MH-Bio/vaccine_dispenser/Final report/IMG_4544.JPG

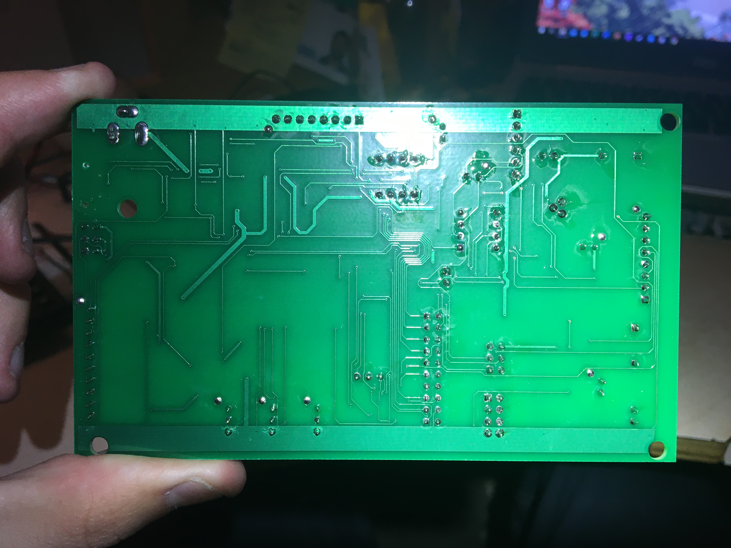
Final report/IMG_4544.JPG
