MH-Bio/vaccine_dispenser/Final report/Motor Driver.jpg

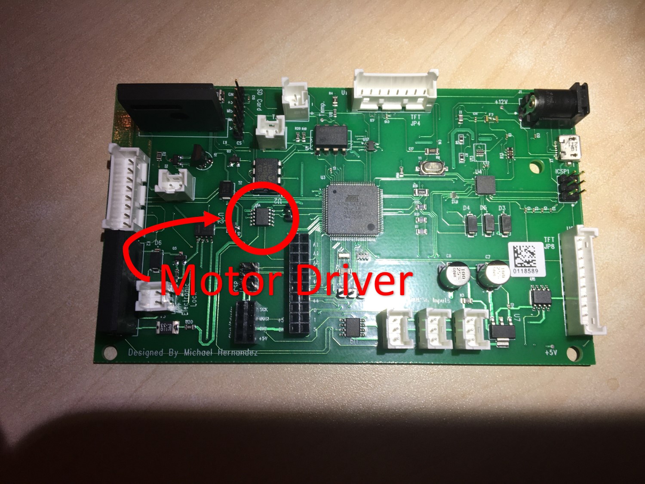
Final report/Motor Driver.jpg
