MH-Bio/vaccine_dispenser/Adarfuit Keypad Pinout.xlsx

 |  |  | NC | Row 4 | Row 3 | Row 2 | Row 1 | Column 3 | Column 2 | Column 1
# | 0 | * | 8 | 7 | 6 | 5 | 4 | 3 | 2 | 1
9 | 8 | 7 |  |  |  | 6 |  | 6
6 | 5 | 4 |  |  |  |  | 3 | 3
3 | 2 | 1 |  | # |  |  |  | #
 |  |  |  |  | 9 |  |  | 9
 |  |  |  |  |  |  | 1 |  |  | 1
 |  |  |  |  |  | 4 |  |  |  | 4
 |  |  |  |  | 7 |  |  |  |  | 7
 |  |  |  | * |  |  |  |  |  | *
 |  |  |  | 0 |  |  |  |  | 0
 |  |  |  |  | 8 |  |  |  | 8
 |  |  |  |  |  | 5 |  |  | 5
 |  |  |  |  |  |  | 2 |  | 2
