MH-Bio/vaccine_dispenser/Datasheets/lm317-linear-power-supply-regulator-15v3v45v5v6v9v_15a-1.jpg

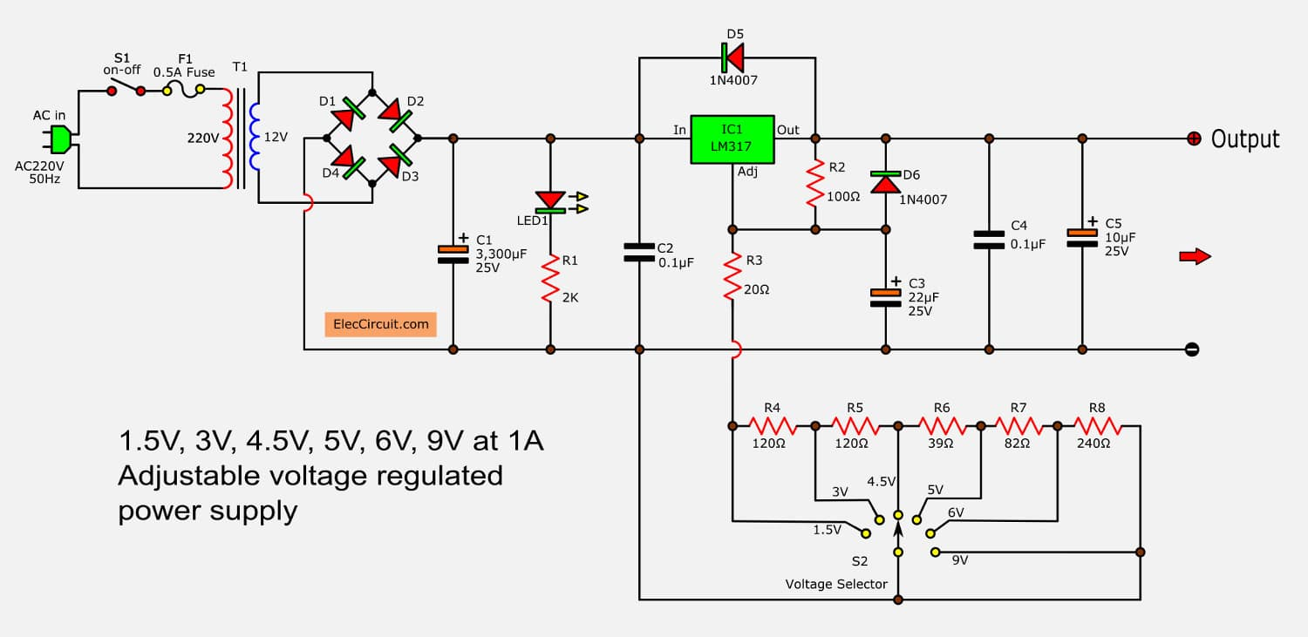
Datasheets/lm317-linear-power-supply-regulator-15v3v45v5v6v9v_15a-1.jpg
