MH-Bio/vaccine_dispenser/Datasheets/lock schematic.png

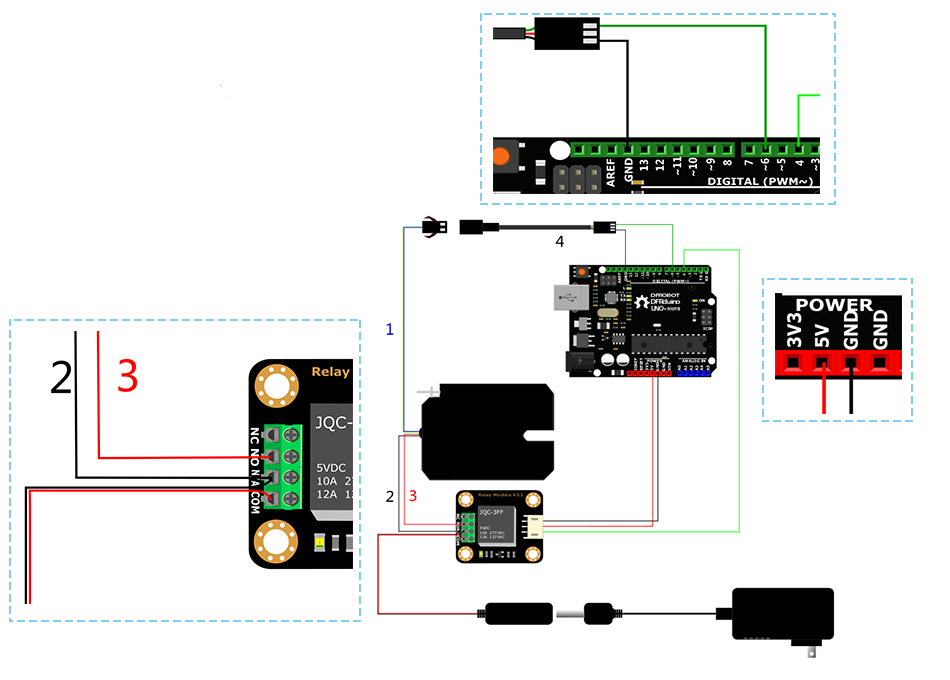
Datasheets/lock schematic.png
