MH-Bio/vaccine_dispenser/Final report/IMG_4545.JPG

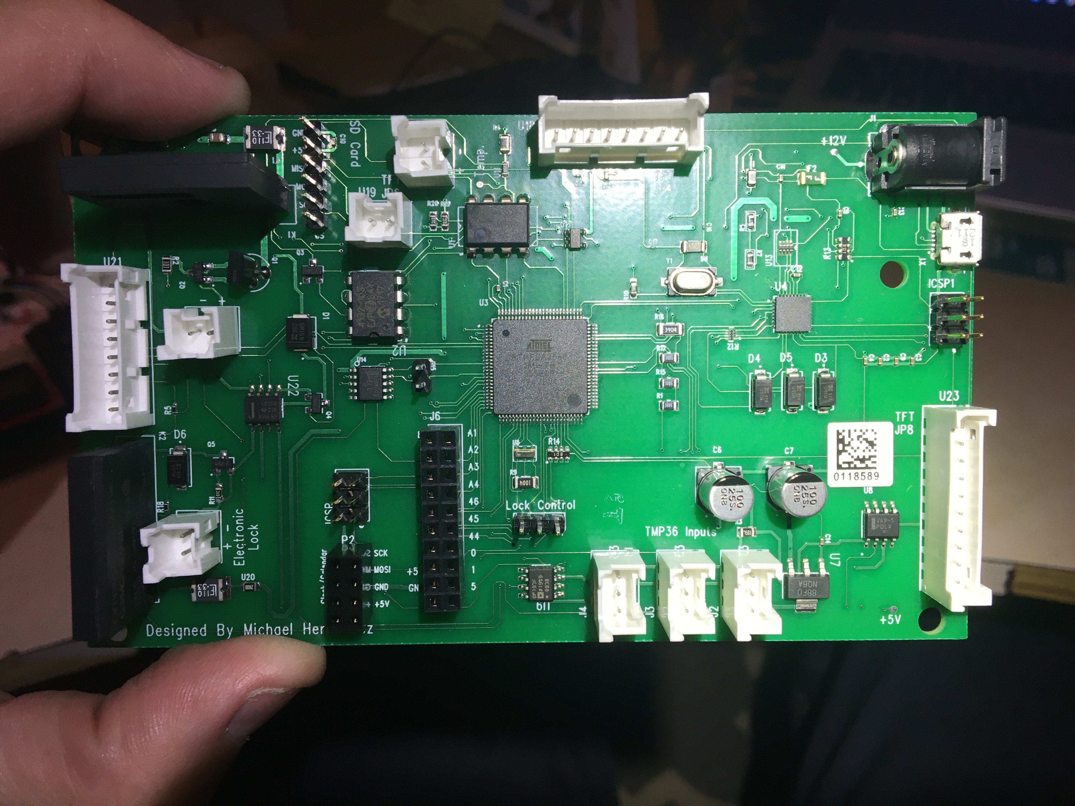
Final report/IMG_4545.JPG
