MH-Bio/vaccine_dispenser/Final report/Paper Images/charge controller prototype.JPG

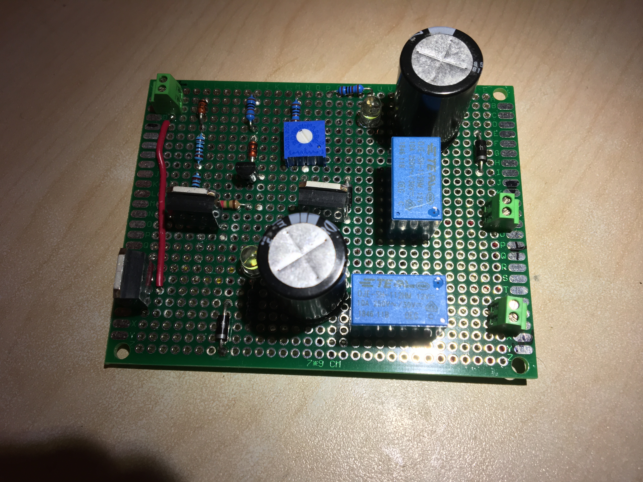
Final report/Paper Images/charge controller prototype.JPG
