MH-Bio/vaccine_dispenser/Final report/Paper Images/Cross Section 2.jpg

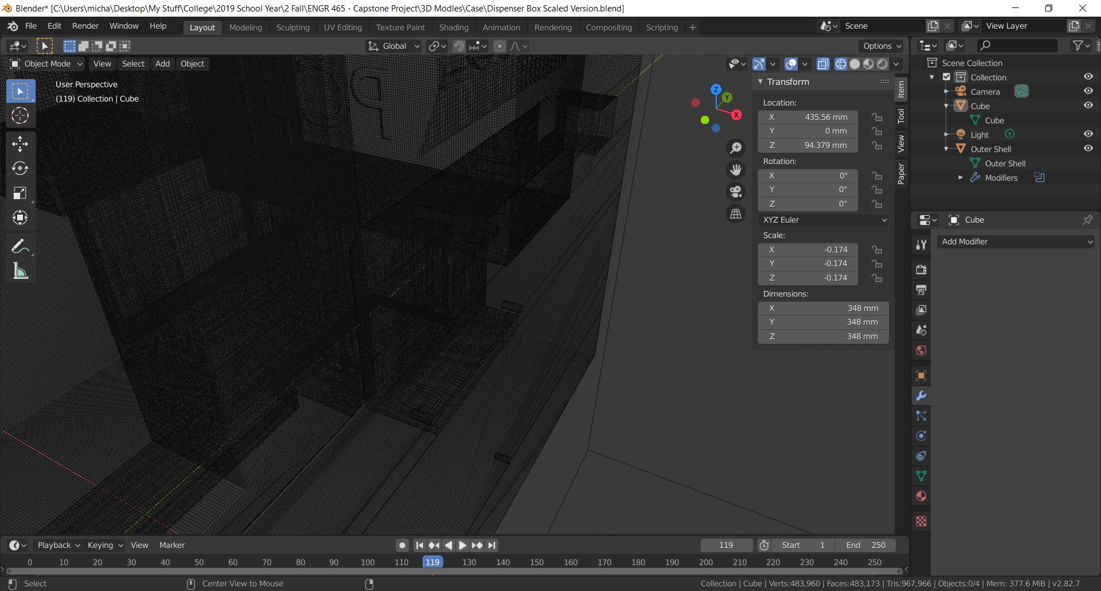
Final report/Paper Images/Cross Section 2.jpg
