MH-Bio/vaccine_dispenser/Final report/Paper Images/Cross Section 3.jpg

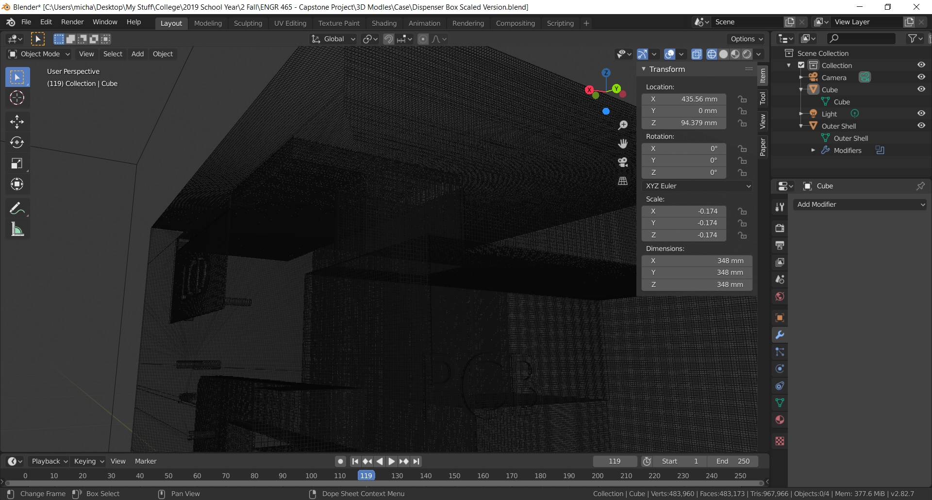
Final report/Paper Images/Cross Section 3.jpg
