MH-Bio/vaccine_dispenser/Final report/Paper Images/Cross Section 4.jpg

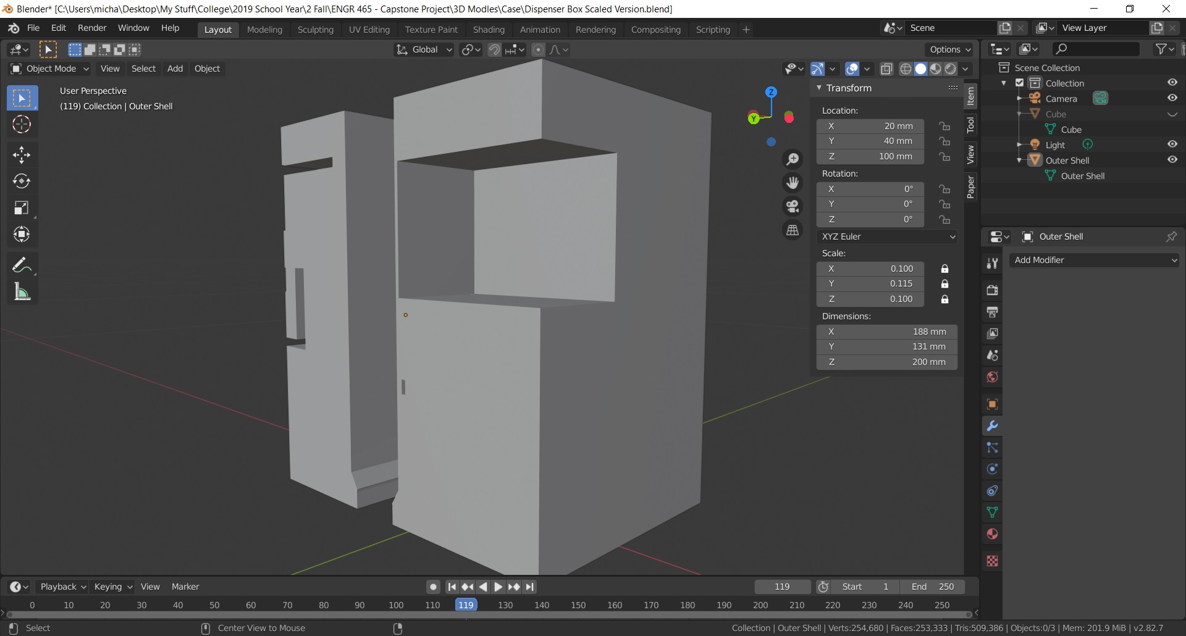
Final report/Paper Images/Cross Section 4.jpg
