MH-Bio/vaccine_dispenser/Final report/Paper Images/Cross Section 5.jpg

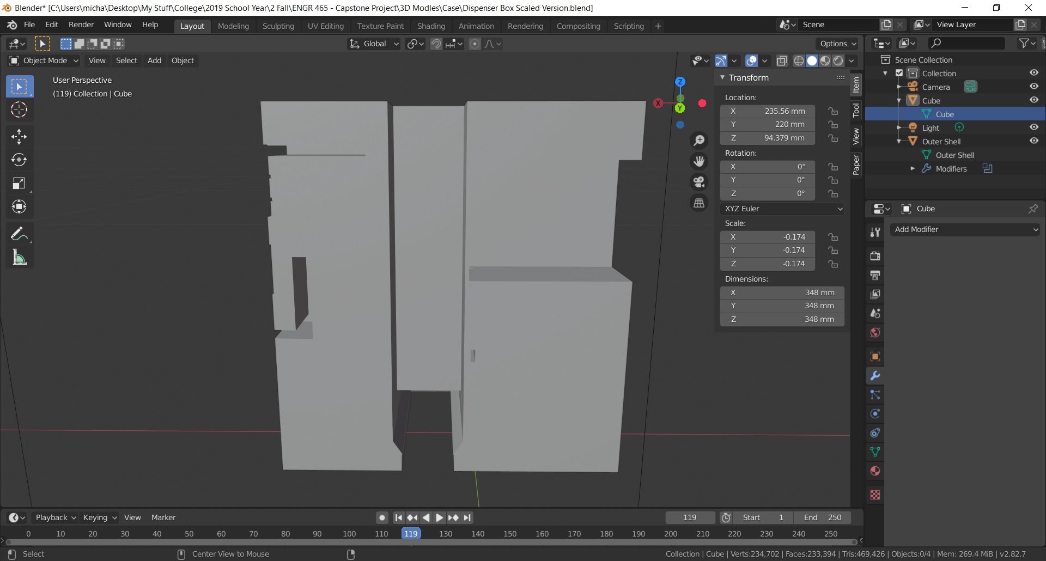
Final report/Paper Images/Cross Section 5.jpg
