MH-Bio/vaccine_dispenser/Final report/Paper Images/PCB Bottom Layer.JPG

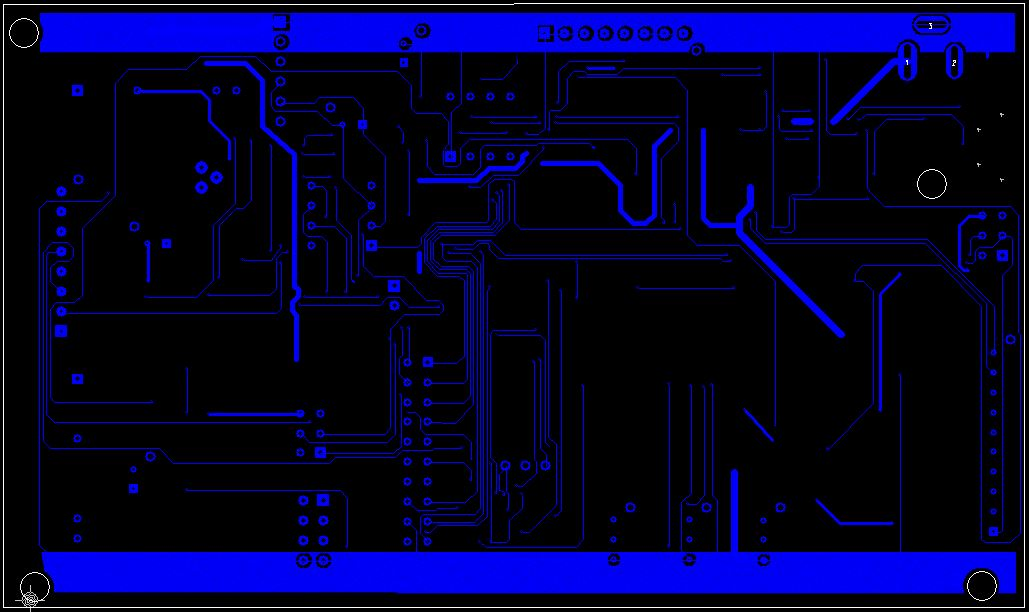
Final report/Paper Images/PCB Bottom Layer.JPG
