MH-Bio/vaccine_dispenser/Final report/Paper Images/PCB Top Layer.JPG

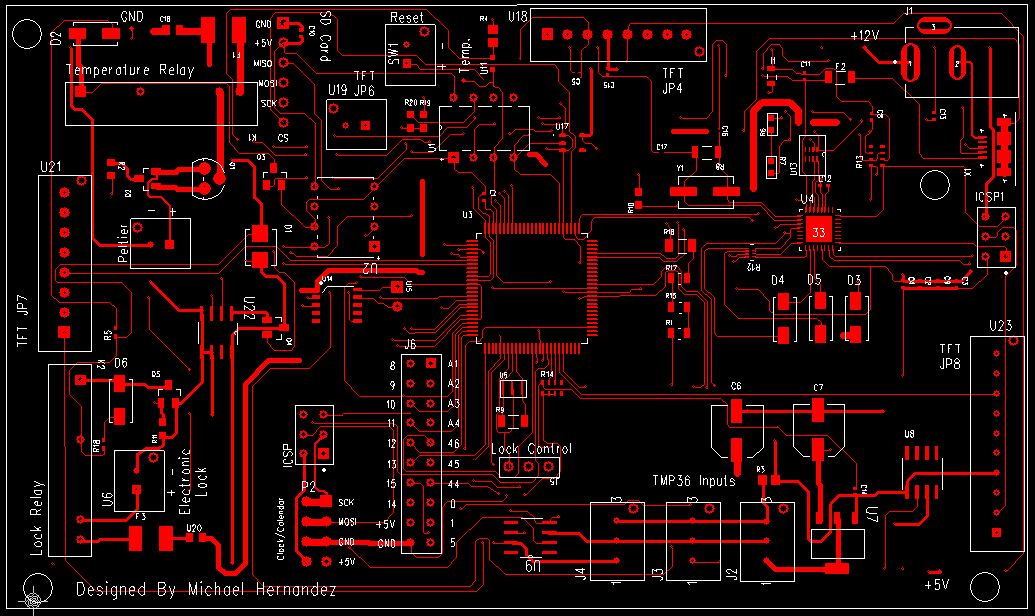
Final report/Paper Images/PCB Top Layer.JPG
