MH-Bio/vaccine_dispenser/Final report/Paper Images/Pseudocode Flowchart.jpg

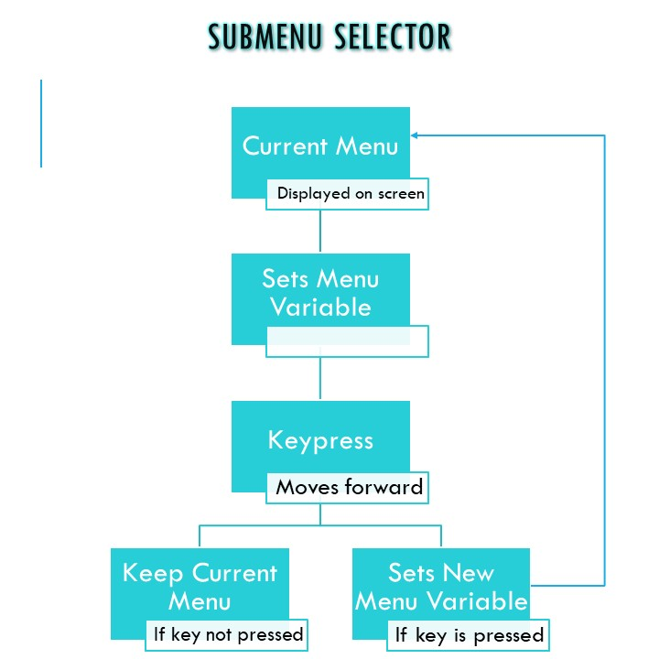
Final report/Paper Images/Pseudocode Flowchart.jpg
