MH-Bio/vaccine_dispenser/Final report/Paper Images/Reccomended TMP36 Circuit.JPG

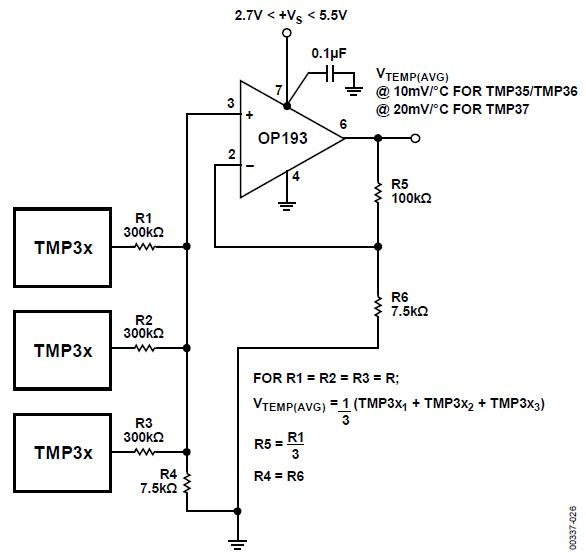
Final report/Paper Images/Reccomended TMP36 Circuit.JPG
