MH-Bio/vaccine_dispenser/Final report/Paper Images/reset button back.jpg

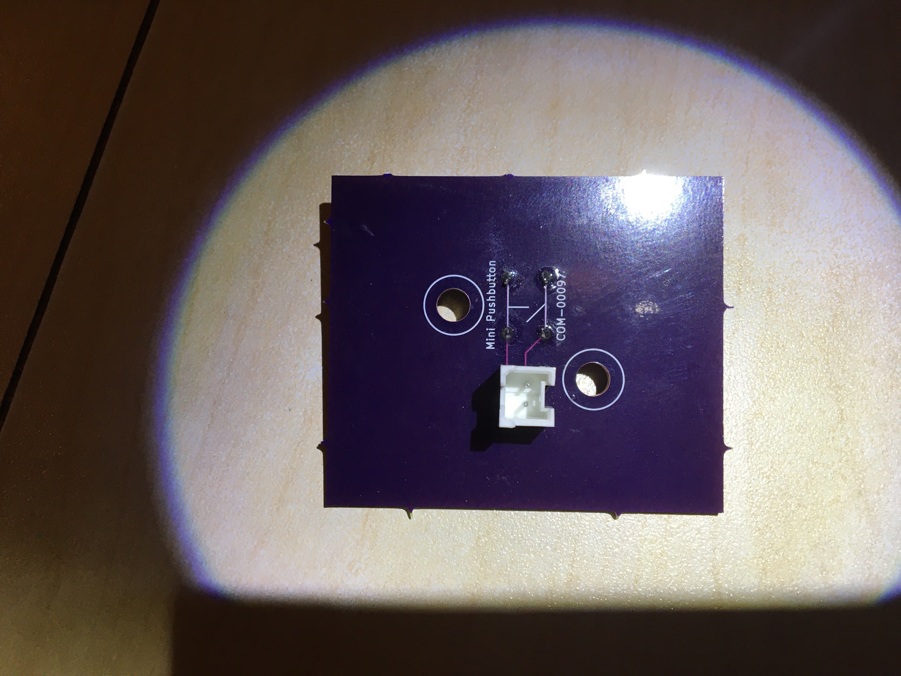
Final report/Paper Images/reset button back.jpg
