MH-Bio/vaccine_dispenser/Final report/Paper Images/reset button front.jpg

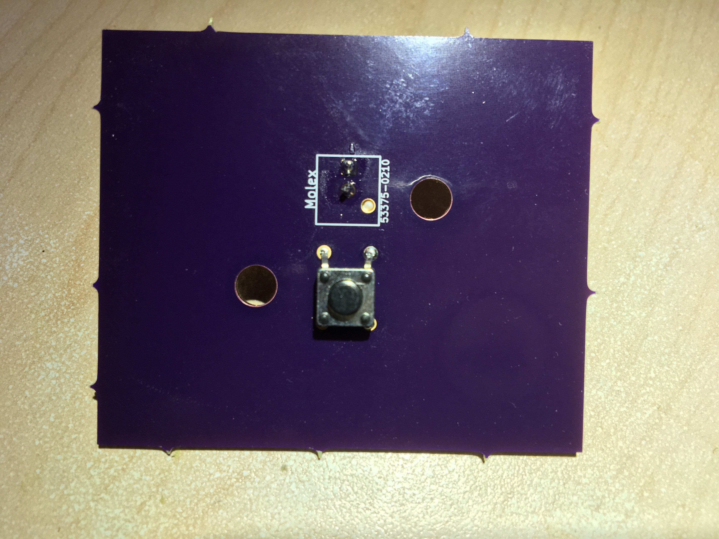
Final report/Paper Images/reset button front.jpg
