MH-Bio/vaccine_dispenser/Final report/Paper Images/TMP36 PCB.jpg

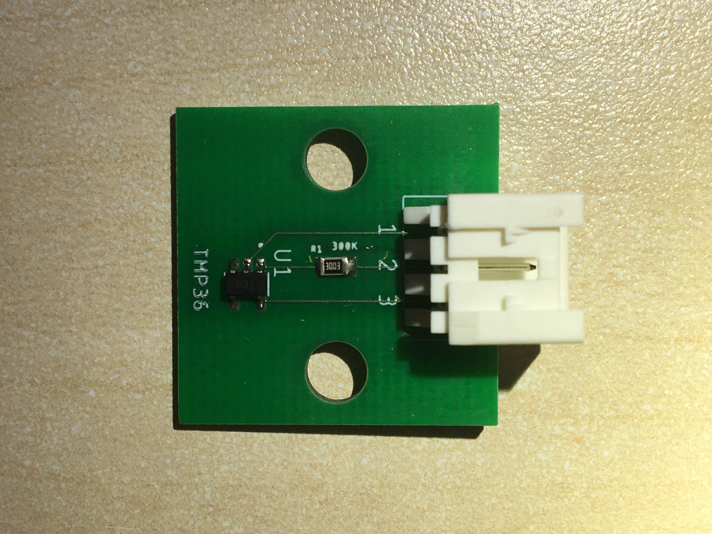
Final report/Paper Images/TMP36 PCB.jpg
