MH-Bio/vaccine_dispenser/Final report/Poster Images/cooling.jpg

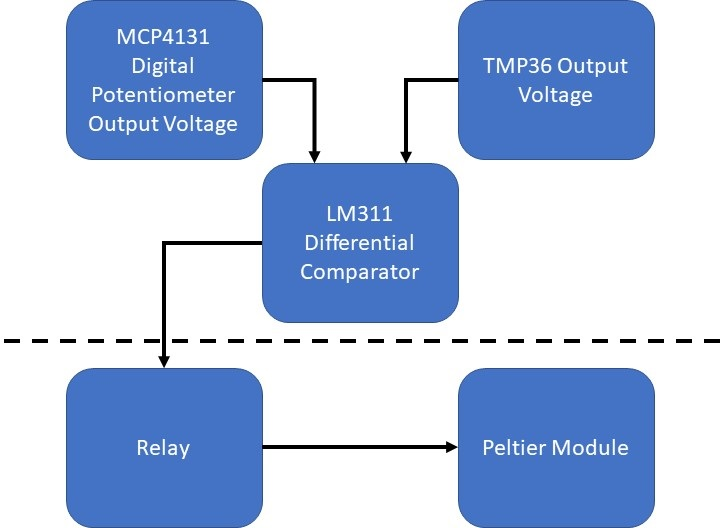
Final report/Poster Images/cooling.jpg
