MH-Bio/vaccine_dispenser/Final report/Poster Images/IMG_4513.JPG

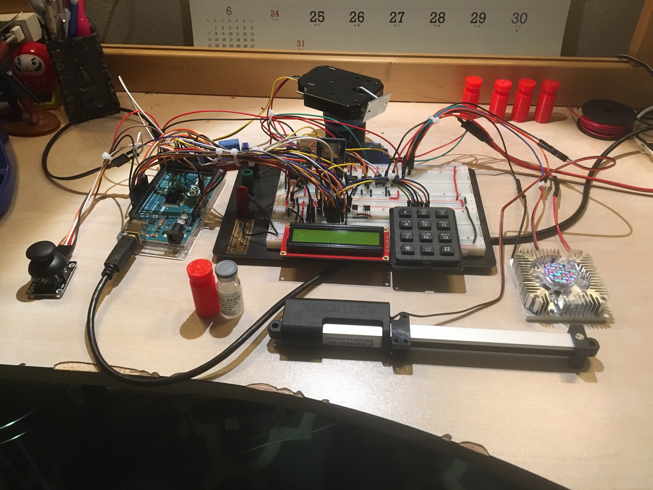
Final report/Poster Images/IMG_4513.JPG
