MH-Bio/vaccine_dispenser/Final report/Poster Images/IMG_4514.JPG

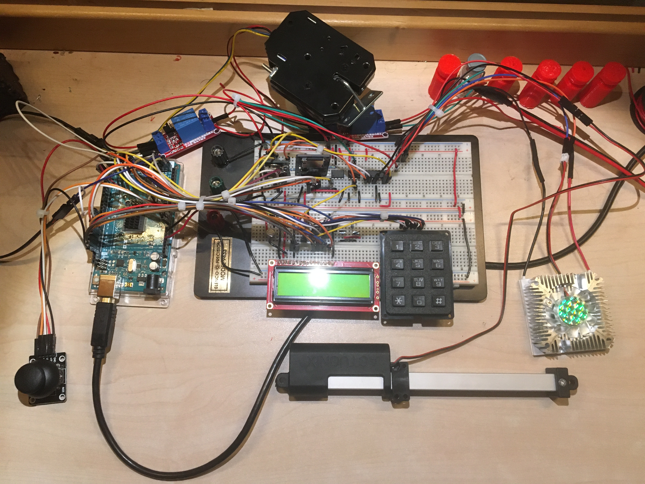
Final report/Poster Images/IMG_4514.JPG
