MH-Bio/vaccine_dispenser/Final report/Poster Images/PCB.jpg

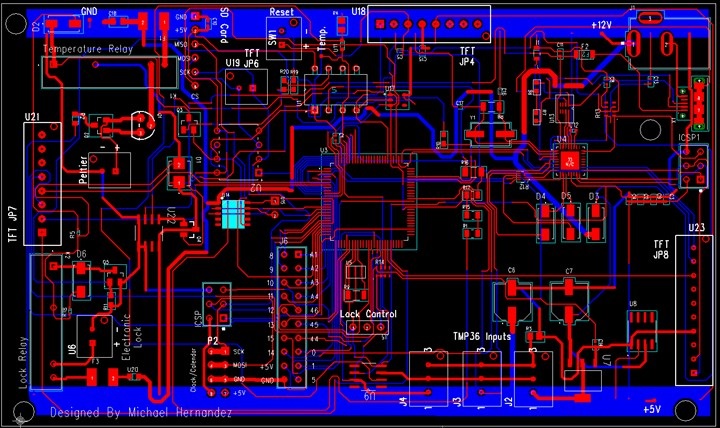
Final report/Poster Images/PCB.jpg
