MH-Bio/vaccine_dispenser/Final report/Poster Images/Report Figures.jpg

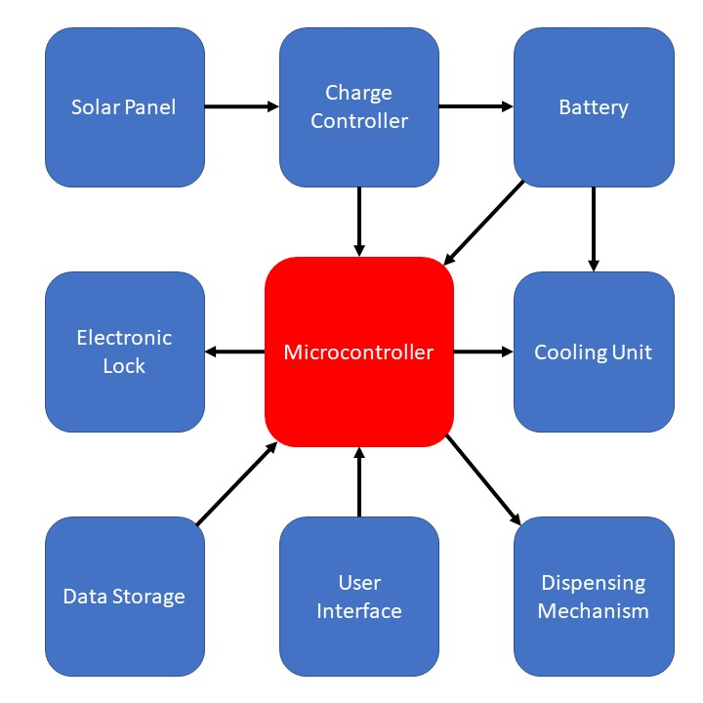
Final report/Poster Images/Report Figures.jpg
