MH-Bio/vaccine_dispenser/Final report/Poster Images/Track Acuator.png

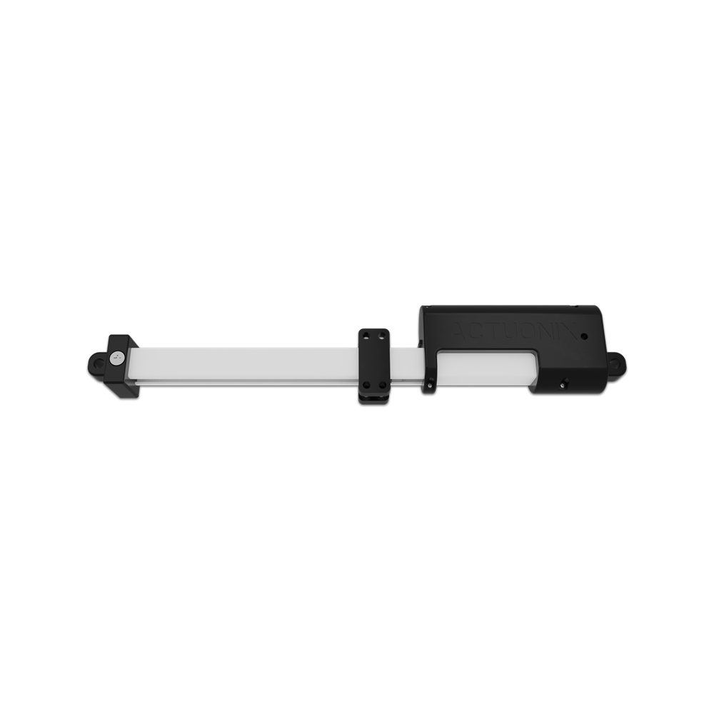
Final report/Poster Images/Track Acuator.png
