MH-Bio/vaccine_dispenser/Final report/Sizing.jpg

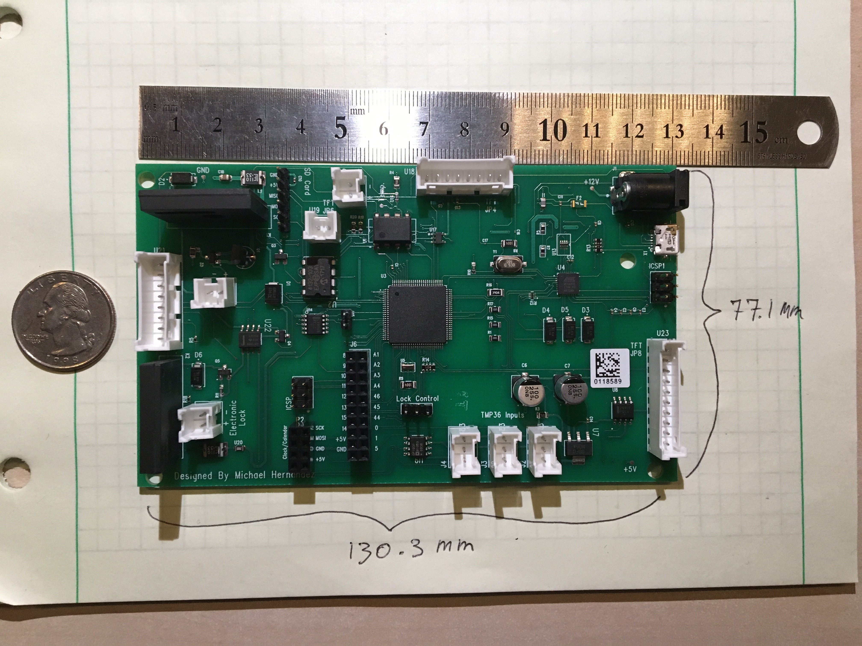
Final report/Sizing.jpg
