MH-Bio/vaccine_dispenser/Schematics/LED_sub_module.png

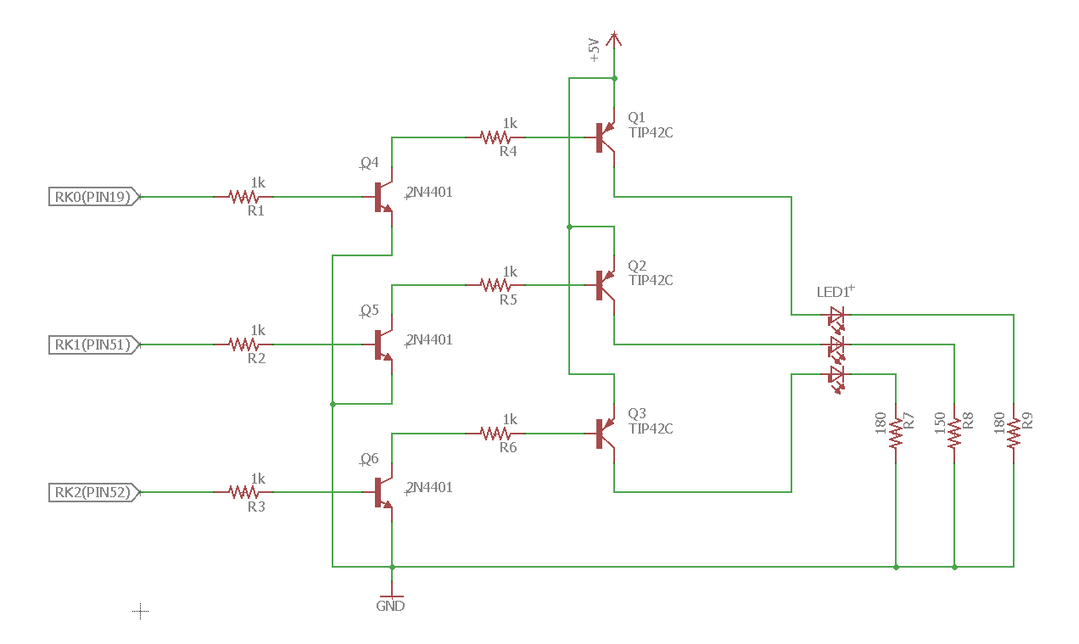
Schematics/LED_sub_module.png
