MH-Bio/vaccine_dispenser/Schematics/Solar Charge Controller/FEUT6J9ITV5755X.LARGE.jpg

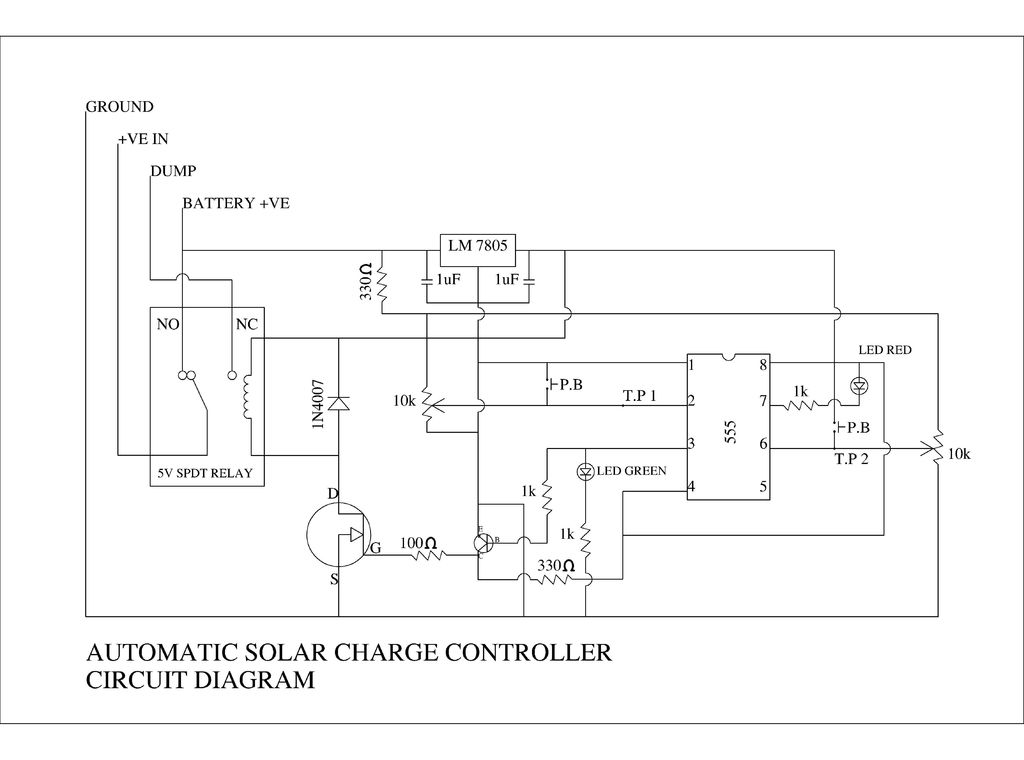
Schematics/Solar Charge Controller/FEUT6J9ITV5755X.LARGE.jpg
