MH-Bio/vaccine_dispenser/Bill of Materials.xlsx

Bill of material
Part | Manufacturer | Quantity | Price | Total | Notes
T16-S | Actuonix | 1 | $80.00 | $80.00 | Track Acuator
1216 | Energizer | 1 | $3.44 | $3.44 | Watch battery for clock
8541607316 | caryshop | 1 | $9.00 | $9.00 | Heatsink / Fan
12 V 20 A Charge Controller | GHB | 1 | $34.99 | $34.99 | Charge Controller
1824 Keypad | Adafruit | 1 | $10.34 | $10.34 | Adafruit Keypad
18965 Relay | SainSmart | 1 | $15.99 | $15.99 | Solid State Relay
8 GB microSDHC | Kingston | 1 | $3.99 | $3.99 | SD Card
AM-L02P25-1 | ECO-WORTHY | 1 | $38.78 | $38.78 | Solar Pannel
CP4055485 | CUI Devices | 1 | $71.61 | $71.61 | Peltier Module
CT6EP103 | Nidec Copal Electronics | 1 | $0.78 | $0.78 | 10K Analog Potentiometer
EXP1270 | ExpertPower | 1 | $18.99 | $18.99 | Battery
FIT0620 | DFRobot | 1 | $7.98 | $7.98 | Electronic Lock
GDM1602K | XIAMEN OCULAR | 1 | $16.95 | $16.95 | LCD Screen
LM311 | Texas Instruments | 1 | $0.50 | $0.50 | Differential Comparator
MCP41X1 | Microchip | 1 | $1.50 | $1.50 | Digital Potentiometer
MEGA 2560 | Arduino | 1 | $38.50 | $38.50 | Arduino
Micro SD Card Module | diymore | 1 | $1.70 | $1.70 | SD Card Mount
Pmod RTCC | Digilent | 1 | $8.99 | $8.99 | Real-time Clock / Calendar
TMP36 | Analog Devices | 1 | $1.50 | $1.50 | Temperature Sensor
WMYCONGCONG-13 | WMYCONGCONG | 1 | $1.30 | $1.30 | Joystick
 |  |  | Total | $366.83
