MH-Bio/vaccine_dispenser/Final report/PCB Bill of Materials.xlsx

Sheet: PCB BOM
Row Number | Part Number | Description | Manufacturer | Package | Reference | Price | Quantity | Total | Digikey Part Number
1 | 475890001 | Conn Micro USB Type AB RCP 5 POS 0.65mm Solder RA SMD 5 Terminal 1 Port T/R | MOLEX | MOLEX_0475890001 | X1 | $0.78 | 1 | $0.78 | WM17143CT-ND
2 | 61300311121 | Connector Header Through Hole 3 position 0.100" (2.54mm) | Würth Elektronik | 61300311121 | J5 | $0.13 | 1 | $0.13 | 732-5316-ND
3 | 61300611121 | Connector Header Through Hole 6 position 0.100" (2.54mm) | Würth Elektronik | 1X6 PIN CONNECTOR | P1 | $0.33 | 1 | $0.33 | 732-5319-ND
4 | 1812L110/33MR | Polymeric PTC Resettable Fuse 33V 1.1A Ih Surface Mount 1812 (4532 Metric), Concave | Littelfuse Inc. | 1812 | F3, F1 | $0.59 | 2 | $1.18 | F3486DKR-ND
5 | 3413.0113.22 | FUSE 500MA 63VDC FAST 1206 SMD | Schurter | FUS1206_24N_SCH | F2 | $0.60 | 1 | $0.60 | 3413.0113.22-ND
6 | 53375-0210 | Molex 2 pin vertical connector which will be used for peltier module | Molex | PELTIER_MODULE | PEL1, SW1 | $0.34 | 2 | $0.68 | WM3421-ND
7 | 53375-0210 | Connector Header Through Hole 2 position 0.098" (2.50mm) | Molex | 2 PIN VERTICAL MOLEX | U6, U19 | $0.34 | 2 | $0.68 | WM3421-ND
8 | 53375-0310 | Connector Header Through Hole 3 position 0.098" (2.50mm) | Molex | 53375-0310 | J2, J3, J4 | $0.43 | 3 | $1.29 | WM9816-ND
9 | 53375-0810 | Connector Header Through Hole 8 position 0.098" (2.50mm) | Molex | 8 PIN MOLEX | U21, U18 | $0.67 | 2 | $1.34 | WM13263-ND
10 | 53375-1010 | Connector Header Through Hole 10 position 0.098" (2.50mm) | Molex | MOLEX 10 PIN | U23 | $0.75 | 1 | $0.75 | WM12778-ND
11 | 6-534206-0 | 20 Position Receptacle Connector Through Hole | TE Connectivity AMP Connectors | TE_6-534206-0 | J6 | $4.68 | 1 | $4.68 | 6-534206-0
12 | 67997-206HLF | Conn; Rect; UnshroudedHdr; 6Cnts; ThruHole; BergStik; 2.54mmPin-Spng; Vert; DblRow | Raltron Electronics | FRAMATOME_67997-206HLF | ICSP1, ICSP | $0.66 | 2 | $1.32 | 2151-AS-16.000-18-ND
13 | ATMEGA2560 | Semiconductors and Actives, ic, Microprocessors, mcu, Microcontrollers | Microchip Technology | QFP50P1600X1600X120-100N | U3 | $11.85 | 1 | $11.85 | ATMEGA2560-16AU-ND
14 | ATMEGA8U2-MU | AVR AVR® ATmega Microcontroller IC 8-Bit 16MHz 8KB (4K x 16) FLASH 32-VQFN (5x5) | Microchip | QFN50P500X500X100-33N | U4 | $2.44 | 1 | $2.44 | ATMEGA8U2-MU-ND
15 | BLM21PG221SN1D | FERRITE CHIP 220 OHM 2000MA 0805 | Murata Electronics North America | IND0805N | I1 | $0.10 | 1 | $0.10 | 490-1054-2-ND
16 | C0402C105K9PACTU | CAP CERM 1UF 6.3V X5R 0402 | Kemet | CC0402N | C12 | $0.10 | 1 | $0.10 | 399-4873-2-ND
17 | CAY16-103J4LF | 10k Ohm }5% 62.5mW Power Per Element Isolated Resistor Network/Array }200ppm/ ‹C 1206 (3216 Metric), Convex, Long Side Terminals | Bourns Inc. | CAY16-J4 | R13, R14 | $0.10 | 2 | $0.20 | CAY16-103J4LFCT-ND
18 | CC0201JRNPO9BN220 | 22pF ±5% 50V Ceramic Capacitor C0G, NP0 0201 (0603 Metric) | Yageo | CAPC0201X13N | C5, C16, C17 | $0.10 | 3 | $0.30 | 311-1383-1-ND
19 | CL21A106KOQNNNG | 10µF ±10% 16V Ceramic Capacitor X5R 0805 (2012 Metric) | Samsung Electro-Mechanics | CAPC2012X140N | C18 |  | 1 |  | 1276-6455-2-ND
20 | CRCW080510M0DHEAP | 10 MOhms ±0.5% 0.125W, 1/8W Chip Resistor 0805 (2012 Metric) Automotive AEC-Q200 Thick Film | Vishay Dale | RESC2012X50N | R1, R15, R17 | $0.29 | 3 | $0.87 | 541-10MAZCT-ND
21 | CSTNE16M0V530000R0 | 16MHz Ceramic Resonator Built in Capacitor 15pF ±0.3% 40 Ohms -40°C ~ 85°C Surface Mount | Murata Electronics | CSTCE16M0V53-R0 | U5 | $0.29 | 1 | $0.29 | 490-17948-1-ND
22 | ECS-160-20-3X-TR | SMD QUARTZ CRYSTAL | Raltron Electronics | XTAL_ECS-160-20-3X-TR | Y1 | $0.66 | 1 | $0.66 | 2151-AS-16.000-18-ND
23 | EEE-1EA101XP | 100µF 25V Aluminum Electrolytic Capacitors Radial, Can - SMD 2000 Hrs @ 85°C | Panasonic Electronic Components | CAPAE660X800N | C6, C7 | $0.47 | 2 | $0.94 | PCE3898CT-ND
24 | ERA-3AEB104V | RES 100K OHM 1/10W .1% 0603 SMD | Panasonic - ECG | RC0603N | U11 | $0.34 | 1 | $0.34 | P100KDBTR-ND
25 | EXB-18V102JX | 1k Ohm }5% 31mW Power Per Element Isolated Resistor Network/Array }200ppm/ ‹C 0502 (1406 Metric), Long Side Terminals | Panasonic Electronic Components | RESCAXE40P140X60X45-8N | R12 | $0.10 | 1 | $0.10 | Y6102CT-ND
26 | EXB-28V220JX | RES ARRAY 22 OHM 5% 4 RES SMD | Panasonic - ECG | RN-EXB-28V | U13 | $0.10 | 1 | $0.10 | Y7220TR-ND
27 | FDN340P | P-Channel MOSFET Logic Level, PowerTrench MOSFET | Raltron Electronics | SSOT-3 | Q4 | $0.66 | 1 | $0.66 | 2151-AS-16.000-18-ND
28 | G3MC-202P DC5 | SSR RELAY SPST-NO 2A 75-264V | Omron Automation and Safety | RELAY_G3MB202PDC12 | K1, K2 | $6.96 | 2 | $13.92 | Z2985-ND
29 | GRM155R62A104KE14D | CAP CER 0.1UF 100V X5R 0402 | Murata Electronics | CAPC1005X55N | C1, C2, C3, C4, C8, C9, C10, C11, C13, C14, C15 | $0.66 | 11 | $7.26 | 2151-AS-16.000-18-ND
30 | LM1117MPX-5.0NOPB | IC REG LDO 800MA 3.3V | Raltron Electronics | SOT230P696X180-4N | U7 | $0.66 | 1 | $0.66 | 2151-AS-16.000-18-ND
31 | LM311P | IC DIFF COMP W/STROBE 8DIP | Texas Instruments | DIP8_300 | U1 | $0.51 | 1 | $0.51 | 296-1389-5-ND
32 | LM358DR | General Purpose Amplifier 2 Circuit 8-SOIC | Texas Instruments | SOIC127P600X175-8N(1) | U22 | $0.36 | 1 | $0.36 | 296-1014-6-ND
33 | LP2985-33DBVR | LP2985 150-mA Low-noise Low-dropout Regulator With Shutdown | Raltron Electronics | SOT95P280X145-5N | U17 | $0.66 | 1 | $0.66 | 2151-AS-16.000-18-ND
34 | LV8548MC-AH | 310030259 |  | SOIC10-1.0-5X4MM | U14 | $1.29 | 1 | $1.29
35 | MC33269D-5.0G | Linear Voltage Regulator IC 1 Output 800mA 8-SOIC | ON Semiconductor | SOIC127P600X265-8N | U8 | $0.81 | 1 | $0.81 | MC33269D-5.0GOS-ND
36 | MCP4132-103E/P | Single/Dual SPI Digital POT | Microchip Technology | DIP254P762X533-8 | U2 | $0.67 | 1 | $0.67
37 | MMBT3904 | MMBT3904 Series 40 V CE Breakdown 0.2 A NPN General Purpose Amplifier - SOT-23 | Diodes Incorporated | SOT95P240X120-3N | Q2, Q3, Q5 | $0.12 | 3 | $0.36 | MMBT3904-FDITR-ND
38 | OP193FSZ | Precision Operational Amplifiers | Raltron Electronics | SOIC127P600X175-8N | U9 | $0.66 | 1 | $0.66 | 2151-AS-16.000-18-ND
39 | PJ-202A | 2.0 mm Center Pin, 2.5 A, Right Angle, Through Hole, Kinked Pins, Dc Power Jack Connector | Raltron Electronics | CUI_PJ-202A | J1 | $0.66 | 1 | $0.66 | 2151-AS-16.000-18-ND
40 | PPPC042LFBN-RC | 8 Position Header Connector Through Hole | Sullins Connector Solutions | PPPC042LFBN-RC | P2 | $7.81 | 1 | $7.81 | S7107-ND
41 | PREC002SAAN-RC | Connector Header Through Hole 2 position 0.100" (2.54mm) | Sullins Connector Solutions | PREC002SAAN-RC | U15 | $0.06 | 1 | $0.06 | S1012EC-02-ND
42 | RC0603FR-0710KL | 10 kOhms ±1% 0.1W, 1/10W Chip Resistor 0603 (1608 Metric) Moisture Resistant Thick Film | Yageo | RESC1608X55 | R10, R11, R19, R20 | $0.66 | 4 | $2.64 | 2151-AS-16.000-18-ND
43 | RC0805FR-072RL | RES 2.00 OHM 1/8W 1% 0805 SMD | Yageo | RC0805N | U20 |  | 1 |  | 311-2.00CRTR-ND
44 | RG1005P-1.0K-B-T5 | Resistor Shape | Susumu | RC0402N | R5, R18 | $0.40 | 2 | $0.80 | RG10P1.0KBCT-ND
45 | RG3216P-3904-B-T1 | 3.9 MOhms ±0.1% 0.25W, 1/4W Chip Resistor 1206 (3216 Metric) Anti-Sulfur, Automotive AEC-Q200 Thin Film | Susumu | RESC3216X50N | R16 | $0.76 | 1 | $0.76 | 408-2036-1-ND
46 | RNCP0805FTD7K50 | 7.5 kOhms ±1% 0.25W, 1/4W Chip Resistor 0805 (2012 Metric) Anti-Sulfur, Moisture Resistant Thin Film | Stackpole Electronics Inc | RESC2012X60N | R3, R4 | $0.10 | 2 | $0.20 | RNCP0805FTD7K50DKR-ND
47 | RP73D2B1M0BTDF | Res Thin Film 1206 1M Ohm 0.1% 0.25W(1/4W) ±15ppm/C Epoxy SMD T/R | Raltron Electronics | RESC3015X65N | R8, R9 | $0.66 | 2 | $1.32 | 2151-AS-16.000-18-ND
48 | RR1220P-100-D | Resistor Shape | Susumu | RC0805N | R2 | $0.11 | 1 | $0.11 | RR12P100DCT-ND
49 | RS1MB-13-F | Diode Standard 1000V 1A Surface Mount SMB | Diodes Incorporated | DIONM4336X250N | D1 | $0.41 | 1 | $0.41 | RS1MB-FDICT-ND
50 | SMD-RES-VARISTOR-5V-28V(0603) | 314130003 | Bourns Inc. | R0603 | R6, R7 | $0.51 | 2 | $1.02 | CG0603MLC-05ECT-ND
51 | US1M-13-F | Diode, Fast Recovery, 1a, 1kv, Do-214ac-2, Full Reel | Diodes Incorporated | DIOM5226X240N | D2, D3, D5, D4, D6 | $0.41 | 5 | $2.05 | S1M-FDICT-ND
52 | ZTX689B | Bipolar (BJT) Transistor NPN 20V 3A 150MHz 1W Through Hole E-Line (TO-92 compatible) | Diodes Incorporated | TO-92 | Q1 | $1.02 | 1 | $1.02 | ZTX689B-ND
 |  |  |  |  |  |  | Total | $78.73

Sheet: Various BOM
Part | Manufacturer | Description | Cost
PCB Components | Various | See Figure 23 | $78.73
CP4055485 | CUI Devices | Peltier Module | $71.62
T16-S | Actuonix | Track Actuator | $80.00
1824 | Adafruit | 3x4 Matrix Keypad | $7.50
Solar Panel | ECO-WORTHY | Solar Panel | $37.93
Charge Controller | GHB | Charge Controller | $29.69
Joystick | WMYCONGCONG | Joystick | $1.30
GDM1602K | GDM1602K | LCD Screen | $16.95
Micro SD Card Module | Wishiot | SD Card PCB | $1.70
1738-FIT0620-ND | DFRobot | Electronic Lock | $7.98
1216 | Energizer | Coin Cell Battery | $2.35
COM-00097 | Sparkfun | Pushbutton Switch | $0.35
53375-0210 | Molex | Board to wire conn. | $0.34
Reset Button PCB | Osh Park | Reset Button PCB | $6.08
TMP36 PCB | SashaPCB* | TMP36 PCB | $13.02
Main PCB | Sunstone Circuits | PCB | $106.34
Case |  |  | $420.00
 |  |  | $881.88
