MH-Bio/vaccine_dispenser/Schematics/TMP36 BOM.xlsx

Row | Component | PCB Board | Total Order | Notes | Digi-Key
Row | Part | Description | Manufacturer | Package | Ref Des | Price | Quantity | Cost | Quantity | Cost | Notes | Part Number | Customer Reference
1 | 053426-0310 | Connector Header Through Hole, Right Angle 3 position 0.098" (2.50mm) | MOLEX | 053426-0310 | J1 | $0.43 | 1 | $0.43 | 4 | $1.72 |  | WM7586-ND | https://www.digikey.com/products/en?keywords=534260310
2 | TMP36GRTZ-REEL7 | Temp Sensor Analog(Voltage) Serial (2-Wire) 5-Pin Sot-23 T/R | Analog Devices Inc. | SOT95P280X145-5N | U1 | $1.75 | 1 | $1.75 | 4 | $7.00 |  | TMP36GTRZ-REEL7CT-ND | https://www.digikey.com/product-detail/en/analog-devices-inc/TMP36GRTZ-REEL7/TMP36GRTZ-REEL7CT-ND/1140633
3 | ERA-6AEB304V | RES 300K OHM 1/8W .1% 0805 SMD | Panasonic - ECG | RC0805N | U2 | $0.36 | 1 | $0.36 | 4 | $1.44 |  | P300KDATR-ND | https://www.digikey.com/product-detail/en/panasonic-electronic-components/ERA-6AEB304V/P300KDACT-ND/1466006
Total |  |  |  |  |  |  | 4 | $2.54 | 16 | $10.16
