MH-Bio/vaccine_dispenser/Schematics/Solar Charge Controller/BOM_solar charge controller.xlsx

ID | Name | Designator | Footprint | Quantity | Mounted
1 | IRFZ44N | Q1,Q2,Q3 | TO-220AB | 3 | Yes
2 | 2N3904 | Q4 | TO-92A | 1 | Yes
3 | 1N4740A | 10V | DO-41 | 1 | Yes
4 | 2k | R1 | AXIAL-0.3 | 1 | Yes
5 | 1N4744A | 15V | DO-41 | 1 | Yes
6 | 1k | R2,R4,R5,R8 | AXIAL-0.3 | 4 | Yes
7 | 1.5k | R3 | AXIAL-0.3 | 1 | Yes
8 | Relay_SPDT | U1,U2 | RELAY-SRD-12VDC | 2 | Yes
9 | 2200u | C1,C2 | CAP-D3.0XF1.5 | 2 | Yes
10 | -LED | U3,U4 | LED5 | 2 | Yes
11 | -DIODE | U5,U6,U7 | DIODE | 3 | Yes
12 | 10k | R6 | RES-ADJ_3386P | 1 | Yes
13 | 10k | R7 | AXIAL-0.3 | 1 | Yes
14 | SLI24MDC | U8 | NONE | 1 | Yes | SLI24MDC
