MH-Bio/vaccine_dispenser/Schematics/TMP36.xls

Row | Component | PCB Board | Total Order | Notes | Digi-Key
Row | Part | Description | Manufacturer | Package | Ref Des | Price | Quantity | Cost | Quantity | Cost | Notes | Part Number | Customer Reference
1 | 053426-0310 | Connector Header Through Hole, Right Angle 3 position 0.098" (2.50mm) | MOLEX | 053426-0310 | J1 |  | 1 |  | 4 |  |  | WM7586-ND
2 | TMP36GRTZ-REEL7 | Temp Sensor Analog(Voltage) Serial (2-Wire) 5-Pin Sot-23 T/R | Analog Devices Inc. | SOT95P280X145-5N | U1 |  | 1 |  | 4 |  |  | TMP36GTRZ-REEL7CT-ND
3 | ERA-6AEB304V | RES 300K OHM 1/8W .1% 0805 SMD | Panasonic - ECG | RC0805N | U2 |  | 1 |  | 4 |  |  | P300KDATR-ND
4 | PCB | Printed Circuit Board | Sunstone Circuits | - | - | $21.075 | 1 | $21.07 | 4 | $84.30 |  | - | -
Total |  |  |  |  |  |  | 4 | $21.07 | 16 | $84.30
