MH-Bio/vaccine_dispenser/3D Modles/Body1.stl

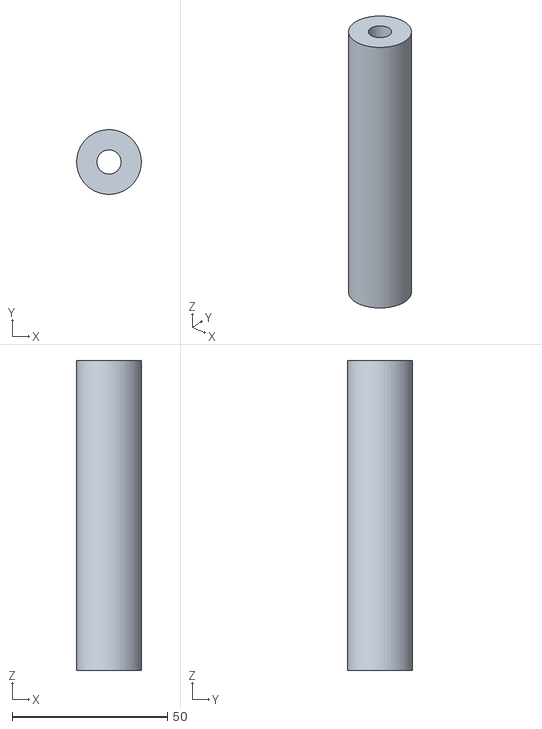
[picture p83: CAD file, 2023-05-29]
3D Modles/Body1.stl
20.9 x 20.9 x 100.0
