MH-Bio/vaccine_dispenser/3D Modles/Vial/Vial.stl

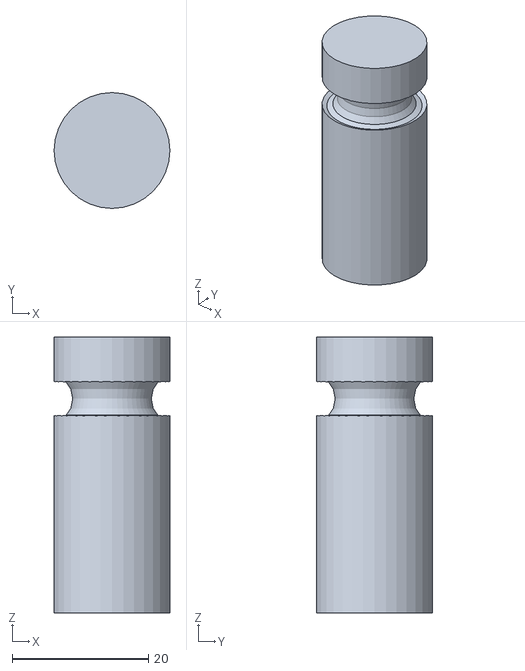
[picture p85: CAD file, 2023-05-29]
3D Modles/Vial/Vial.stl
17.0 x 17.0 x 40.5
