MH-Bio/vaccine_dispenser/3D Modles/T16_STP/t16_100mm.stp

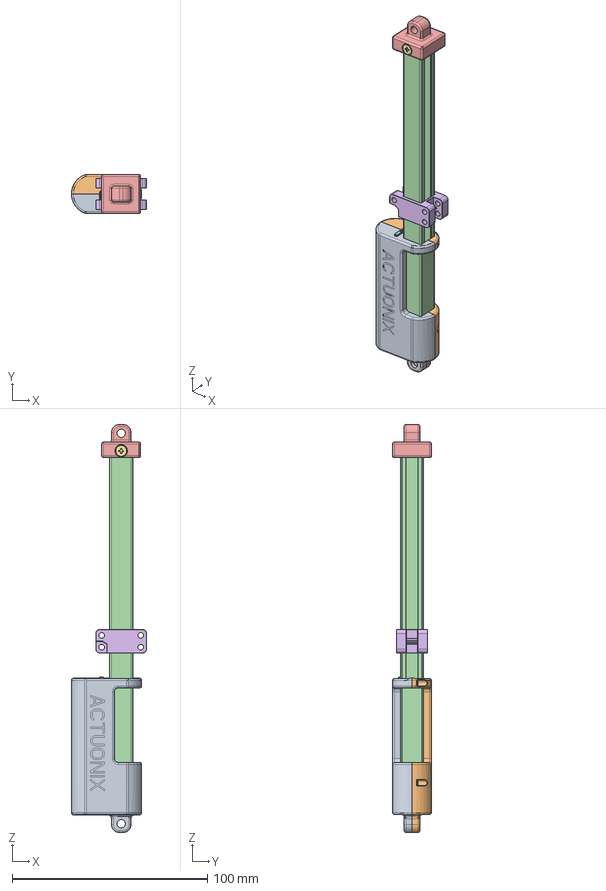
[picture p87: CAD file, 2023-05-29]
3D Modles/T16_STP/t16_100mm.stp
38.5 x 20.0 x 208.9 mm
CLAM_P16_BOT_10541
CLAM_P16_TOP_10542
FASTENER_10427 x 5
EXTENSION_10590_100MM
PLUG_10579
CARRIAGE_10589
FASTENER_10XXX x 2
GROMMET_3_HOLE
