MH-Bio/vaccine_dispenser/(list of files, cad)

Other CAD files:
3D Modles/Case/Dispenser Box Ver 3 - Copy - Copy.blend
3D Modles/Case/Dispenser Box Ver 3 - Copy.blend
3D Modles/Case/Dispenser Box Ver 3 - pre cuts.blend
3D Modles/Case/Dispenser Box Ver 3 Colorized.blend
3D Modles/Case/Dispenser Box Ver 3 Remesh.blend
3D Modles/Case/Dispenser Box Ver 3.blend
3D Modles/Case/Track Acuator Box.blend
3D Modles/Vial/Vial.blend
