MH-Bio/vaccine_dispenser/TFT Stuff/SC3A (3.5 in screen)/3.5inch_Arduino_ILI9486_V1.0/Arduino Demo_UNO&Mega2560/Install libraries/TouchScreen/README.txt

This is the 4-wire resistive touch screen firmware for Arduino. Works with all Arduinos and the Mega

To install, click DOWNLOAD SOURCE in the top right corner, and rename the uncompressed folder "TouchScreen". See our tutorial at http://www.ladyada.net/library/arduino/libraries.html on Arduino Library installation
