MH-Bio/vaccine_dispenser/Arduino Sketches/password test 2 backup 8.txt

// Vaccine dispenser
// Designer: Michael Hernandez
// https://michael-hernandez.info/

//********************************** Libraries that are to be used **********************************
#include <EventBuffer.h>
#include <Keypad.h>
#include <LiquidCrystal.h>
#include <SD.h>
#include <SPI.h>
//***************************************************************************************************

//***************************************** Global Variables ****************************************
char key0;
char key1;
char key2;
char key3;
char keypadCharacterpadInput = 0;
char menuChoice;
int currentMenu = 0;
int iDEntry = 0;
int keypadCharacterpadSelection = 0;
int menuCount = 0; // used to select which screen you are working in
//***************************************************************************************************

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

//************************************** keypadCharacterpad Stuff ***********************************
const byte ROWS = 4; // rows
const byte COLS = 3; // columns

char keys[ROWS][COLS] = {
  {'1', '2', '3'},
  {'4', '5', '6'},
  {'7', '8', '9'},
  {'*', '0', '#'}
};

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

Keypad keypad = Keypad( makeKeymap(keys), rowPins, colPins, ROWS, COLS );
//***************************************************************************************************

//**************************************** Language Variables ***************************************
bool englishFlag = true;
bool japaneseFlag = false; //日の丸です！
bool spanishFlag = false;
//***************************************************************************************************

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

//***************************************** Password Arrays *****************************************
boolean iDFlag [4] = {false, false, false, false}; // Used to check which place we are in the loop
char passwordInput [4] = {95, 95, 95, 95}; // stores the password values
char passwordMask [4] = {'_', '_', '_', '_'}; // what will be displayed for password values
char userID [4] = {'_', '_', '_', '_'}; // A blank array that will have four slots for a user input
char userIDCheck [4] = {'1', '2', '3', '4'}; // This is the "Correct" user ID that will be compared to the input
//***************************************************************************************************

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

  pinMode(SW_pin, INPUT);
  digitalWrite(SW_pin, HIGH);
  Serial.begin(9600);

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

//***************************************************************************************************
//***************************************************************************************************
//*********************************************** Loop **********************************************
//***************************************************************************************************
//***************************************************************************************************
void loop() {

  delay(200);  // delays the loop so that the LCD screen can actually be read

  joystickX = analogRead(X_pin);  // Allows the joystick to work in the X direction

  if (currentMenu < 10) {

    int mainMenu = menuSelect(joystickX, 2); // the number of menus is menu + 1, so 2 creates 3 menus

    switch (mainMenu) {

      //~~~~~~~~~~~~~~~~~~~~~~~~~~~~~~~~~~~~~~~~~~~ "to dispense" ~~~~~~~~~~~~~~~~~~~~~~~~~~~~~~~~~~~~~~~~~
      case 0:
        char keyInput;
        menuChoice = keypad.getKey();
        lcd.setCursor(0, 0);
        lcd.clear();
        lcd.print("To dispense");
        lcd.setCursor(1, 1);
        lcd.print("press #");
        currentMenu = 1;
        if (menuChoice == '#') { // if the entered character is #
          currentMenu = 10;  // Change the variable 'currentMenu', in order to select a dispense menu (between 10 & 20)
          key0 = 95; // resets keypadCharacterpad character.
        }
        else {
          currentMenu = currentMenu; // if # isn't entered, do nothing.
        }
        break; // break for case zero, ends 'to dispense' menu

      //~~~~~~~~~~~~~~~~~~~~~~~~~~~~~~~~~~~~~~~~~~~ "settings" ~~~~~~~~~~~~~~~~~~~~~~~~~~~~~~~~~~~~~~~~~
      case 1:
        lcd.clear();
        lcd.setCursor(0, 0);
        lcd.print("Settings");
        lcd.setCursor(1, 1);
        lcd.print("press #");
        if (menuChoice == '#') { // if the entered character is #
          currentMenu = 10;  // Change the variable 'currentMenu', in order to select a new menu
          key0 = 95; // resets keypadCharacterpad character.
        }
        else {
          currentMenu = currentMenu; // if # isn't entered, do nothing.
        }
        currentMenu = 2;
        break;

      //~~~~~~~~~~~~~~~~~~~~~~~~~~~~~~~~~~~~~~~~~~~~ "unlock" ~~~~~~~~~~~~~~~~~~~~~~~~~~~~~~~~~~~~~~~~~~
      case 2:
        lcd.clear();
        lcd.setCursor(0, 0);
        lcd.print("Unlock refill compartment"); // 25 characters
        for (int positionCounter = 0; positionCounter < 50; positionCounter++) {
          // scroll one position left:
          lcd.scrollDisplayLeft();
          // wait a bit:
          delay(350);
        }
        lcd.setCursor(1, 1);
        lcd.print("press #");
        currentMenu = 3;

    } // closing brace for mainMenu
  } // closing brace for if (currentMenu < 10)

  else if (currentMenu >= 10 && currentMenu < 20) { // Dispense submenu

    int dispenseMenu = menuSelect(joystickX, 1);

    switch (dispenseMenu) { // this block starts the dispense submenu

      //~~~~~~~~~~~~~~~~~~~~~~~~~~~~~~~~~~~~~~~~~~~ username input ~~~~~~~~~~~~~~~~~~~~~~~~~~~~~~~~~~~~~~~~~
      case 0:
        lcd.setCursor(0, 0);
        lcd.clear();
        lcd.print("Enter user ID:");

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

        break;  // this is the break for case 0, ends 'username input' menu

      //~~~~~~~~~~~~~~~~~~~~~~~~~~~~~~~~~~~~~~~~~~~ go back ~~~~~~~~~~~~~~~~~~~~~~~~~~~~~~~~~~~~~~~~~
      case 1:

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

        int previousSelect = keypadCharacterpadDecoder(menuChoice);

        if (previousSelect == 42) {
          currentMenu = 1;
          Serial.print("previousSelect: ");
          Serial.println(previousSelect);
          Serial.print("currentMenu: ");
          Serial.println(currentMenu);
          Serial.println(" ");
        }

        else {
          currentMenu = currentMenu;
        }

        break; // break for case 1, ends 'go back' menu

    } // switch(dispenseMenu) closing curly brace

  } // closing curly brace for (currentMenu >= 10 && currentMenu < 20) (username input)

  else if (currentMenu >= 20 && currentMenu < 30) {

    int passwordMenu = menuSelect(joystickX, 1);

    switch (passwordMenu) { // this block starts the password submenu

      //~~~~~~~~~~~~~~~~~~~~~~~~~~~~~~~~~~~~~~~~~~~ password input ~~~~~~~~~~~~~~~~~~~~~~~~~~~~~~~~~~~~~~~~~
      case 0:
        lcd.setCursor(0, 0);
        lcd.clear();
        lcd.print("Enter password: ");

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

        break;  // this is the break for case 0, ends 'password input' menu

      //~~~~~~~~~~~~~~~~~~~~~~~~~~~~~~~~~~~~~~~~~~~ go back ~~~~~~~~~~~~~~~~~~~~~~~~~~~~~~~~~~~~~~~~~
      case 1:

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

        int previousSelect = keypadCharacterpadDecoder(menuChoice);

        if (previousSelect == 42) {
          currentMenu = 1;
        }

        else {
          currentMenu = currentMenu;
        }

        break; // break for case 1, ends 'go back' menu

    } // closing brace for the switch statement

  } // closing curly brace for (currentMenu >= 20 && currentMenu < 30) (password input)

} // main loop closing curly brace

//***************************************************************************************************
//***************************************************************************************************
//********************************************* Functions *******************************************
//***************************************************************************************************
//***************************************************************************************************

//~~~~~~~~~~~~~~~~~~~~~~~~~~~~~~~~~~~~~~~~~~~~~~ arrayCheck ~~~~~~~~~~~~~~~~~~~~~~~~~~~~~~~~~~~~~~~~~
// Compares two arrays against each other, used for user ID and password input

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

  for (int i = 0; i < 4; i++) {

    if (array1[i] == array2[i]) {
      checkArrays[i] = true;
    }

    else {
      checkArrays[i] = false;
    }

  }

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

  if (counter == 4) {
    finalCheck = true;
  }

  else {
    finalCheck = false;
  }

  return finalCheck; // returns the final check variable as either true or false

}
//~~~~~~~~~~~~~~~~~~~~~~~~~~~~~~~~~~~~~~~~~~~~~~~~~~~~~~~~~~~~~~~~~~~~~~~~~~~~~~~~~~~~~~~~~~~~~~~~~~~

//~~~~~~~~~~~~~~~~~~~~~~~~~~~~~~~~~~~~~~~~~~~~~~ arrayInput ~~~~~~~~~~~~~~~~~~~~~~~~~~~~~~~~~~~~~~~~~
// Inputs values into the arary, can be recycled for both username and password.  This function takes
// an array to be modified as an input value, and does not return a value.

void arrayInput(char inputArray[], bool password) {

  // This block of code deals with the FIRST value of the array of interest
  if (key0 != NO_KEY && iDFlag[0] == false) { // conditions for entering the FIRST value in the array
    inputArray[0] = key0; // enter the value stored in the key0 variable to the first value of the input array
    passwordMask[0] = 42;
    lcd.setCursor(0, 1); // sets cursor at column 0, row 0

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

    iDFlag[0] = true; // set the first value of iDFlag to be true
  }

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

    iDFlag[1] = true; // set the second value of the iDFlag array equal to true
  }

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

  // This block deals with the THIRD value of the array of interest
  if (key2 != NO_KEY && iDFlag[2] == false) { // conditions for entering the THIRD value in the array
    inputArray[2] = key2; // input the value stored in the variable key2 into the third value in the input array
    passwordMask[2] = 42;
    lcd.setCursor(0, 1); // sets cursor at column 1, row 2

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

    iDFlag[2] = true; // set the third value of the iDFlag array equal to true
  }

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

    else {
      lcdDisplay(passwordMask, 3); // display three digits of the passwordMask array
    }
  }

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

    else {
      lcdDisplay(passwordMask, 4); // display four values on the passwordMask arrray
    }

    iDFlag[3] = true; // set the final value of the iDFlag array to be true
  }

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

    else { // if the input variable "password" is set to 1
      lcdDisplay(passwordMask, 4);  // dispaly four variables of the array passwordMask (display four *'s)
    }
  }

} // closing curly brace for the function
//~~~~~~~~~~~~~~~~~~~~~~~~~~~~~~~~~~~~~~~~~~~~~~~~~~~~~~~~~~~~~~~~~~~~~~~~~~~~~~~~~~~~~~~~~~~~~~~~~~~

//~~~~~~~~~~~~~~~~~~~~~~~~~~~~~~~~~~~~~~~~~~~~~ arrayReset ~~~~~~~~~~~~~~~~~~~~~~~~~~~~~~~~~~~~~~~~~~
// resets all values in a username or password array back to _
void arrayReset(char inputArray[]) {
  for (int i = 0; i < 4; i++) {
    inputArray[i] = '_';
  }
}

//~~~~~~~~~~~~~~~~~~~~~~~~~~~~~~~~~~~~~~~~~~~~~~~~~~~~~~~~~~~~~~~~~~~~~~~~~~~~~~~~~~~~~~~~~~~~~~~~~~~

//~~~~~~~~~~~~~~~~~~~~~~~~~~~~~~~~~~~~~~~~~~~~~~ flagReset ~~~~~~~~~~~~~~~~~~~~~~~~~~~~~~~~~~~~~~~~~~
// This function does not return any value.
// This function resets the ID flags used to determine which place in an array you are to enter a
// value
void flagReset() {

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

}
//~~~~~~~~~~~~~~~~~~~~~~~~~~~~~~~~~~~~~~~~~~~~~~~~~~~~~~~~~~~~~~~~~~~~~~~~~~~~~~~~~~~~~~~~~~~~~~~~~~~

//~~~~~~~~~~~~~~~~~~~~~~~~~~~~~~~~~~~~~~~~~~~~~ idFlagCount ~~~~~~~~~~~~~~~~~~~~~~~~~~~~~~~~~~~~~~~~~
// Counts the number of true variables in the iDFlag array.  For every true, we add a 1, for every
// false, we add a 0.  We then reutrn the total value of the count.
int idFlagCount() {

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

  return counter; // returns the value of the local variable

}
//~~~~~~~~~~~~~~~~~~~~~~~~~~~~~~~~~~~~~~~~~~~~~~~~~~~~~~~~~~~~~~~~~~~~~~~~~~~~~~~~~~~~~~~~~~~~~~~~~~~

//~~~~~~~~~~~~~~~~~~~~~~~~~~~~~~~~~~~~~~~~~~~~~~~ keyInput ~~~~~~~~~~~~~~~~~~~~~~~~~~~~~~~~~~~~~~~~~~
// This function allows the program to accept an input from the keypad for all four entries
void keyInput(bool isPassword) { // enter a 0 for not a password, and 1 for password.

  bool successCheck; // local variable used to move on to next menu if necessary

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

  else if (isPassword == true) { // if we are working with the password array
    successCheck = arrayCheck(passwordInput, userIDCheck); // compares userID against the predefined "password"
    if (successCheck == true) {
      lcd.clear();
      lcd.setCursor(0, 0); // sets cursor at column 0, row 0
      lcd.print("Success!");
    }
  }

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

}

//~~~~~~~~~~~~~~~~~~~~~~~~~~~~~~~~~~~~~~~~~~~~~~~~~~~~~~~~~~~~~~~~~~~~~~~~~~~~~~~~~~~~~~~~~~~~~~~~~~~

//~~~~~~~~~~~~~~~~~~~~~~~~~~~~~~~~~~~~~~ keypadCharacterpadDecoder ~~~~~~~~~~~~~~~~~~~~~~~~~~~~~~~~~~
// The keypadCharacterpadDecoder function takes an input from the keypadCharacter variable.
// It converts an ASCII input variable to a 0-9 integer.  # and * characters return their ASCII values.

int keypadCharacterpadDecoder(int keypadCharacter) {

  switch (keypadCharacter) {

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

    case 42: // 42 is the ASCII character for *
      keypadCharacterpadSelection = 42;
      break;

    case 48: // 48 is the ASCII character for 0
      keypadCharacterpadSelection = 48;
      break;

    case 49: // 49 is the ASCII character for 1
      keypadCharacterpadSelection = 49;
      break;

    case 50: // 50 is the ASCII character for 2
      keypadCharacterpadSelection = 50;
      break;

    case 51: // 51 is the ASCII character for 3
      keypadCharacterpadSelection = 51;
      break;

    case 52: // 52 is the ASCII character for 4
      keypadCharacterpadSelection = 52;
      break;

    case 53: // 53 is the ASCII character for 5
      keypadCharacterpadSelection = 53;
      break;

    case 54: // 54 is the ASCII character for 6
      keypadCharacterpadSelection = 54;
      break;

    case 55: // 55 is the ASCII character for 7
      keypadCharacterpadSelection = 55;
      break;

    case 56: // 56 is the ASCII character for 8
      keypadCharacterpadSelection = 56;
      break;

    case 57: // 57 is the ASCII character for 9
      keypadCharacterpadSelection = 57;
      break;

    default:
      keypadCharacterpadSelection = keypadCharacterpadSelection;
      break;
  }
  return keypadCharacterpadSelection; // returns the keypadCharacterpad number
}
//~~~~~~~~~~~~~~~~~~~~~~~~~~~~~~~~~~~~~~~~~~~~~~~~~~~~~~~~~~~~~~~~~~~~~~~~~~~~~~~~~~~~~~~~~~~~~~~~~~~

//~~~~~~~~~~~~~~~~~~~~~~~~~~~~~~~~~~~~~~~~~~~~~~~ keyReset ~~~~~~~~~~~~~~~~~~~~~~~~~~~~~~~~~~~~~~~~~~
// This void type function will reset the keypad inputs, key0-4 back to NO_KEY
void keyReset() {
  key0 = NO_KEY;
  key1 = NO_KEY;
  key2 = NO_KEY;
  key3 = NO_KEY;
}
//~~~~~~~~~~~~~~~~~~~~~~~~~~~~~~~~~~~~~~~~~~~~~~~~~~~~~~~~~~~~~~~~~~~~~~~~~~~~~~~~~~~~~~~~~~~~~~~~~~~

//~~~~~~~~~~~~~~~~~~~~~~~~~~~~~~~~~~~~~~~~~~~~~ lcdDisplay ~~~~~~~~~~~~~~~~~~~~~~~~~~~~~~~~~~~~~~~~~~
// This function, when called will display any number of digits on the LCD display
void lcdDisplay(char Array[], int digits) {
  switch (digits) {
    case 1:
      lcd.print(Array[0]);
      break;

    case 2:
      lcd.print(Array[0]);
      lcd.print(Array[1]);
      break;

    case 3:
      lcd.print(Array[0]);
      lcd.print(Array[1]);
      lcd.print(Array[2]);
      break;

    case 4:
      lcd.print(Array[0]);
      lcd.print(Array[1]);
      lcd.print(Array[2]);
      lcd.print(Array[3]);
      break;
  }
}
//~~~~~~~~~~~~~~~~~~~~~~~~~~~~~~~~~~~~~~~~~~~~~~~~~~~~~~~~~~~~~~~~~~~~~~~~~~~~~~~~~~~~~~~~~~~~~~~~~~~

//~~~~~~~~~~~~~~~~~~~~~~~~~~~~~~~~~~~~~~~~~~~~~ menuSelect ~~~~~~~~~~~~~~~~~~~~~~~~~~~~~~~~~~~~~~~~~~
// This function will allow the user to select a menu based on the joystick position, and return a
// variable which will be used to display the correct menu.  The returned variable is called
// menuCount.  This function allows you to control the total number of menus.

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

  else {
    menuCount = menuCount;  // if the joystick didn't move then keep the menu the same
  }

  return menuCount;  // return which menu you are working in.
}
//~~~~~~~~~~~~~~~~~~~~~~~~~~~~~~~~~~~~~~~~~~~~~~~~~~~~~~~~~~~~~~~~~~~~~~~~~~~~~~~~~~~~~~~~~~~~~~~~~~~

//~~~~~~~~~~~~~~~~~~~~~~~~~~~~~~~~~~~~~~~~~~ pound2Underscore ~~~~~~~~~~~~~~~~~~~~~~~~~~~~~~~~~~~~~~~
// This function will convert the ASCII input # to _
void pound2Underscore(char keypadArray[], int x) {
  if (keypadArray[x] == 35) { // if the entered value is #
    keypadArray[x] = 95; // change the entered value to _
  }
  else {
    keypadArray[x] = keypadArray[x]; // otherwise keep whatever the original value was
  }
}
//~~~~~~~~~~~~~~~~~~~~~~~~~~~~~~~~~~~~~~~~~~~~~~~~~~~~~~~~~~~~~~~~~~~~~~~~~~~~~~~~~~~~~~~~~~~~~~~~~~~

//***************************************************************************************************
//*********************************************** Notes *********************************************
//***************************************************************************************************

//~~~~~~~~~~~~~~~~~~~~~~~~~~~~~~~~~~~~~~~~~ ASCII Cheat Sheet ~~~~~~~~~~~~~~~~~~~~~~~~~~~~~~~~~~~~~~~
// # => 35
// * => 42
// 0 => 48
// 1 => 49
// 2 => 50
// 3 => 51
// 4 => 52
// 5 => 53
// 6 => 54
// 7 => 55
// 8 => 56
// 9 => 57
// _ => 95

//~~~~~~~~~~~~~~~~~~~~~~~~~~~~~~~~~~~~~~~~~~~~~~~~~ Links ~~~~~~~~~~~~~~~~~~~~~~~~~~~~~~~~~~~~~~~~~~~
// Micro SD Card Tutorial: https://www.instructables.com/id/Micro-SD-Card-Tutorial/
// Writing functions: https://www.arduino.cc/en/Reference/FunctionDeclaration
// ASCII chart: https://theasciicode.com.ar/ascii-control-characters/null-character-ascii-code-0.html
// Adafruit keypadCharacterpad Demo: https://www.adafruit.com/product/3845
