MH-Bio/vaccine_dispenser/Arduino Sketches/password test 3 backup 5.txt

// In this version I successfully implimented the lock after password entry
// Vaccine dispenser
// Designer: Michael Hernandez
// https://michael-hernandez.info/

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

//***************************************** Global Variables ****************************************
bool menuChangeFlag = false; // used for the unlock refill compartment submenu
bool lockActivated = false; // used in the unlock function to check if the lock has been unlocked
bool unlockFlag = false;
char key0;
char key1;
char key2;
char key3;
char keypadCharacterpadInput = 0;
char menuChoice;
int currentMenu = 0;
int dispenseMenu = 0;
int iDEntry = 0;
int keypadCharacterpadSelection = 0;
int mainMenu = 0;
int menuCount = 0; // used to select which screen you are working in
int settingsMenu = 0;
int passwordMenu = 0;
int lockPullupResistorPin = 6; // This sets the pin that will be used as the lock's pullup resistor
int lockRelayPin = 4; // Sets the pin that will be used to communicate with the lock
//***************************************************************************************************

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

//************************************** keypadCharacterpad Stuff ***********************************
const byte ROWS = 4; // rows
const byte COLS = 3; // columns

char keys[ROWS][COLS] = {
  {'1', '2', '3'},
  {'4', '5', '6'},
  {'7', '8', '9'},
  {'*', '0', '#'}
};

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

Keypad keypad = Keypad( makeKeymap(keys), rowPins, colPins, ROWS, COLS );
//***************************************************************************************************

//**************************************** Language Variables ***************************************
bool englishFlag = true;
bool japaneseFlag = false; //日の丸です！
bool spanishFlag = false;
//***************************************************************************************************

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

//**************************************** Temperature Stuff ****************************************
int currentTemperature = 0;
int temperaturePin = 2; // analog pin A2
//***************************************************************************************************

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

  pinMode(SW_pin, INPUT); // Joystick pin
  digitalWrite(SW_pin, HIGH); // joystick pin

  pinMode(lockPullupResistorPin, INPUT_PULLUP);  // sets up the pullup resistor
  pinMode(lockRelayPin, OUTPUT); // sets the pin connected to the lock relay as an output

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

//***************************************************************************************************
//***************************************************************************************************
//*********************************************** Loop **********************************************
//***************************************************************************************************
//***************************************************************************************************
void loop() {

  delay(200);  // delays the loop so that the LCD screen can actually be read

  joystickX = analogRead(X_pin);  // Allows the joystick to work in the X direction

  if (currentMenu < 10) {

    mainMenu = menuSelect(joystickX, 2); // the number of menus is menu + 1, so 2 creates 3 menus

    //~~~~~~~~~~~~~~~~~~~~~~~~~~~~~~~~~~~~~~~~~~~~~~~~~~~~~~~~~~~~~~~~~~~~~~~~~~~~~~~~~~~~~~~~~~~~~~~~~~~
    //~~~~~~~~~~~~~~~~~~~~~~~~~~~~~~~~~~~~~~~~~~~~~ Main Menu ~~~~~~~~~~~~~~~~~~~~~~~~~~~~~~~~~~~~~~~~~~~
    //~~~~~~~~~~~~~~~~~~~~~~~~~~~~~~~~~~~~~~~~~~~~~~~~~~~~~~~~~~~~~~~~~~~~~~~~~~~~~~~~~~~~~~~~~~~~~~~~~~~

    switch (mainMenu) {

      //~~~~~~~~~~~~~~~~~~~~~~~~~~~~~~~~~~~~~~~~~~~ "to dispense" ~~~~~~~~~~~~~~~~~~~~~~~~~~~~~~~~~~~~~~~~~
      case 0:
        menuChoice = keypad.getKey();
        lcd.setCursor(0, 0);
        lcd.clear();
        lcd.print("To dispense");
        lcd.setCursor(1, 1);
        lcd.print("press #");
        currentMenu = 1;
        if (menuChoice == '#') { // if the entered character is #
          currentMenu = 10;  // Change the variable 'currentMenu', in order to select a dispense menu (between 10 & 20)
          key0 = 95; // resets keypadCharacterpad character.
        }
        else {
          currentMenu = currentMenu; // if # isn't entered, do nothing.
        }
        break; // break for case zero, ends 'to dispense' menu

      //~~~~~~~~~~~~~~~~~~~~~~~~~~~~~~~~~~~~~~~~~~~ "settings" ~~~~~~~~~~~~~~~~~~~~~~~~~~~~~~~~~~~~~~~~~
      case 1:
        menuChangeFlag = false;
        menuChoice = keypad.getKey();
        lcd.clear();
        lcd.setCursor(0, 0);
        lcd.print("Settings");
        lcd.setCursor(1, 1);
        lcd.print("press #");
        if (menuChoice == '#') { // if the entered character is #
          currentMenu = 30;  // Change the variable 'currentMenu', in order to select a new menu
        }
        else {
          currentMenu = currentMenu; // if # isn't entered, do nothing.
        }
        break;

      //~~~~~~~~~~~~~~~~~~~~~~~~~~~~~~~~~~~~~~~~~~~~ "unlock" ~~~~~~~~~~~~~~~~~~~~~~~~~~~~~~~~~~~~~~~~~~
      case 2:

        char keyInput; // creates a local variable to read the keypad

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

        else if (menuChangeFlag == true && currentMenu >= 10) {
          dispenseMenu = 0;
          joystickX = 0.0;
          break;
        }

        else {
          for (int i = 0; i < 25; i++) {

            joystickX = analogRead(X_pin);  // Allows the joystick to work in the X direction

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

            keyInput = keypad.getKey();

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

            else {
              currentMenu = currentMenu; // if # isn't entered, do nothing.
            }

          }
        }
    } // closing brace for mainMenu
  } // closing brace for if (currentMenu < 10)

  //~~~~~~~~~~~~~~~~~~~~~~~~~~~~~~~~~~~~~~~~~~~~~~~~~~~~~~~~~~~~~~~~~~~~~~~~~~~~~~~~~~~~~~~~~~~~~~~~~~~
  //~~~~~~~~~~~~~~~~~~~~~~~~~~~~~~~~~~~~~~~~~~ Dispense Menu ~~~~~~~~~~~~~~~~~~~~~~~~~~~~~~~~~~~~~~~~~~
  //~~~~~~~~~~~~~~~~~~~~~~~~~~~~~~~~~~~~~~~~~~~~~~~~~~~~~~~~~~~~~~~~~~~~~~~~~~~~~~~~~~~~~~~~~~~~~~~~~~~

  else if (currentMenu >= 10 && currentMenu < 20) { // Dispense submenu

    dispenseMenu = menuSelect(joystickX, 1);

    switch (dispenseMenu) { // this block starts the dispense submenu

      //~~~~~~~~~~~~~~~~~~~~~~~~~~~~~~~~~~~~~~~~~~~ username input ~~~~~~~~~~~~~~~~~~~~~~~~~~~~~~~~~~~~~~~~~
      case 0:
        lcd.setCursor(0, 0);
        lcd.clear();
        lcd.print("Enter user ID:");

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

        break;  // this is the break for case 0, ends 'username input' menu

      //~~~~~~~~~~~~~~~~~~~~~~~~~~~~~~~~~~~~~~~~~~~ go back ~~~~~~~~~~~~~~~~~~~~~~~~~~~~~~~~~~~~~~~~~
      case 1:

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

        int previousSelect = keypad.getKey();

        if (previousSelect == 42) {
          currentMenu = 1;
        }

        else {
          currentMenu = currentMenu;
        }

        break; // break for case 1, ends 'go back' menu

    } // switch(dispenseMenu) closing curly brace

  } // closing curly brace for (currentMenu >= 10 && currentMenu < 20) (username input)

  //~~~~~~~~~~~~~~~~~~~~~~~~~~~~~~~~~~~~~~~~~~~~~~~~~~~~~~~~~~~~~~~~~~~~~~~~~~~~~~~~~~~~~~~~~~~~~~~~~~~
  //~~~~~~~~~~~~~~~~~~~~~~~~~~~~~~~~~~~~~~~~~~~ Password Menu ~~~~~~~~~~~~~~~~~~~~~~~~~~~~~~~~~~~~~~~~~
  //~~~~~~~~~~~~~~~~~~~~~~~~~~~~~~~~~~~~~~~~~~~~~~~~~~~~~~~~~~~~~~~~~~~~~~~~~~~~~~~~~~~~~~~~~~~~~~~~~~~

  else if (currentMenu >= 20 && currentMenu < 30) { // this is for the password input

    passwordMenu = menuSelect(joystickX, 1);

    switch (passwordMenu) { // this block starts the password submenu

      //~~~~~~~~~~~~~~~~~~~~~~~~~~~~~~~~~~~~~~~~~~~ password input ~~~~~~~~~~~~~~~~~~~~~~~~~~~~~~~~~~~~~~~~~
      case 0:
        lcd.setCursor(0, 0);
        lcd.clear();
        lcd.print("Enter password: ");

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

        break;  // this is the break for case 0, ends 'password input' menu

      //~~~~~~~~~~~~~~~~~~~~~~~~~~~~~~~~~~~~~~~~~~~ go back ~~~~~~~~~~~~~~~~~~~~~~~~~~~~~~~~~~~~~~~~~
      case 1:

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

        int previousSelect = keypad.getKey();

        if (previousSelect == 42) {
          currentMenu = 1;
        }

        else {
          currentMenu = currentMenu;
        }

        break; // break for case 1, ends 'go back' menu

    } // closing brace for the switch statement

  } // closing curly brace for (currentMenu >= 20 && currentMenu < 30) (password input)

  //~~~~~~~~~~~~~~~~~~~~~~~~~~~~~~~~~~~~~~~~~~~~~~~~~~~~~~~~~~~~~~~~~~~~~~~~~~~~~~~~~~~~~~~~~~~~~~~~~~~
  //~~~~~~~~~~~~~~~~~~~~~~~~~~~~~~~~~~~~~~~~~~~ Settings Menu ~~~~~~~~~~~~~~~~~~~~~~~~~~~~~~~~~~~~~~~~~
  //~~~~~~~~~~~~~~~~~~~~~~~~~~~~~~~~~~~~~~~~~~~~~~~~~~~~~~~~~~~~~~~~~~~~~~~~~~~~~~~~~~~~~~~~~~~~~~~~~~~
  else if (currentMenu >= 30 && currentMenu < 40) { // this is the settings menu

    settingsMenu = menuSelect(joystickX, 1);

    switch (settingsMenu) {

      //~~~~~~~~~~~~~~~~~~~~~~~~~~~~~~~~~~~~~~~~~~~ current Temp ~~~~~~~~~~~~~~~~~~~~~~~~~~~~~~~~~~~~~~~~~
      case 0:
        currentTemperature = ((analogRead(temperaturePin)) - 2.5); // the -3.5 C is a correction (test showed 75 F, room temp is 71)
        lcd.clear();
        lcd.setCursor(0, 0);
        lcd.print("Current Temp.");
        lcd.setCursor(0, 1);
        lcd.print(currentTemperature);
        lcd.print(" C");
        delay(150);
        break;

      //~~~~~~~~~~~~~~~~~~~~~~~~~~~~~~~~~~~~~~~~~~~ go back ~~~~~~~~~~~~~~~~~~~~~~~~~~~~~~~~~~~~~~~~~
      case 1: // go back

        keyReset(); // This function resets the keys to be NO_KEY

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

        int previousSelect = keypad.getKey();

        if (previousSelect == 42) {
          currentMenu = 1;
        }

        else {
          currentMenu = currentMenu;
        }

        break; // break for case 1, ends 'go back' menu

    }

  } // closing curly brace for (currentMenu >= 30 && currentMenu < 40) (settings)

} // main loop closing curly brace

//***************************************************************************************************
//***************************************************************************************************
//********************************************* Functions *******************************************
//***************************************************************************************************
//***************************************************************************************************

//~~~~~~~~~~~~~~~~~~~~~~~~~~~~~~~~~~~~~~~~~~~~~~ arrayCheck ~~~~~~~~~~~~~~~~~~~~~~~~~~~~~~~~~~~~~~~~~
// Compares two arrays against each other, used for user ID and password input

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

  for (int i = 0; i < 4; i++) {

    if (array1[i] == array2[i]) {
      checkArrays[i] = true;
    }

    else {
      checkArrays[i] = false;
    }

  }

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

  if (counter == 4) {
    finalCheck = true;
  }

  else {
    finalCheck = false;
  }

  return finalCheck; // returns the final check variable as either true or false

}
//~~~~~~~~~~~~~~~~~~~~~~~~~~~~~~~~~~~~~~~~~~~~~~~~~~~~~~~~~~~~~~~~~~~~~~~~~~~~~~~~~~~~~~~~~~~~~~~~~~~

//~~~~~~~~~~~~~~~~~~~~~~~~~~~~~~~~~~~~~~~~~~~~~~ arrayInput ~~~~~~~~~~~~~~~~~~~~~~~~~~~~~~~~~~~~~~~~~
// Inputs values into the arary, can be recycled for both username and password.  This function takes
// an array to be modified as an input value, and does not return a value.

void arrayInput(char inputArray[], bool password) {

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

    iDFlag[0] = true; // set the first value of iDFlag to be true
  }

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

    iDFlag[1] = true; // set the second value of the iDFlag array equal to true
  }

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

    iDFlag[2] = true; // set the third value of the iDFlag array equal to true
  }

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

    else {
      lcdDisplay(passwordMask, 3); // display three digits of the passwordMask array
    }
  }

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

    else {
      lcdDisplay(passwordMask, 4); // display four values on the passwordMask arrray
    }

    iDFlag[3] = true; // set the final value of the iDFlag array to be true
  }

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

} // closing curly brace for the function
//~~~~~~~~~~~~~~~~~~~~~~~~~~~~~~~~~~~~~~~~~~~~~~~~~~~~~~~~~~~~~~~~~~~~~~~~~~~~~~~~~~~~~~~~~~~~~~~~~~~

//~~~~~~~~~~~~~~~~~~~~~~~~~~~~~~~~~~~~~~~~~~~~~ arrayReset ~~~~~~~~~~~~~~~~~~~~~~~~~~~~~~~~~~~~~~~~~~
// resets all values in a username or password array back to _
void arrayReset(char inputArray[]) {
  for (int i = 0; i < 4; i++) {
    inputArray[i] = '_';
  }
}

//~~~~~~~~~~~~~~~~~~~~~~~~~~~~~~~~~~~~~~~~~~~~~~~~~~~~~~~~~~~~~~~~~~~~~~~~~~~~~~~~~~~~~~~~~~~~~~~~~~~

//~~~~~~~~~~~~~~~~~~~~~~~~~~~~~~~~~~~~~~~~~~~~~~ flagReset ~~~~~~~~~~~~~~~~~~~~~~~~~~~~~~~~~~~~~~~~~~
// This function does not return any value.
// This function resets the ID flags used to determine which place in an array you are to enter a
// value
void flagReset() {

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

}
//~~~~~~~~~~~~~~~~~~~~~~~~~~~~~~~~~~~~~~~~~~~~~~~~~~~~~~~~~~~~~~~~~~~~~~~~~~~~~~~~~~~~~~~~~~~~~~~~~~~

//~~~~~~~~~~~~~~~~~~~~~~~~~~~~~~~~~~~~~~~~~~~~~ idFlagCount ~~~~~~~~~~~~~~~~~~~~~~~~~~~~~~~~~~~~~~~~~
// Counts the number of true variables in the iDFlag array.  For every true, we add a 1, for every
// false, we add a 0.  We then reutrn the total value of the count.
int idFlagCount() {

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

  return counter; // returns the value of the local variable

}
//~~~~~~~~~~~~~~~~~~~~~~~~~~~~~~~~~~~~~~~~~~~~~~~~~~~~~~~~~~~~~~~~~~~~~~~~~~~~~~~~~~~~~~~~~~~~~~~~~~~

//~~~~~~~~~~~~~~~~~~~~~~~~~~~~~~~~~~~~~~~~~~~~~~~ keyInput ~~~~~~~~~~~~~~~~~~~~~~~~~~~~~~~~~~~~~~~~~~
// This function allows the program to accept an input from the keypad for all four entries
void keyInput(bool isPassword) { // enter a 0 for not a password, and 1 for password.

  bool successCheck; // local variable used to move on to next menu if necessary

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

  else if (isPassword == true && unlockFlag == true) { // if we are working with the password array & unlock
    successCheck = arrayCheck(passwordInput, userIDCheck); // compares userID against the predefined "password"
    if (successCheck == true) {
      lcd.clear();
      lcd.setCursor(0, 0); // sets cursor at column 0, row 0
      lcd.print("Success!");
      unlock();
      unlockFlag = false;
    }
    else {
      arrayReset(passwordInput);
    }
  }

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

}

//~~~~~~~~~~~~~~~~~~~~~~~~~~~~~~~~~~~~~~~~~~~~~~~~~~~~~~~~~~~~~~~~~~~~~~~~~~~~~~~~~~~~~~~~~~~~~~~~~~~

//~~~~~~~~~~~~~~~~~~~~~~~~~~~~~~~~~~~~~~~~~~~~~~~ keyReset ~~~~~~~~~~~~~~~~~~~~~~~~~~~~~~~~~~~~~~~~~~
// This void type function will reset the keypad inputs, key0-4 back to NO_KEY
void keyReset() {
  key0 = NO_KEY;
  key1 = NO_KEY;
  key2 = NO_KEY;
  key3 = NO_KEY;
}
//~~~~~~~~~~~~~~~~~~~~~~~~~~~~~~~~~~~~~~~~~~~~~~~~~~~~~~~~~~~~~~~~~~~~~~~~~~~~~~~~~~~~~~~~~~~~~~~~~~~

//~~~~~~~~~~~~~~~~~~~~~~~~~~~~~~~~~~~~~~~~~~~~~ lcdDisplay ~~~~~~~~~~~~~~~~~~~~~~~~~~~~~~~~~~~~~~~~~~
// This function, when called will display any number of digits on the LCD display
void lcdDisplay(char Array[], int digits) {
  switch (digits) {
    case 1:
      lcd.print(Array[0]);
      break;

    case 2:
      lcd.print(Array[0]);
      lcd.print(Array[1]);
      break;

    case 3:
      lcd.print(Array[0]);
      lcd.print(Array[1]);
      lcd.print(Array[2]);
      break;

    case 4:
      lcd.print(Array[0]);
      lcd.print(Array[1]);
      lcd.print(Array[2]);
      lcd.print(Array[3]);
      break;
  }
}
//~~~~~~~~~~~~~~~~~~~~~~~~~~~~~~~~~~~~~~~~~~~~~~~~~~~~~~~~~~~~~~~~~~~~~~~~~~~~~~~~~~~~~~~~~~~~~~~~~~~

//~~~~~~~~~~~~~~~~~~~~~~~~~~~~~~~~~~~~~~~~~~~~~ menuSelect ~~~~~~~~~~~~~~~~~~~~~~~~~~~~~~~~~~~~~~~~~~
// This function will allow the user to select a menu based on the joystick position, and return a
// variable which will be used to display the correct menu.  The returned variable is called
// menuCount.  This function allows you to control the total number of menus.

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

  else {
    menuCount = menuCount;  // if the joystick didn't move then keep the menu the same
  }

  return menuCount;  // return which menu you are working in.
}
//~~~~~~~~~~~~~~~~~~~~~~~~~~~~~~~~~~~~~~~~~~~~~~~~~~~~~~~~~~~~~~~~~~~~~~~~~~~~~~~~~~~~~~~~~~~~~~~~~~~

//~~~~~~~~~~~~~~~~~~~~~~~~~~~~~~~~~~~~~~~~~~ pound2Underscore ~~~~~~~~~~~~~~~~~~~~~~~~~~~~~~~~~~~~~~~
// This function will convert the ASCII input # to _
void pound2Underscore(char keypadArray[], int x) {
  if (keypadArray[x] == 35) { // if the entered value is #
    keypadArray[x] = 95; // change the entered value to _
  }
  else {
    keypadArray[x] = keypadArray[x]; // otherwise keep whatever the original value was
  }
}
//~~~~~~~~~~~~~~~~~~~~~~~~~~~~~~~~~~~~~~~~~~~~~~~~~~~~~~~~~~~~~~~~~~~~~~~~~~~~~~~~~~~~~~~~~~~~~~~~~~~

//~~~~~~~~~~~~~~~~~~~~~~~~~~~~~~~~~~~~~~~~~~~~~~~ unlock ~~~~~~~~~~~~~~~~~~~~~~~~~~~~~~~~~~~~~~~~~~~~
// This function will unlock the lock one time and will not work again until the unlock variable is
// reset
void unlock() {

  if (lockActivated == false) {
    digitalWrite(lockRelayPin, HIGH);
    delay(1000);
    digitalWrite(lockRelayPin, LOW);
  }

  else {
    digitalWrite(lockRelayPin, LOW);
  }

}

//~~~~~~~~~~~~~~~~~~~~~~~~~~~~~~~~~~~~~~~~~~~~~~~~~~~~~~~~~~~~~~~~~~~~~~~~~~~~~~~~~~~~~~~~~~~~~~~~~~~

//***************************************************************************************************
//*********************************************** Notes *********************************************
//***************************************************************************************************

//~~~~~~~~~~~~~~~~~~~~~~~~~~~~~~~~~~~~~~~~~ ASCII Cheat Sheet ~~~~~~~~~~~~~~~~~~~~~~~~~~~~~~~~~~~~~~~
// # => 35
// * => 42
// 0 => 48
// 1 => 49
// 2 => 50
// 3 => 51
// 4 => 52
// 5 => 53
// 6 => 54
// 7 => 55
// 8 => 56
// 9 => 57
// _ => 95

//~~~~~~~~~~~~~~~~~~~~~~~~~~~~~~~~~~~~~~~~~~~~~~~~~ Links ~~~~~~~~~~~~~~~~~~~~~~~~~~~~~~~~~~~~~~~~~~~
// Micro SD Card Tutorial: https://www.instructables.com/id/Micro-SD-Card-Tutorial/
// Writing functions: https://www.arduino.cc/en/Reference/FunctionDeclaration
// ASCII chart: https://theasciicode.com.ar/ascii-control-characters/null-character-ascii-code-0.html
// Adafruit keypadCharacterpad Demo: https://www.adafruit.com/product/3845
