MH-Bio/vaccine_dispenser/TFT Stuff/SC3A (3.5 in screen)/3.5inch_Arduino_ILI9486_V1.0/STM32 Demo_STM32F103RCT6/STM32 integrated test program ILI9481_IO simulation/OBJ/TOUCH.htm

# Static Call Graph for image ..\OBJ\TOUCH.axf

#<CALLGRAPH># ARM Linker, 5040049: Last Updated: Fri Dec 11 10:54:31 2015

### Maximum Stack Usage = 288 bytes + Unknown(Functions without stacksize, Cycles, Untraceable Function Pointers)

### Call chain for Maximum Stack Depth:

TP_Init ⇒ TP_Adjust ⇒ TP_Adj_Info_Show ⇒ LCD_ShowNum ⇒ LCD_ShowChar ⇒ LCD_DrawPoint ⇒ LCD_SetCursor ⇒ LCD_WriteRAM_Prepare

### Functions with no stack information

- __user_initial_stackheap

### Mutually Recursive functions

- NMI_Handler ⇒ NMI_Handler
- HardFault_Handler ⇒ HardFault_Handler
- MemManage_Handler ⇒ MemManage_Handler
- BusFault_Handler ⇒ BusFault_Handler
- UsageFault_Handler ⇒ UsageFault_Handler
- SVC_Handler ⇒ SVC_Handler
- DebugMon_Handler ⇒ DebugMon_Handler
- PendSV_Handler ⇒ PendSV_Handler
- SysTick_Handler ⇒ SysTick_Handler
- ADC1_2_IRQHandler ⇒ ADC1_2_IRQHandler

### Function Pointers

- ADC1_2_IRQHandler from startup_stm32f10x_md.o(.text) referenced from startup_stm32f10x_md.o(RESET)
- BusFault_Handler from startup_stm32f10x_md.o(.text) referenced from startup_stm32f10x_md.o(RESET)
- CAN1_RX1_IRQHandler from startup_stm32f10x_md.o(.text) referenced from startup_stm32f10x_md.o(RESET)
- CAN1_SCE_IRQHandler from startup_stm32f10x_md.o(.text) referenced from startup_stm32f10x_md.o(RESET)
- DMA1_Channel1_IRQHandler from startup_stm32f10x_md.o(.text) referenced from startup_stm32f10x_md.o(RESET)
- DMA1_Channel2_IRQHandler from startup_stm32f10x_md.o(.text) referenced from startup_stm32f10x_md.o(RESET)
- DMA1_Channel3_IRQHandler from startup_stm32f10x_md.o(.text) referenced from startup_stm32f10x_md.o(RESET)
- DMA1_Channel4_IRQHandler from startup_stm32f10x_md.o(.text) referenced from startup_stm32f10x_md.o(RESET)
- DMA1_Channel5_IRQHandler from startup_stm32f10x_md.o(.text) referenced from startup_stm32f10x_md.o(RESET)
- DMA1_Channel6_IRQHandler from startup_stm32f10x_md.o(.text) referenced from startup_stm32f10x_md.o(RESET)
- DMA1_Channel7_IRQHandler from startup_stm32f10x_md.o(.text) referenced from startup_stm32f10x_md.o(RESET)
- DebugMon_Handler from startup_stm32f10x_md.o(.text) referenced from startup_stm32f10x_md.o(RESET)
- EXTI0_IRQHandler from startup_stm32f10x_md.o(.text) referenced from startup_stm32f10x_md.o(RESET)
- EXTI15_10_IRQHandler from startup_stm32f10x_md.o(.text) referenced from startup_stm32f10x_md.o(RESET)
- EXTI1_IRQHandler from startup_stm32f10x_md.o(.text) referenced from startup_stm32f10x_md.o(RESET)
- EXTI2_IRQHandler from startup_stm32f10x_md.o(.text) referenced from startup_stm32f10x_md.o(RESET)
- EXTI3_IRQHandler from startup_stm32f10x_md.o(.text) referenced from startup_stm32f10x_md.o(RESET)
- EXTI4_IRQHandler from startup_stm32f10x_md.o(.text) referenced from startup_stm32f10x_md.o(RESET)
- EXTI9_5_IRQHandler from startup_stm32f10x_md.o(.text) referenced from startup_stm32f10x_md.o(RESET)
- FLASH_IRQHandler from startup_stm32f10x_md.o(.text) referenced from startup_stm32f10x_md.o(RESET)
- HardFault_Handler from startup_stm32f10x_md.o(.text) referenced from startup_stm32f10x_md.o(RESET)
- I2C1_ER_IRQHandler from startup_stm32f10x_md.o(.text) referenced from startup_stm32f10x_md.o(RESET)
- I2C1_EV_IRQHandler from startup_stm32f10x_md.o(.text) referenced from startup_stm32f10x_md.o(RESET)
- I2C2_ER_IRQHandler from startup_stm32f10x_md.o(.text) referenced from startup_stm32f10x_md.o(RESET)
- I2C2_EV_IRQHandler from startup_stm32f10x_md.o(.text) referenced from startup_stm32f10x_md.o(RESET)
- MemManage_Handler from startup_stm32f10x_md.o(.text) referenced from startup_stm32f10x_md.o(RESET)
- NMI_Handler from startup_stm32f10x_md.o(.text) referenced from startup_stm32f10x_md.o(RESET)
- PVD_IRQHandler from startup_stm32f10x_md.o(.text) referenced from startup_stm32f10x_md.o(RESET)
- PendSV_Handler from startup_stm32f10x_md.o(.text) referenced from startup_stm32f10x_md.o(RESET)
- RCC_IRQHandler from startup_stm32f10x_md.o(.text) referenced from startup_stm32f10x_md.o(RESET)
- RTCAlarm_IRQHandler from startup_stm32f10x_md.o(.text) referenced from startup_stm32f10x_md.o(RESET)
- RTC_IRQHandler from startup_stm32f10x_md.o(.text) referenced from startup_stm32f10x_md.o(RESET)
- Reset_Handler from startup_stm32f10x_md.o(.text) referenced from startup_stm32f10x_md.o(RESET)
- SPI1_IRQHandler from startup_stm32f10x_md.o(.text) referenced from startup_stm32f10x_md.o(RESET)
- SPI2_IRQHandler from startup_stm32f10x_md.o(.text) referenced from startup_stm32f10x_md.o(RESET)
- SVC_Handler from startup_stm32f10x_md.o(.text) referenced from startup_stm32f10x_md.o(RESET)
- SysTick_Handler from startup_stm32f10x_md.o(.text) referenced from startup_stm32f10x_md.o(RESET)
- SystemInit from system_stm32f10x.o(.text) referenced from startup_stm32f10x_md.o(.text)
- TAMPER_IRQHandler from startup_stm32f10x_md.o(.text) referenced from startup_stm32f10x_md.o(RESET)
- TIM1_BRK_IRQHandler from startup_stm32f10x_md.o(.text) referenced from startup_stm32f10x_md.o(RESET)
- TIM1_CC_IRQHandler from startup_stm32f10x_md.o(.text) referenced from startup_stm32f10x_md.o(RESET)
- TIM1_TRG_COM_IRQHandler from startup_stm32f10x_md.o(.text) referenced from startup_stm32f10x_md.o(RESET)
- TIM1_UP_IRQHandler from startup_stm32f10x_md.o(.text) referenced from startup_stm32f10x_md.o(RESET)
- TIM2_IRQHandler from startup_stm32f10x_md.o(.text) referenced from startup_stm32f10x_md.o(RESET)
- TIM3_IRQHandler from startup_stm32f10x_md.o(.text) referenced from startup_stm32f10x_md.o(RESET)
- TIM4_IRQHandler from startup_stm32f10x_md.o(.text) referenced from startup_stm32f10x_md.o(RESET)
- TP_Adjust from touch.o(.text) referenced from touch.o(.data)
- TP_Init from touch.o(.text) referenced from touch.o(.data)
- TP_Scan from touch.o(.text) referenced from touch.o(.data)
- USART1_IRQHandler from startup_stm32f10x_md.o(.text) referenced from startup_stm32f10x_md.o(RESET)
- USART2_IRQHandler from startup_stm32f10x_md.o(.text) referenced from startup_stm32f10x_md.o(RESET)
- USART3_IRQHandler from startup_stm32f10x_md.o(.text) referenced from startup_stm32f10x_md.o(RESET)
- USBWakeUp_IRQHandler from startup_stm32f10x_md.o(.text) referenced from startup_stm32f10x_md.o(RESET)
- USB_HP_CAN1_TX_IRQHandler from startup_stm32f10x_md.o(.text) referenced from startup_stm32f10x_md.o(RESET)
- USB_LP_CAN1_RX0_IRQHandler from startup_stm32f10x_md.o(.text) referenced from startup_stm32f10x_md.o(RESET)
- UsageFault_Handler from startup_stm32f10x_md.o(.text) referenced from startup_stm32f10x_md.o(RESET)
- WWDG_IRQHandler from startup_stm32f10x_md.o(.text) referenced from startup_stm32f10x_md.o(RESET)
- __main from __main.o(!!!main) referenced from startup_stm32f10x_md.o(.text)

### Global Symbols

__main (Thumb, 8 bytes, Stack size 0 bytes, __main.o(!!!main))

[Calls]

- >> __scatterload
- >> __rt_entry

__scatterload (Thumb, 0 bytes, Stack size unknown bytes, __scatter.o(!!!scatter))

[Called By]

- >> __main

__scatterload_rt2 (Thumb, 44 bytes, Stack size unknown bytes, __scatter.o(!!!scatter), UNUSED)

[Calls]

- >> __rt_entry

__scatterload_rt2_thumb_only (Thumb, 0 bytes, Stack size unknown bytes, __scatter.o(!!!scatter), UNUSED)

__scatterload_null (Thumb, 0 bytes, Stack size unknown bytes, __scatter.o(!!!scatter), UNUSED)

__scatterload_copy (Thumb, 26 bytes, Stack size unknown bytes, __scatter_copy.o(!!handler_copy), UNUSED)

[Calls]

- >> __scatterload_copy

[Called By]

- >> __scatterload_copy

__scatterload_zeroinit (Thumb, 28 bytes, Stack size unknown bytes, __scatter_zi.o(!!handler_zi), UNUSED)

__rt_lib_init (Thumb, 0 bytes, Stack size unknown bytes, libinit.o(.ARM.Collect$$libinit$$00000000))

[Called By]

- >> __rt_entry_li

__rt_lib_init_alloca_1 (Thumb, 0 bytes, Stack size unknown bytes, libinit2.o(.ARM.Collect$$libinit$$0000002C))

__rt_lib_init_argv_1 (Thumb, 0 bytes, Stack size unknown bytes, libinit2.o(.ARM.Collect$$libinit$$0000002A))

__rt_lib_init_atexit_1 (Thumb, 0 bytes, Stack size unknown bytes, libinit2.o(.ARM.Collect$$libinit$$00000019))

__rt_lib_init_clock_1 (Thumb, 0 bytes, Stack size unknown bytes, libinit2.o(.ARM.Collect$$libinit$$0000001F))

__rt_lib_init_cpp_1 (Thumb, 0 bytes, Stack size unknown bytes, libinit2.o(.ARM.Collect$$libinit$$00000030))

__rt_lib_init_exceptions_1 (Thumb, 0 bytes, Stack size unknown bytes, libinit2.o(.ARM.Collect$$libinit$$0000002E))

__rt_lib_init_fp_1 (Thumb, 0 bytes, Stack size unknown bytes, libinit2.o(.ARM.Collect$$libinit$$00000002))

__rt_lib_init_fp_trap_1 (Thumb, 0 bytes, Stack size unknown bytes, libinit2.o(.ARM.Collect$$libinit$$0000001D))

__rt_lib_init_getenv_1 (Thumb, 0 bytes, Stack size unknown bytes, libinit2.o(.ARM.Collect$$libinit$$00000021))

__rt_lib_init_heap_1 (Thumb, 0 bytes, Stack size unknown bytes, libinit2.o(.ARM.Collect$$libinit$$00000008))

__rt_lib_init_lc_collate_1 (Thumb, 0 bytes, Stack size unknown bytes, libinit2.o(.ARM.Collect$$libinit$$0000000F))

__rt_lib_init_lc_ctype_1 (Thumb, 0 bytes, Stack size unknown bytes, libinit2.o(.ARM.Collect$$libinit$$00000011))

__rt_lib_init_lc_monetary_1 (Thumb, 0 bytes, Stack size unknown bytes, libinit2.o(.ARM.Collect$$libinit$$00000013))

__rt_lib_init_lc_numeric_1 (Thumb, 0 bytes, Stack size unknown bytes, libinit2.o(.ARM.Collect$$libinit$$00000015))

__rt_lib_init_lc_time_1 (Thumb, 0 bytes, Stack size unknown bytes, libinit2.o(.ARM.Collect$$libinit$$00000017))

__rt_lib_init_rand_1 (Thumb, 0 bytes, Stack size unknown bytes, libinit2.o(.ARM.Collect$$libinit$$0000000C))

__rt_lib_init_return (Thumb, 0 bytes, Stack size unknown bytes, libinit2.o(.ARM.Collect$$libinit$$00000031))

__rt_lib_init_signal_1 (Thumb, 0 bytes, Stack size unknown bytes, libinit2.o(.ARM.Collect$$libinit$$0000001B))

__rt_lib_init_stdio_1 (Thumb, 0 bytes, Stack size unknown bytes, libinit2.o(.ARM.Collect$$libinit$$00000023))

__rt_lib_init_user_alloc_1 (Thumb, 0 bytes, Stack size unknown bytes, libinit2.o(.ARM.Collect$$libinit$$0000000A))

__rt_lib_shutdown (Thumb, 0 bytes, Stack size unknown bytes, libshutdown.o(.ARM.Collect$$libshutdown$$00000000))

[Called By]

- >> __rt_exit_ls

__rt_lib_shutdown_fp_trap_1 (Thumb, 0 bytes, Stack size unknown bytes, libshutdown2.o(.ARM.Collect$$libshutdown$$00000006))

__rt_lib_shutdown_heap_1 (Thumb, 0 bytes, Stack size unknown bytes, libshutdown2.o(.ARM.Collect$$libshutdown$$0000000E))

__rt_lib_shutdown_return (Thumb, 0 bytes, Stack size unknown bytes, libshutdown2.o(.ARM.Collect$$libshutdown$$0000000F))

__rt_lib_shutdown_signal_1 (Thumb, 0 bytes, Stack size unknown bytes, libshutdown2.o(.ARM.Collect$$libshutdown$$00000009))

__rt_lib_shutdown_stdio_1 (Thumb, 0 bytes, Stack size unknown bytes, libshutdown2.o(.ARM.Collect$$libshutdown$$00000003))

__rt_lib_shutdown_user_alloc_1 (Thumb, 0 bytes, Stack size unknown bytes, libshutdown2.o(.ARM.Collect$$libshutdown$$0000000B))

__rt_entry (Thumb, 0 bytes, Stack size unknown bytes, rtentry.o(.ARM.Collect$$rtentry$$00000000))

[Called By]

- >> __main
- >> __scatterload_rt2

__rt_entry_presh_1 (Thumb, 0 bytes, Stack size unknown bytes, rtentry2.o(.ARM.Collect$$rtentry$$00000002))

__rt_entry_sh (Thumb, 0 bytes, Stack size unknown bytes, rtentry4.o(.ARM.Collect$$rtentry$$00000004))

[Stack]

- Max Depth = 8 + Unknown Stack Size
- Call Chain = __rt_entry_sh ⇒ __user_setup_stackheap

[Calls]

- >> __user_setup_stackheap

__rt_entry_li (Thumb, 0 bytes, Stack size unknown bytes, rtentry2.o(.ARM.Collect$$rtentry$$0000000A))

[Calls]

- >> __rt_lib_init

__rt_entry_postsh_1 (Thumb, 0 bytes, Stack size unknown bytes, rtentry2.o(.ARM.Collect$$rtentry$$00000009))

__rt_entry_main (Thumb, 0 bytes, Stack size unknown bytes, rtentry2.o(.ARM.Collect$$rtentry$$0000000D))

[Stack]

- Max Depth = 272 + Unknown Stack Size
- Call Chain = __rt_entry_main ⇒ main ⇒ Test_FillRec ⇒ DrawTestPage ⇒ Gui_StrCenter ⇒ Show_Str ⇒ LCD_ShowChar ⇒ LCD_DrawPoint ⇒ LCD_SetCursor ⇒ LCD_WriteRAM_Prepare

[Calls]

- >> main
- >> exit

__rt_entry_postli_1 (Thumb, 0 bytes, Stack size unknown bytes, rtentry2.o(.ARM.Collect$$rtentry$$0000000C))

__rt_exit (Thumb, 0 bytes, Stack size unknown bytes, rtexit.o(.ARM.Collect$$rtexit$$00000000))

[Called By]

- >> exit

__rt_exit_ls (Thumb, 0 bytes, Stack size unknown bytes, rtexit2.o(.ARM.Collect$$rtexit$$00000003))

[Calls]

- >> __rt_lib_shutdown

__rt_exit_prels_1 (Thumb, 0 bytes, Stack size unknown bytes, rtexit2.o(.ARM.Collect$$rtexit$$00000002))

__rt_exit_exit (Thumb, 0 bytes, Stack size unknown bytes, rtexit2.o(.ARM.Collect$$rtexit$$00000004))

[Calls]

- >> _sys_exit

main (Thumb, 50 bytes, Stack size 0 bytes, main.o(.text))

[Stack]

- Max Depth = 272
- Call Chain = main ⇒ Test_FillRec ⇒ DrawTestPage ⇒ Gui_StrCenter ⇒ Show_Str ⇒ LCD_ShowChar ⇒ LCD_DrawPoint ⇒ LCD_SetCursor ⇒ LCD_WriteRAM_Prepare

[Calls]

- >> main_test
- >> delay_init
- >> Test_FillRec
- >> Test_Color
- >> Test_Circle
- >> SystemInit
- >> Pic_test
- >> LCD_Init
- >> English_Font_test
- >> Chinese_Font_test

[Called By]

- >> __rt_entry_main

DrawTestPage (Thumb, 134 bytes, Stack size 24 bytes, test.o(.text))

[Stack]

- Max Depth = 240
- Call Chain = DrawTestPage ⇒ Gui_StrCenter ⇒ Show_Str ⇒ LCD_ShowChar ⇒ LCD_DrawPoint ⇒ LCD_SetCursor ⇒ LCD_WriteRAM_Prepare

[Calls]

- >> LCD_Fill
- >> Gui_StrCenter

[Called By]

- >> Touch_Test
- >> main_test
- >> Test_FillRec
- >> Test_Color
- >> Test_Circle
- >> Pic_test
- >> English_Font_test
- >> Chinese_Font_test

main_test (Thumb, 124 bytes, Stack size 16 bytes, test.o(.text))

[Stack]

- Max Depth = 256
- Call Chain = main_test ⇒ DrawTestPage ⇒ Gui_StrCenter ⇒ Show_Str ⇒ LCD_ShowChar ⇒ LCD_DrawPoint ⇒ LCD_SetCursor ⇒ LCD_WriteRAM_Prepare

[Calls]

- >> delay_ms
- >> Gui_StrCenter
- >> DrawTestPage

[Called By]

- >> main

Test_Color (Thumb, 338 bytes, Stack size 16 bytes, test.o(.text))

[Stack]

- Max Depth = 256
- Call Chain = Test_Color ⇒ DrawTestPage ⇒ Gui_StrCenter ⇒ Show_Str ⇒ LCD_ShowChar ⇒ LCD_DrawPoint ⇒ LCD_SetCursor ⇒ LCD_WriteRAM_Prepare

[Calls]

- >> delay_ms
- >> Show_Str
- >> LCD_Fill
- >> DrawTestPage

[Called By]

- >> main

Test_FillRec (Thumb, 392 bytes, Stack size 32 bytes, test.o(.text))

[Stack]

- Max Depth = 272
- Call Chain = Test_FillRec ⇒ DrawTestPage ⇒ Gui_StrCenter ⇒ Show_Str ⇒ LCD_ShowChar ⇒ LCD_DrawPoint ⇒ LCD_SetCursor ⇒ LCD_WriteRAM_Prepare

[Calls]

- >> delay_ms
- >> LCD_Fill
- >> LCD_DrawRectangle
- >> LCD_DrawFillRectangle
- >> DrawTestPage

[Called By]

- >> main

Test_Circle (Thumb, 444 bytes, Stack size 24 bytes, test.o(.text))

[Stack]

- Max Depth = 264
- Call Chain = Test_Circle ⇒ DrawTestPage ⇒ Gui_StrCenter ⇒ Show_Str ⇒ LCD_ShowChar ⇒ LCD_DrawPoint ⇒ LCD_SetCursor ⇒ LCD_WriteRAM_Prepare

[Calls]

- >> gui_circle
- >> delay_ms
- >> LCD_Fill
- >> DrawTestPage

[Called By]

- >> main

English_Font_test (Thumb, 128 bytes, Stack size 8 bytes, test.o(.text))

[Stack]

- Max Depth = 248
- Call Chain = English_Font_test ⇒ DrawTestPage ⇒ Gui_StrCenter ⇒ Show_Str ⇒ LCD_ShowChar ⇒ LCD_DrawPoint ⇒ LCD_SetCursor ⇒ LCD_WriteRAM_Prepare

[Calls]

- >> delay_ms
- >> LCD_ShowString
- >> DrawTestPage

[Called By]

- >> main

Chinese_Font_test (Thumb, 122 bytes, Stack size 16 bytes, test.o(.text))

[Stack]

- Max Depth = 256
- Call Chain = Chinese_Font_test ⇒ DrawTestPage ⇒ Gui_StrCenter ⇒ Show_Str ⇒ LCD_ShowChar ⇒ LCD_DrawPoint ⇒ LCD_SetCursor ⇒ LCD_WriteRAM_Prepare

[Calls]

- >> delay_ms
- >> Show_Str
- >> DrawTestPage

[Called By]

- >> main

Pic_test (Thumb, 152 bytes, Stack size 16 bytes, test.o(.text))

[Stack]

- Max Depth = 256
- Call Chain = Pic_test ⇒ DrawTestPage ⇒ Gui_StrCenter ⇒ Show_Str ⇒ LCD_ShowChar ⇒ LCD_DrawPoint ⇒ LCD_SetCursor ⇒ LCD_WriteRAM_Prepare

[Calls]

- >> delay_ms
- >> Show_Str
- >> LCD_Fill
- >> Gui_Drawbmp16
- >> DrawTestPage

[Called By]

- >> main

Touch_Test (Thumb, 892 bytes, Stack size 32 bytes, test.o(.text), UNUSED)

[Calls]

- >> delay_ms
- >> TP_Save_Adjdata
- >> TP_Init
- >> TP_Draw_Big_Point
- >> TP_Adjust
- >> LCD_ShowString
- >> LCD_Fill
- >> LCD_Clear
- >> KEY_Scan
- >> KEY_Init
- >> DrawTestPage

GUI_DrawPoint (Thumb, 24 bytes, Stack size 16 bytes, gui.o(.text))

[Stack]

- Max Depth = 28
- Call Chain = GUI_DrawPoint ⇒ LCD_SetCursor ⇒ LCD_WriteRAM_Prepare

[Calls]

- >> LCD_SetCursor
- >> LCD_DrawPoint_16Bit

[Called By]

- >> _draw_circle_8

LCD_Fill (Thumb, 164 bytes, Stack size 40 bytes, gui.o(.text))

[Stack]

- Max Depth = 60
- Call Chain = LCD_Fill ⇒ LCD_SetWindows ⇒ LCD_WriteRAM_Prepare

[Calls]

- >> LCD_SetWindows

[Called By]

- >> LCD_DrawFillRectangle
- >> Touch_Test
- >> DrawTestPage
- >> Test_FillRec
- >> Test_Color
- >> Test_Circle
- >> Pic_test

LCD_DrawLine (Thumb, 176 bytes, Stack size 72 bytes, gui.o(.text))

[Stack]

- Max Depth = 96
- Call Chain = LCD_DrawLine ⇒ LCD_DrawPoint ⇒ LCD_SetCursor ⇒ LCD_WriteRAM_Prepare

[Calls]

- >> LCD_DrawPoint

[Called By]

- >> TP_Drow_Touch_Point
- >> LCD_DrawRectangle

LCD_DrawRectangle (Thumb, 64 bytes, Stack size 24 bytes, gui.o(.text))

[Stack]

- Max Depth = 120
- Call Chain = LCD_DrawRectangle ⇒ LCD_DrawLine ⇒ LCD_DrawPoint ⇒ LCD_SetCursor ⇒ LCD_WriteRAM_Prepare

[Calls]

- >> LCD_DrawLine

[Called By]

- >> Test_FillRec

LCD_DrawFillRectangle (Thumb, 30 bytes, Stack size 24 bytes, gui.o(.text))

[Stack]

- Max Depth = 84
- Call Chain = LCD_DrawFillRectangle ⇒ LCD_Fill ⇒ LCD_SetWindows ⇒ LCD_WriteRAM_Prepare

[Calls]

- >> LCD_Fill

[Called By]

- >> Test_FillRec

_draw_circle_8 (Thumb, 132 bytes, Stack size 24 bytes, gui.o(.text))

[Stack]

- Max Depth = 52
- Call Chain = _draw_circle_8 ⇒ GUI_DrawPoint ⇒ LCD_SetCursor ⇒ LCD_WriteRAM_Prepare

[Calls]

- >> GUI_DrawPoint

[Called By]

- >> gui_circle

gui_circle (Thumb, 154 bytes, Stack size 56 bytes, gui.o(.text))

[Stack]

- Max Depth = 108
- Call Chain = gui_circle ⇒ _draw_circle_8 ⇒ GUI_DrawPoint ⇒ LCD_SetCursor ⇒ LCD_WriteRAM_Prepare

[Calls]

- >> _draw_circle_8

[Called By]

- >> TP_Drow_Touch_Point
- >> Test_Circle

LCD_ShowChar (Thumb, 276 bytes, Stack size 64 bytes, gui.o(.text))

[Stack]

- Max Depth = 88
- Call Chain = LCD_ShowChar ⇒ LCD_DrawPoint ⇒ LCD_SetCursor ⇒ LCD_WriteRAM_Prepare

[Calls]

- >> LCD_SetWindows
- >> LCD_DrawPoint_16Bit
- >> LCD_DrawPoint

[Called By]

- >> LCD_ShowNum
- >> Show_Str
- >> LCD_ShowString

LCD_ShowString (Thumb, 124 bytes, Stack size 40 bytes, gui.o(.text))

[Stack]

- Max Depth = 128
- Call Chain = LCD_ShowString ⇒ LCD_ShowChar ⇒ LCD_DrawPoint ⇒ LCD_SetCursor ⇒ LCD_WriteRAM_Prepare

[Calls]

- >> LCD_ShowChar

[Called By]

- >> TP_Adj_Info_Show
- >> TP_Adjust
- >> Touch_Test
- >> English_Font_test

mypow (Thumb, 22 bytes, Stack size 8 bytes, gui.o(.text))

[Stack]

- Max Depth = 8
- Call Chain = mypow

[Called By]

- >> LCD_ShowNum

LCD_ShowNum (Thumb, 168 bytes, Stack size 64 bytes, gui.o(.text))

[Stack]

- Max Depth = 152
- Call Chain = LCD_ShowNum ⇒ LCD_ShowChar ⇒ LCD_DrawPoint ⇒ LCD_SetCursor ⇒ LCD_WriteRAM_Prepare

[Calls]

- >> mypow
- >> LCD_ShowChar

[Called By]

- >> TP_Adj_Info_Show

GUI_DrawFont16 (Thumb, 252 bytes, Stack size 48 bytes, gui.o(.text))

[Stack]

- Max Depth = 72
- Call Chain = GUI_DrawFont16 ⇒ LCD_DrawPoint ⇒ LCD_SetCursor ⇒ LCD_WriteRAM_Prepare

[Calls]

- >> LCD_SetWindows
- >> LCD_DrawPoint_16Bit
- >> LCD_DrawPoint

[Called By]

- >> Show_Str

GUI_DrawFont24 (Thumb, 268 bytes, Stack size 48 bytes, gui.o(.text))

[Stack]

- Max Depth = 72
- Call Chain = GUI_DrawFont24 ⇒ LCD_DrawPoint ⇒ LCD_SetCursor ⇒ LCD_WriteRAM_Prepare

[Calls]

- >> LCD_SetWindows
- >> LCD_DrawPoint_16Bit
- >> LCD_DrawPoint

[Called By]

- >> Show_Str

GUI_DrawFont32 (Thumb, 252 bytes, Stack size 48 bytes, gui.o(.text))

[Stack]

- Max Depth = 72
- Call Chain = GUI_DrawFont32 ⇒ LCD_DrawPoint ⇒ LCD_SetCursor ⇒ LCD_WriteRAM_Prepare

[Calls]

- >> LCD_SetWindows
- >> LCD_DrawPoint_16Bit
- >> LCD_DrawPoint

[Called By]

- >> Show_Str

Show_Str (Thumb, 290 bytes, Stack size 64 bytes, gui.o(.text))

[Stack]

- Max Depth = 152
- Call Chain = Show_Str ⇒ LCD_ShowChar ⇒ LCD_DrawPoint ⇒ LCD_SetCursor ⇒ LCD_WriteRAM_Prepare

[Calls]

- >> GUI_DrawFont32
- >> GUI_DrawFont24
- >> GUI_DrawFont16
- >> LCD_ShowChar

[Called By]

- >> Gui_StrCenter
- >> Test_Color
- >> Pic_test
- >> Chinese_Font_test

Gui_StrCenter (Thumb, 68 bytes, Stack size 64 bytes, gui.o(.text))

[Stack]

- Max Depth = 216
- Call Chain = Gui_StrCenter ⇒ Show_Str ⇒ LCD_ShowChar ⇒ LCD_DrawPoint ⇒ LCD_SetCursor ⇒ LCD_WriteRAM_Prepare

[Calls]

- >> strlen
- >> Show_Str

[Called By]

- >> DrawTestPage
- >> main_test

Gui_Drawbmp16 (Thumb, 90 bytes, Stack size 32 bytes, gui.o(.text))

[Stack]

- Max Depth = 52
- Call Chain = Gui_Drawbmp16 ⇒ LCD_SetWindows ⇒ LCD_WriteRAM_Prepare

[Calls]

- >> LCD_SetWindows
- >> LCD_DrawPoint_16Bit

[Called By]

- >> Pic_test

delay_init (Thumb, 52 bytes, Stack size 8 bytes, delay.o(.text))

[Stack]

- Max Depth = 8
- Call Chain = delay_init

[Calls]

- >> SysTick_CLKSourceConfig

[Called By]

- >> main

delay_ms (Thumb, 56 bytes, Stack size 0 bytes, delay.o(.text))

[Called By]

- >> AT24CXX_WriteOneByte
- >> LCD_RESET
- >> TP_Adjust
- >> KEY_Scan
- >> Touch_Test
- >> main_test
- >> Test_FillRec
- >> Test_Color
- >> Test_Circle
- >> Pic_test
- >> LCD_Init
- >> English_Font_test
- >> Chinese_Font_test

delay_us (Thumb, 56 bytes, Stack size 0 bytes, delay.o(.text))

[Called By]

- >> TP_Read_AD
- >> IIC_Read_Byte
- >> IIC_Send_Byte
- >> IIC_NAck
- >> IIC_Ack
- >> IIC_Wait_Ack
- >> IIC_Stop
- >> IIC_Start

SystemInit (Thumb, 78 bytes, Stack size 8 bytes, system_stm32f10x.o(.text))

[Stack]

- Max Depth = 28
- Call Chain = SystemInit ⇒ SetSysClock ⇒ SetSysClockTo72

[Calls]

- >> SetSysClock

[Called By]

- >> main

[Address Reference Count : 1]

- startup_stm32f10x_md.o(.text)

SystemCoreClockUpdate (Thumb, 142 bytes, Stack size 8 bytes, system_stm32f10x.o(.text), UNUSED)

KEY_Init (Thumb, 82 bytes, Stack size 8 bytes, key.o(.text), UNUSED)

[Calls]

- >> RCC_APB2PeriphClockCmd
- >> GPIO_PinRemapConfig
- >> GPIO_Init

[Called By]

- >> Touch_Test

KEY_Scan (Thumb, 92 bytes, Stack size 8 bytes, key.o(.text), UNUSED)

[Calls]

- >> GPIO_ReadInputDataBit
- >> delay_ms

[Called By]

- >> Touch_Test

LCD_WR_REG (Thumb, 28 bytes, Stack size 0 bytes, lcd.o(.text))

[Called By]

- >> LCD_WriteRAM_Prepare
- >> LCD_WriteReg
- >> LCD_SetWindows
- >> LCD_SetCursor
- >> LCD_Init

LCD_WR_DATA (Thumb, 28 bytes, Stack size 0 bytes, lcd.o(.text))

[Called By]

- >> LCD_WriteReg
- >> LCD_SetWindows
- >> LCD_SetCursor
- >> LCD_Init

LCD_DrawPoint_16Bit (Thumb, 46 bytes, Stack size 0 bytes, lcd.o(.text))

[Called By]

- >> GUI_DrawFont32
- >> GUI_DrawFont24
- >> GUI_DrawFont16
- >> LCD_ShowChar
- >> GUI_DrawPoint
- >> Gui_Drawbmp16

LCD_WriteReg (Thumb, 20 bytes, Stack size 8 bytes, lcd.o(.text))

[Stack]

- Max Depth = 8
- Call Chain = LCD_WriteReg

[Calls]

- >> LCD_WR_DATA
- >> LCD_WR_REG

[Called By]

- >> LCD_SetParam

LCD_WriteRAM_Prepare (Thumb, 12 bytes, Stack size 4 bytes, lcd.o(.text))

[Stack]

- Max Depth = 4
- Call Chain = LCD_WriteRAM_Prepare

[Calls]

- >> LCD_WR_REG

[Called By]

- >> LCD_SetWindows
- >> LCD_SetCursor

LCD_SetCursor (Thumb, 52 bytes, Stack size 8 bytes, lcd.o(.text))

[Stack]

- Max Depth = 12
- Call Chain = LCD_SetCursor ⇒ LCD_WriteRAM_Prepare

[Calls]

- >> LCD_WriteRAM_Prepare
- >> LCD_WR_DATA
- >> LCD_WR_REG

[Called By]

- >> LCD_DrawPoint
- >> GUI_DrawPoint

LCD_DrawPoint (Thumb, 70 bytes, Stack size 12 bytes, lcd.o(.text))

[Stack]

- Max Depth = 24
- Call Chain = LCD_DrawPoint ⇒ LCD_SetCursor ⇒ LCD_WriteRAM_Prepare

[Calls]

- >> LCD_SetCursor

[Called By]

- >> TP_Drow_Touch_Point
- >> GUI_DrawFont32
- >> GUI_DrawFont24
- >> GUI_DrawFont16
- >> LCD_ShowChar
- >> LCD_DrawLine
- >> TP_Draw_Big_Point

LCD_SetWindows (Thumb, 78 bytes, Stack size 16 bytes, lcd.o(.text))

[Stack]

- Max Depth = 20
- Call Chain = LCD_SetWindows ⇒ LCD_WriteRAM_Prepare

[Calls]

- >> LCD_WriteRAM_Prepare
- >> LCD_WR_DATA
- >> LCD_WR_REG

[Called By]

- >> GUI_DrawFont32
- >> GUI_DrawFont24
- >> GUI_DrawFont16
- >> LCD_ShowChar
- >> LCD_Fill
- >> LCD_Clear
- >> Gui_Drawbmp16

LCD_Clear (Thumb, 96 bytes, Stack size 12 bytes, lcd.o(.text))

[Stack]

- Max Depth = 32
- Call Chain = LCD_Clear ⇒ LCD_SetWindows ⇒ LCD_WriteRAM_Prepare

[Calls]

- >> LCD_SetWindows

[Called By]

- >> TP_Init
- >> TP_Adjust
- >> Touch_Test
- >> LCD_Init

LCD_GPIOInit (Thumb, 88 bytes, Stack size 8 bytes, lcd.o(.text))

[Stack]

- Max Depth = 32
- Call Chain = LCD_GPIOInit ⇒ GPIO_Init

[Calls]

- >> GPIO_SetBits
- >> RCC_APB2PeriphClockCmd
- >> GPIO_PinRemapConfig
- >> GPIO_Init

[Called By]

- >> LCD_Init

LCD_RESET (Thumb, 28 bytes, Stack size 8 bytes, lcd.o(.text))

[Stack]

- Max Depth = 8
- Call Chain = LCD_RESET

[Calls]

- >> delay_ms

[Called By]

- >> LCD_Init

LCD_SetParam (Thumb, 42 bytes, Stack size 4 bytes, lcd.o(.text))

[Stack]

- Max Depth = 12
- Call Chain = LCD_SetParam ⇒ LCD_WriteReg

[Calls]

- >> LCD_WriteReg

[Called By]

- >> LCD_Init

LCD_Init (Thumb, 336 bytes, Stack size 8 bytes, lcd.o(.text))

[Stack]

- Max Depth = 40
- Call Chain = LCD_Init ⇒ LCD_GPIOInit ⇒ GPIO_Init

[Calls]

- >> LCD_SetParam
- >> LCD_RESET
- >> LCD_GPIOInit
- >> LCD_WR_DATA
- >> LCD_WR_REG
- >> delay_ms
- >> LCD_Clear

[Called By]

- >> main

IIC_Init (Thumb, 52 bytes, Stack size 8 bytes, myiic.o(.text))

[Stack]

- Max Depth = 32
- Call Chain = IIC_Init ⇒ GPIO_Init

[Calls]

- >> RCC_APB2PeriphClockCmd
- >> GPIO_Init

[Called By]

- >> AT24CXX_Init

IIC_Start (Thumb, 68 bytes, Stack size 8 bytes, myiic.o(.text))

[Stack]

- Max Depth = 8
- Call Chain = IIC_Start

[Calls]

- >> delay_us

[Called By]

- >> AT24CXX_WriteOneByte
- >> AT24CXX_ReadOneByte

IIC_Stop (Thumb, 62 bytes, Stack size 8 bytes, myiic.o(.text))

[Stack]

- Max Depth = 8
- Call Chain = IIC_Stop

[Calls]

- >> delay_us

[Called By]

- >> AT24CXX_WriteOneByte
- >> AT24CXX_ReadOneByte
- >> IIC_Wait_Ack

IIC_Wait_Ack (Thumb, 86 bytes, Stack size 8 bytes, myiic.o(.text))

[Stack]

- Max Depth = 16
- Call Chain = IIC_Wait_Ack ⇒ IIC_Stop

[Calls]

- >> IIC_Stop
- >> delay_us

[Called By]

- >> AT24CXX_WriteOneByte
- >> AT24CXX_ReadOneByte

IIC_Ack (Thumb, 66 bytes, Stack size 8 bytes, myiic.o(.text))

[Stack]

- Max Depth = 8
- Call Chain = IIC_Ack

[Calls]

- >> delay_us

[Called By]

- >> IIC_Read_Byte

IIC_NAck (Thumb, 66 bytes, Stack size 8 bytes, myiic.o(.text))

[Stack]

- Max Depth = 8
- Call Chain = IIC_NAck

[Calls]

- >> delay_us

[Called By]

- >> IIC_Read_Byte

IIC_Send_Byte (Thumb, 90 bytes, Stack size 16 bytes, myiic.o(.text))

[Stack]

- Max Depth = 16
- Call Chain = IIC_Send_Byte

[Calls]

- >> delay_us

[Called By]

- >> AT24CXX_WriteOneByte
- >> AT24CXX_ReadOneByte

IIC_Read_Byte (Thumb, 98 bytes, Stack size 16 bytes, myiic.o(.text))

[Stack]

- Max Depth = 24
- Call Chain = IIC_Read_Byte ⇒ IIC_NAck

[Calls]

- >> IIC_NAck
- >> IIC_Ack
- >> delay_us

[Called By]

- >> AT24CXX_ReadOneByte

AT24CXX_Init (Thumb, 8 bytes, Stack size 8 bytes, 24cxx.o(.text))

[Stack]

- Max Depth = 40
- Call Chain = AT24CXX_Init ⇒ IIC_Init ⇒ GPIO_Init

[Calls]

- >> IIC_Init

[Called By]

- >> TP_Init

AT24CXX_ReadOneByte (Thumb, 88 bytes, Stack size 16 bytes, 24cxx.o(.text))

[Stack]

- Max Depth = 40
- Call Chain = AT24CXX_ReadOneByte ⇒ IIC_Read_Byte ⇒ IIC_NAck

[Calls]

- >> IIC_Read_Byte
- >> IIC_Send_Byte
- >> IIC_Wait_Ack
- >> IIC_Stop
- >> IIC_Start

[Called By]

- >> TP_Get_Adjdata
- >> AT24CXX_Read
- >> AT24CXX_Check
- >> AT24CXX_ReadLenByte

AT24CXX_WriteOneByte (Thumb, 80 bytes, Stack size 16 bytes, 24cxx.o(.text))

[Stack]

- Max Depth = 32
- Call Chain = AT24CXX_WriteOneByte ⇒ IIC_Send_Byte

[Calls]

- >> IIC_Send_Byte
- >> IIC_Wait_Ack
- >> IIC_Stop
- >> IIC_Start
- >> delay_ms

[Called By]

- >> AT24CXX_Write
- >> AT24CXX_Check
- >> AT24CXX_WriteLenByte
- >> TP_Save_Adjdata

AT24CXX_WriteLenByte (Thumb, 42 bytes, Stack size 24 bytes, 24cxx.o(.text))

[Stack]

- Max Depth = 56
- Call Chain = AT24CXX_WriteLenByte ⇒ AT24CXX_WriteOneByte ⇒ IIC_Send_Byte

[Calls]

- >> AT24CXX_WriteOneByte

[Called By]

- >> TP_Save_Adjdata

AT24CXX_ReadLenByte (Thumb, 44 bytes, Stack size 24 bytes, 24cxx.o(.text))

[Stack]

- Max Depth = 64
- Call Chain = AT24CXX_ReadLenByte ⇒ AT24CXX_ReadOneByte ⇒ IIC_Read_Byte ⇒ IIC_NAck

[Calls]

- >> AT24CXX_ReadOneByte

[Called By]

- >> TP_Get_Adjdata

AT24CXX_Check (Thumb, 46 bytes, Stack size 8 bytes, 24cxx.o(.text), UNUSED)

[Calls]

- >> AT24CXX_WriteOneByte
- >> AT24CXX_ReadOneByte

AT24CXX_Read (Thumb, 34 bytes, Stack size 16 bytes, 24cxx.o(.text), UNUSED)

[Calls]

- >> AT24CXX_ReadOneByte

AT24CXX_Write (Thumb, 36 bytes, Stack size 16 bytes, 24cxx.o(.text), UNUSED)

[Calls]

- >> AT24CXX_WriteOneByte

TP_Write_Byte (Thumb, 56 bytes, Stack size 0 bytes, touch.o(.text))

[Called By]

- >> TP_Read_AD

TP_Read_AD (Thumb, 132 bytes, Stack size 16 bytes, touch.o(.text))

[Stack]

- Max Depth = 16
- Call Chain = TP_Read_AD

[Calls]

- >> TP_Write_Byte
- >> delay_us

[Called By]

- >> TP_Read_XOY

TP_Read_XOY (Thumb, 120 bytes, Stack size 40 bytes, touch.o(.text))

[Stack]

- Max Depth = 56
- Call Chain = TP_Read_XOY ⇒ TP_Read_AD

[Calls]

- >> TP_Read_AD

[Called By]

- >> TP_Read_XY

TP_Read_XY (Thumb, 38 bytes, Stack size 24 bytes, touch.o(.text))

[Stack]

- Max Depth = 80
- Call Chain = TP_Read_XY ⇒ TP_Read_XOY ⇒ TP_Read_AD

[Calls]

- >> TP_Read_XOY

[Called By]

- >> TP_Read_XY2
- >> TP_Init

TP_Read_XY2 (Thumb, 192 bytes, Stack size 32 bytes, touch.o(.text))

[Stack]

- Max Depth = 112
- Call Chain = TP_Read_XY2 ⇒ TP_Read_XY ⇒ TP_Read_XOY ⇒ TP_Read_AD

[Calls]

- >> TP_Read_XY

[Called By]

- >> TP_Scan

TP_Drow_Touch_Point (Thumb, 116 bytes, Stack size 24 bytes, touch.o(.text))

[Stack]

- Max Depth = 132
- Call Chain = TP_Drow_Touch_Point ⇒ gui_circle ⇒ _draw_circle_8 ⇒ GUI_DrawPoint ⇒ LCD_SetCursor ⇒ LCD_WriteRAM_Prepare

[Calls]

- >> LCD_DrawPoint
- >> LCD_DrawLine
- >> gui_circle

[Called By]

- >> TP_Adjust

TP_Draw_Big_Point (Thumb, 54 bytes, Stack size 16 bytes, touch.o(.text), UNUSED)

[Calls]

- >> LCD_DrawPoint

[Called By]

- >> Touch_Test

TP_Scan (Thumb, 246 bytes, Stack size 24 bytes, touch.o(.text))

[Stack]

- Max Depth = 136
- Call Chain = TP_Scan ⇒ TP_Read_XY2 ⇒ TP_Read_XY ⇒ TP_Read_XOY ⇒ TP_Read_AD

[Calls]

- >> __aeabi_fadd
- >> TP_Read_XY2
- >> __aeabi_fmul
- >> __aeabi_ui2f
- >> __aeabi_i2f
- >> __aeabi_f2uiz

[Address Reference Count : 1]

- touch.o(.data)

TP_Save_Adjdata (Thumb, 148 bytes, Stack size 16 bytes, touch.o(.text))

[Stack]

- Max Depth = 72
- Call Chain = TP_Save_Adjdata ⇒ AT24CXX_WriteLenByte ⇒ AT24CXX_WriteOneByte ⇒ IIC_Send_Byte

[Calls]

- >> AT24CXX_WriteLenByte
- >> AT24CXX_WriteOneByte
- >> __aeabi_fmul
- >> __aeabi_f2iz

[Called By]

- >> TP_Init
- >> TP_Adjust
- >> Touch_Test

TP_Get_Adjdata (Thumb, 152 bytes, Stack size 16 bytes, touch.o(.text))

[Stack]

- Max Depth = 80
- Call Chain = TP_Get_Adjdata ⇒ AT24CXX_ReadLenByte ⇒ AT24CXX_ReadOneByte ⇒ IIC_Read_Byte ⇒ IIC_NAck

[Calls]

- >> AT24CXX_ReadLenByte
- >> AT24CXX_ReadOneByte
- >> __aeabi_i2f
- >> __aeabi_fdiv

[Called By]

- >> TP_Init
- >> TP_Adjust

TP_Adj_Info_Show (Thumb, 322 bytes, Stack size 40 bytes, touch.o(.text))

[Stack]

- Max Depth = 192
- Call Chain = TP_Adj_Info_Show ⇒ LCD_ShowNum ⇒ LCD_ShowChar ⇒ LCD_DrawPoint ⇒ LCD_SetCursor ⇒ LCD_WriteRAM_Prepare

[Calls]

- >> LCD_ShowNum
- >> LCD_ShowString

[Called By]

- >> TP_Adjust

TP_Adjust (Thumb, 2242 bytes, Stack size 88 bytes, touch.o(.text))

[Stack]

- Max Depth = 280
- Call Chain = TP_Adjust ⇒ TP_Adj_Info_Show ⇒ LCD_ShowNum ⇒ LCD_ShowChar ⇒ LCD_DrawPoint ⇒ LCD_SetCursor ⇒ LCD_WriteRAM_Prepare

[Calls]

- >> __aeabi_fsub
- >> __aeabi_f2d
- >> __aeabi_cdrcmple
- >> __aeabi_cdcmple
- >> __aeabi_ui2d
- >> __aeabi_d2uiz
- >> TP_Adj_Info_Show
- >> TP_Get_Adjdata
- >> TP_Drow_Touch_Point
- >> delay_ms
- >> TP_Save_Adjdata
- >> LCD_ShowString
- >> LCD_Clear
- >> sqrt
- >> __aeabi_fmul
- >> __aeabi_ui2f
- >> __aeabi_i2f
- >> __aeabi_f2uiz
- >> __aeabi_f2iz
- >> __aeabi_fdiv

[Called By]

- >> TP_Init
- >> Touch_Test

[Address Reference Count : 1]

- touch.o(.data)

TP_Init (Thumb, 106 bytes, Stack size 8 bytes, touch.o(.text))

[Stack]

- Max Depth = 288
- Call Chain = TP_Init ⇒ TP_Adjust ⇒ TP_Adj_Info_Show ⇒ LCD_ShowNum ⇒ LCD_ShowChar ⇒ LCD_DrawPoint ⇒ LCD_SetCursor ⇒ LCD_WriteRAM_Prepare

[Calls]

- >> TP_Get_Adjdata
- >> TP_Read_XY
- >> AT24CXX_Init
- >> RCC_APB2PeriphClockCmd
- >> GPIO_Init
- >> TP_Save_Adjdata
- >> TP_Adjust
- >> LCD_Clear

[Called By]

- >> Touch_Test

[Address Reference Count : 1]

- touch.o(.data)

Reset_Handler (Thumb, 8 bytes, Stack size 0 bytes, startup_stm32f10x_md.o(.text))
[Address Reference Count : 1]

- startup_stm32f10x_md.o(RESET)

NMI_Handler (Thumb, 2 bytes, Stack size 0 bytes, startup_stm32f10x_md.o(.text))

[Calls]

- >> NMI_Handler

[Called By]

- >> NMI_Handler

[Address Reference Count : 1]

- startup_stm32f10x_md.o(RESET)

HardFault_Handler (Thumb, 2 bytes, Stack size 0 bytes, startup_stm32f10x_md.o(.text))

[Calls]

- >> HardFault_Handler

[Called By]

- >> HardFault_Handler

[Address Reference Count : 1]

- startup_stm32f10x_md.o(RESET)

MemManage_Handler (Thumb, 2 bytes, Stack size 0 bytes, startup_stm32f10x_md.o(.text))

[Calls]

- >> MemManage_Handler

[Called By]

- >> MemManage_Handler

[Address Reference Count : 1]

- startup_stm32f10x_md.o(RESET)

BusFault_Handler (Thumb, 2 bytes, Stack size 0 bytes, startup_stm32f10x_md.o(.text))

[Calls]

- >> BusFault_Handler

[Called By]

- >> BusFault_Handler

[Address Reference Count : 1]

- startup_stm32f10x_md.o(RESET)

UsageFault_Handler (Thumb, 2 bytes, Stack size 0 bytes, startup_stm32f10x_md.o(.text))

[Calls]

- >> UsageFault_Handler

[Called By]

- >> UsageFault_Handler

[Address Reference Count : 1]

- startup_stm32f10x_md.o(RESET)

SVC_Handler (Thumb, 2 bytes, Stack size 0 bytes, startup_stm32f10x_md.o(.text))

[Calls]

- >> SVC_Handler

[Called By]

- >> SVC_Handler

[Address Reference Count : 1]

- startup_stm32f10x_md.o(RESET)

DebugMon_Handler (Thumb, 2 bytes, Stack size 0 bytes, startup_stm32f10x_md.o(.text))

[Calls]

- >> DebugMon_Handler

[Called By]

- >> DebugMon_Handler

[Address Reference Count : 1]

- startup_stm32f10x_md.o(RESET)

PendSV_Handler (Thumb, 2 bytes, Stack size 0 bytes, startup_stm32f10x_md.o(.text))

[Calls]

- >> PendSV_Handler

[Called By]

- >> PendSV_Handler

[Address Reference Count : 1]

- startup_stm32f10x_md.o(RESET)

SysTick_Handler (Thumb, 2 bytes, Stack size 0 bytes, startup_stm32f10x_md.o(.text))

[Calls]

- >> SysTick_Handler

[Called By]

- >> SysTick_Handler

[Address Reference Count : 1]

- startup_stm32f10x_md.o(RESET)

ADC1_2_IRQHandler (Thumb, 0 bytes, Stack size 0 bytes, startup_stm32f10x_md.o(.text))

[Calls]

- >> ADC1_2_IRQHandler

[Called By]

- >> ADC1_2_IRQHandler

[Address Reference Count : 1]

- startup_stm32f10x_md.o(RESET)

CAN1_RX1_IRQHandler (Thumb, 0 bytes, Stack size 0 bytes, startup_stm32f10x_md.o(.text))
[Address Reference Count : 1]

- startup_stm32f10x_md.o(RESET)

CAN1_SCE_IRQHandler (Thumb, 0 bytes, Stack size 0 bytes, startup_stm32f10x_md.o(.text))
[Address Reference Count : 1]

- startup_stm32f10x_md.o(RESET)

DMA1_Channel1_IRQHandler (Thumb, 0 bytes, Stack size 0 bytes, startup_stm32f10x_md.o(.text))
[Address Reference Count : 1]

- startup_stm32f10x_md.o(RESET)

DMA1_Channel2_IRQHandler (Thumb, 0 bytes, Stack size 0 bytes, startup_stm32f10x_md.o(.text))
[Address Reference Count : 1]

- startup_stm32f10x_md.o(RESET)

DMA1_Channel3_IRQHandler (Thumb, 0 bytes, Stack size 0 bytes, startup_stm32f10x_md.o(.text))
[Address Reference Count : 1]

- startup_stm32f10x_md.o(RESET)

DMA1_Channel4_IRQHandler (Thumb, 0 bytes, Stack size 0 bytes, startup_stm32f10x_md.o(.text))
[Address Reference Count : 1]

- startup_stm32f10x_md.o(RESET)

DMA1_Channel5_IRQHandler (Thumb, 0 bytes, Stack size 0 bytes, startup_stm32f10x_md.o(.text))
[Address Reference Count : 1]

- startup_stm32f10x_md.o(RESET)

DMA1_Channel6_IRQHandler (Thumb, 0 bytes, Stack size 0 bytes, startup_stm32f10x_md.o(.text))
[Address Reference Count : 1]

- startup_stm32f10x_md.o(RESET)

DMA1_Channel7_IRQHandler (Thumb, 0 bytes, Stack size 0 bytes, startup_stm32f10x_md.o(.text))
[Address Reference Count : 1]

- startup_stm32f10x_md.o(RESET)

EXTI0_IRQHandler (Thumb, 0 bytes, Stack size 0 bytes, startup_stm32f10x_md.o(.text))
[Address Reference Count : 1]

- startup_stm32f10x_md.o(RESET)

EXTI15_10_IRQHandler (Thumb, 0 bytes, Stack size 0 bytes, startup_stm32f10x_md.o(.text))
[Address Reference Count : 1]

- startup_stm32f10x_md.o(RESET)

EXTI1_IRQHandler (Thumb, 0 bytes, Stack size 0 bytes, startup_stm32f10x_md.o(.text))
[Address Reference Count : 1]

- startup_stm32f10x_md.o(RESET)

EXTI2_IRQHandler (Thumb, 0 bytes, Stack size 0 bytes, startup_stm32f10x_md.o(.text))
[Address Reference Count : 1]

- startup_stm32f10x_md.o(RESET)

EXTI3_IRQHandler (Thumb, 0 bytes, Stack size 0 bytes, startup_stm32f10x_md.o(.text))
[Address Reference Count : 1]

- startup_stm32f10x_md.o(RESET)

EXTI4_IRQHandler (Thumb, 0 bytes, Stack size 0 bytes, startup_stm32f10x_md.o(.text))
[Address Reference Count : 1]

- startup_stm32f10x_md.o(RESET)

EXTI9_5_IRQHandler (Thumb, 0 bytes, Stack size 0 bytes, startup_stm32f10x_md.o(.text))
[Address Reference Count : 1]

- startup_stm32f10x_md.o(RESET)

FLASH_IRQHandler (Thumb, 0 bytes, Stack size 0 bytes, startup_stm32f10x_md.o(.text))
[Address Reference Count : 1]

- startup_stm32f10x_md.o(RESET)

I2C1_ER_IRQHandler (Thumb, 0 bytes, Stack size 0 bytes, startup_stm32f10x_md.o(.text))
[Address Reference Count : 1]

- startup_stm32f10x_md.o(RESET)

I2C1_EV_IRQHandler (Thumb, 0 bytes, Stack size 0 bytes, startup_stm32f10x_md.o(.text))
[Address Reference Count : 1]

- startup_stm32f10x_md.o(RESET)

I2C2_ER_IRQHandler (Thumb, 0 bytes, Stack size 0 bytes, startup_stm32f10x_md.o(.text))
[Address Reference Count : 1]

- startup_stm32f10x_md.o(RESET)

I2C2_EV_IRQHandler (Thumb, 0 bytes, Stack size 0 bytes, startup_stm32f10x_md.o(.text))
[Address Reference Count : 1]

- startup_stm32f10x_md.o(RESET)

PVD_IRQHandler (Thumb, 0 bytes, Stack size 0 bytes, startup_stm32f10x_md.o(.text))
[Address Reference Count : 1]

- startup_stm32f10x_md.o(RESET)

RCC_IRQHandler (Thumb, 0 bytes, Stack size 0 bytes, startup_stm32f10x_md.o(.text))
[Address Reference Count : 1]

- startup_stm32f10x_md.o(RESET)

RTCAlarm_IRQHandler (Thumb, 0 bytes, Stack size 0 bytes, startup_stm32f10x_md.o(.text))
[Address Reference Count : 1]

- startup_stm32f10x_md.o(RESET)

RTC_IRQHandler (Thumb, 0 bytes, Stack size 0 bytes, startup_stm32f10x_md.o(.text))
[Address Reference Count : 1]

- startup_stm32f10x_md.o(RESET)

SPI1_IRQHandler (Thumb, 0 bytes, Stack size 0 bytes, startup_stm32f10x_md.o(.text))
[Address Reference Count : 1]

- startup_stm32f10x_md.o(RESET)

SPI2_IRQHandler (Thumb, 0 bytes, Stack size 0 bytes, startup_stm32f10x_md.o(.text))
[Address Reference Count : 1]

- startup_stm32f10x_md.o(RESET)

TAMPER_IRQHandler (Thumb, 0 bytes, Stack size 0 bytes, startup_stm32f10x_md.o(.text))
[Address Reference Count : 1]

- startup_stm32f10x_md.o(RESET)

TIM1_BRK_IRQHandler (Thumb, 0 bytes, Stack size 0 bytes, startup_stm32f10x_md.o(.text))
[Address Reference Count : 1]

- startup_stm32f10x_md.o(RESET)

TIM1_CC_IRQHandler (Thumb, 0 bytes, Stack size 0 bytes, startup_stm32f10x_md.o(.text))
[Address Reference Count : 1]

- startup_stm32f10x_md.o(RESET)

TIM1_TRG_COM_IRQHandler (Thumb, 0 bytes, Stack size 0 bytes, startup_stm32f10x_md.o(.text))
[Address Reference Count : 1]

- startup_stm32f10x_md.o(RESET)

TIM1_UP_IRQHandler (Thumb, 0 bytes, Stack size 0 bytes, startup_stm32f10x_md.o(.text))
[Address Reference Count : 1]

- startup_stm32f10x_md.o(RESET)

TIM2_IRQHandler (Thumb, 0 bytes, Stack size 0 bytes, startup_stm32f10x_md.o(.text))
[Address Reference Count : 1]

- startup_stm32f10x_md.o(RESET)

TIM3_IRQHandler (Thumb, 0 bytes, Stack size 0 bytes, startup_stm32f10x_md.o(.text))
[Address Reference Count : 1]

- startup_stm32f10x_md.o(RESET)

TIM4_IRQHandler (Thumb, 0 bytes, Stack size 0 bytes, startup_stm32f10x_md.o(.text))
[Address Reference Count : 1]

- startup_stm32f10x_md.o(RESET)

USART1_IRQHandler (Thumb, 0 bytes, Stack size 0 bytes, startup_stm32f10x_md.o(.text))
[Address Reference Count : 1]

- startup_stm32f10x_md.o(RESET)

USART2_IRQHandler (Thumb, 0 bytes, Stack size 0 bytes, startup_stm32f10x_md.o(.text))
[Address Reference Count : 1]

- startup_stm32f10x_md.o(RESET)

USART3_IRQHandler (Thumb, 0 bytes, Stack size 0 bytes, startup_stm32f10x_md.o(.text))
[Address Reference Count : 1]

- startup_stm32f10x_md.o(RESET)

USBWakeUp_IRQHandler (Thumb, 0 bytes, Stack size 0 bytes, startup_stm32f10x_md.o(.text))
[Address Reference Count : 1]

- startup_stm32f10x_md.o(RESET)

USB_HP_CAN1_TX_IRQHandler (Thumb, 0 bytes, Stack size 0 bytes, startup_stm32f10x_md.o(.text))
[Address Reference Count : 1]

- startup_stm32f10x_md.o(RESET)

USB_LP_CAN1_RX0_IRQHandler (Thumb, 0 bytes, Stack size 0 bytes, startup_stm32f10x_md.o(.text))
[Address Reference Count : 1]

- startup_stm32f10x_md.o(RESET)

WWDG_IRQHandler (Thumb, 0 bytes, Stack size 0 bytes, startup_stm32f10x_md.o(.text))
[Address Reference Count : 1]

- startup_stm32f10x_md.o(RESET)

__user_initial_stackheap (Thumb, 0 bytes, Stack size unknown bytes, startup_stm32f10x_md.o(.text))

[Called By]

- >> __user_setup_stackheap

NVIC_PriorityGroupConfig (Thumb, 10 bytes, Stack size 0 bytes, misc.o(.text), UNUSED)

NVIC_Init (Thumb, 100 bytes, Stack size 16 bytes, misc.o(.text), UNUSED)

NVIC_SetVectorTable (Thumb, 14 bytes, Stack size 0 bytes, misc.o(.text), UNUSED)

NVIC_SystemLPConfig (Thumb, 34 bytes, Stack size 0 bytes, misc.o(.text), UNUSED)

SysTick_CLKSourceConfig (Thumb, 40 bytes, Stack size 0 bytes, misc.o(.text))

[Called By]

- >> delay_init

GPIO_DeInit (Thumb, 172 bytes, Stack size 8 bytes, stm32f10x_gpio.o(.text), UNUSED)

[Calls]

- >> RCC_APB2PeriphResetCmd

GPIO_AFIODeInit (Thumb, 20 bytes, Stack size 8 bytes, stm32f10x_gpio.o(.text), UNUSED)

[Calls]

- >> RCC_APB2PeriphResetCmd

GPIO_Init (Thumb, 278 bytes, Stack size 24 bytes, stm32f10x_gpio.o(.text))

[Stack]

- Max Depth = 24
- Call Chain = GPIO_Init

[Called By]

- >> IIC_Init
- >> LCD_GPIOInit
- >> TP_Init
- >> KEY_Init

GPIO_StructInit (Thumb, 16 bytes, Stack size 0 bytes, stm32f10x_gpio.o(.text), UNUSED)

GPIO_ReadInputDataBit (Thumb, 18 bytes, Stack size 0 bytes, stm32f10x_gpio.o(.text), UNUSED)

[Called By]

- >> KEY_Scan

GPIO_ReadInputData (Thumb, 8 bytes, Stack size 0 bytes, stm32f10x_gpio.o(.text), UNUSED)

GPIO_ReadOutputDataBit (Thumb, 18 bytes, Stack size 0 bytes, stm32f10x_gpio.o(.text), UNUSED)

GPIO_ReadOutputData (Thumb, 8 bytes, Stack size 0 bytes, stm32f10x_gpio.o(.text), UNUSED)

GPIO_SetBits (Thumb, 4 bytes, Stack size 0 bytes, stm32f10x_gpio.o(.text))

[Called By]

- >> LCD_GPIOInit

GPIO_ResetBits (Thumb, 4 bytes, Stack size 0 bytes, stm32f10x_gpio.o(.text), UNUSED)

GPIO_WriteBit (Thumb, 10 bytes, Stack size 0 bytes, stm32f10x_gpio.o(.text), UNUSED)

GPIO_Write (Thumb, 4 bytes, Stack size 0 bytes, stm32f10x_gpio.o(.text), UNUSED)

GPIO_PinLockConfig (Thumb, 18 bytes, Stack size 0 bytes, stm32f10x_gpio.o(.text), UNUSED)

GPIO_EventOutputConfig (Thumb, 26 bytes, Stack size 0 bytes, stm32f10x_gpio.o(.text), UNUSED)

GPIO_EventOutputCmd (Thumb, 6 bytes, Stack size 0 bytes, stm32f10x_gpio.o(.text), UNUSED)

GPIO_PinRemapConfig (Thumb, 138 bytes, Stack size 20 bytes, stm32f10x_gpio.o(.text))

[Stack]

- Max Depth = 20
- Call Chain = GPIO_PinRemapConfig

[Called By]

- >> LCD_GPIOInit
- >> KEY_Init

GPIO_EXTILineConfig (Thumb, 66 bytes, Stack size 12 bytes, stm32f10x_gpio.o(.text), UNUSED)

GPIO_ETH_MediaInterfaceConfig (Thumb, 8 bytes, Stack size 0 bytes, stm32f10x_gpio.o(.text), UNUSED)

RCC_DeInit (Thumb, 64 bytes, Stack size 0 bytes, stm32f10x_rcc.o(.text), UNUSED)

RCC_HSEConfig (Thumb, 70 bytes, Stack size 0 bytes, stm32f10x_rcc.o(.text), UNUSED)

RCC_GetFlagStatus (Thumb, 56 bytes, Stack size 8 bytes, stm32f10x_rcc.o(.text), UNUSED)

[Called By]

- >> RCC_WaitForHSEStartUp

RCC_WaitForHSEStartUp (Thumb, 56 bytes, Stack size 16 bytes, stm32f10x_rcc.o(.text), UNUSED)

[Calls]

- >> RCC_GetFlagStatus

RCC_AdjustHSICalibrationValue (Thumb, 20 bytes, Stack size 0 bytes, stm32f10x_rcc.o(.text), UNUSED)

RCC_HSICmd (Thumb, 6 bytes, Stack size 0 bytes, stm32f10x_rcc.o(.text), UNUSED)

RCC_PLLConfig (Thumb, 24 bytes, Stack size 0 bytes, stm32f10x_rcc.o(.text), UNUSED)

RCC_PLLCmd (Thumb, 6 bytes, Stack size 0 bytes, stm32f10x_rcc.o(.text), UNUSED)

RCC_SYSCLKConfig (Thumb, 18 bytes, Stack size 0 bytes, stm32f10x_rcc.o(.text), UNUSED)

RCC_GetSYSCLKSource (Thumb, 10 bytes, Stack size 0 bytes, stm32f10x_rcc.o(.text), UNUSED)

RCC_HCLKConfig (Thumb, 18 bytes, Stack size 0 bytes, stm32f10x_rcc.o(.text), UNUSED)

RCC_PCLK1Config (Thumb, 18 bytes, Stack size 0 bytes, stm32f10x_rcc.o(.text), UNUSED)

RCC_PCLK2Config (Thumb, 20 bytes, Stack size 0 bytes, stm32f10x_rcc.o(.text), UNUSED)

RCC_ITConfig (Thumb, 26 bytes, Stack size 0 bytes, stm32f10x_rcc.o(.text), UNUSED)

RCC_USBCLKConfig (Thumb, 8 bytes, Stack size 0 bytes, stm32f10x_rcc.o(.text), UNUSED)

RCC_ADCCLKConfig (Thumb, 18 bytes, Stack size 0 bytes, stm32f10x_rcc.o(.text), UNUSED)

RCC_LSEConfig (Thumb, 50 bytes, Stack size 0 bytes, stm32f10x_rcc.o(.text), UNUSED)

RCC_LSICmd (Thumb, 6 bytes, Stack size 0 bytes, stm32f10x_rcc.o(.text), UNUSED)

RCC_RTCCLKConfig (Thumb, 12 bytes, Stack size 0 bytes, stm32f10x_rcc.o(.text), UNUSED)

RCC_RTCCLKCmd (Thumb, 8 bytes, Stack size 0 bytes, stm32f10x_rcc.o(.text), UNUSED)

RCC_GetClocksFreq (Thumb, 192 bytes, Stack size 12 bytes, stm32f10x_rcc.o(.text), UNUSED)

RCC_AHBPeriphClockCmd (Thumb, 26 bytes, Stack size 0 bytes, stm32f10x_rcc.o(.text), UNUSED)

RCC_APB2PeriphClockCmd (Thumb, 26 bytes, Stack size 0 bytes, stm32f10x_rcc.o(.text))

[Called By]

- >> IIC_Init
- >> LCD_GPIOInit
- >> TP_Init
- >> KEY_Init

RCC_APB1PeriphClockCmd (Thumb, 26 bytes, Stack size 0 bytes, stm32f10x_rcc.o(.text), UNUSED)

RCC_APB2PeriphResetCmd (Thumb, 26 bytes, Stack size 0 bytes, stm32f10x_rcc.o(.text), UNUSED)

[Called By]

- >> GPIO_AFIODeInit
- >> GPIO_DeInit

RCC_APB1PeriphResetCmd (Thumb, 26 bytes, Stack size 0 bytes, stm32f10x_rcc.o(.text), UNUSED)

RCC_BackupResetCmd (Thumb, 8 bytes, Stack size 0 bytes, stm32f10x_rcc.o(.text), UNUSED)

RCC_ClockSecuritySystemCmd (Thumb, 6 bytes, Stack size 0 bytes, stm32f10x_rcc.o(.text), UNUSED)

RCC_MCOConfig (Thumb, 6 bytes, Stack size 0 bytes, stm32f10x_rcc.o(.text), UNUSED)

RCC_ClearFlag (Thumb, 14 bytes, Stack size 0 bytes, stm32f10x_rcc.o(.text), UNUSED)

RCC_GetITStatus (Thumb, 20 bytes, Stack size 0 bytes, stm32f10x_rcc.o(.text), UNUSED)

RCC_ClearITPendingBit (Thumb, 6 bytes, Stack size 0 bytes, stm32f10x_rcc.o(.text), UNUSED)

strlen (Thumb, 62 bytes, Stack size 8 bytes, strlen.o(.text))

[Stack]

- Max Depth = 8
- Call Chain = strlen

[Called By]

- >> Gui_StrCenter

__use_two_region_memory (Thumb, 2 bytes, Stack size 0 bytes, heapauxi.o(.text), UNUSED)

__rt_heap_escrow$2region (Thumb, 2 bytes, Stack size 0 bytes, heapauxi.o(.text), UNUSED)

__rt_heap_expand$2region (Thumb, 2 bytes, Stack size 0 bytes, heapauxi.o(.text), UNUSED)

__read_errno (Thumb, 10 bytes, Stack size 8 bytes, _rserrno.o(.text), UNUSED)

[Calls]

- >> __aeabi_errno_addr

__set_errno (Thumb, 12 bytes, Stack size 8 bytes, _rserrno.o(.text))

[Stack]

- Max Depth = 8
- Call Chain = __set_errno

[Calls]

- >> __aeabi_errno_addr

[Called By]

- >> sqrt

__aeabi_errno_addr (Thumb, 8 bytes, Stack size 0 bytes, rt_errno_addr_intlibspace.o(.text))

[Called By]

- >> __set_errno
- >> __read_errno

__errno$intlibspace (Thumb, 0 bytes, Stack size 0 bytes, rt_errno_addr_intlibspace.o(.text), UNUSED)

__rt_errno_addr$intlibspace (Thumb, 0 bytes, Stack size 0 bytes, rt_errno_addr_intlibspace.o(.text), UNUSED)

__user_libspace (Thumb, 8 bytes, Stack size 0 bytes, libspace.o(.text), UNUSED)

__user_perproc_libspace (Thumb, 0 bytes, Stack size 0 bytes, libspace.o(.text))

[Called By]

- >> __user_setup_stackheap

__user_perthread_libspace (Thumb, 0 bytes, Stack size 0 bytes, libspace.o(.text), UNUSED)

__user_setup_stackheap (Thumb, 74 bytes, Stack size 8 bytes, sys_stackheap_outer.o(.text))

[Stack]

- Max Depth = 8 + Unknown Stack Size
- Call Chain = __user_setup_stackheap

[Calls]

- >> __user_initial_stackheap
- >> __user_perproc_libspace

[Called By]

- >> __rt_entry_sh

exit (Thumb, 12 bytes, Stack size 0 bytes, exit.o(.text))

[Calls]

- >> __rt_exit

[Called By]

- >> __rt_entry_main

_sys_exit (Thumb, 8 bytes, Stack size 0 bytes, sys_exit.o(.text))

[Called By]

- >> __rt_exit_exit

__I$use$semihosting (Thumb, 0 bytes, Stack size 0 bytes, use_no_semi.o(.text), UNUSED)

__use_no_semihosting_swi (Thumb, 2 bytes, Stack size 0 bytes, use_no_semi.o(.text), UNUSED)

__semihosting_library_function (Thumb, 0 bytes, Stack size 24 bytes, indicate_semi.o(.text), UNUSED)

sqrt (Thumb, 76 bytes, Stack size 24 bytes, sqrt.o(i.sqrt))

[Stack]

- Max Depth = 64
- Call Chain = sqrt ⇒ _dsqrt ⇒ __fpl_dnaninf

[Calls]

- >> _dsqrt
- >> __set_errno

[Called By]

- >> TP_Adjust

__fpl_dcmp_Inf (Thumb, 24 bytes, Stack size 0 bytes, dcmpi.o(x$fpl$dcmpinf), UNUSED)

[Called By]

- >> _dcmple

__aeabi_d2uiz (Thumb, 0 bytes, Stack size 32 bytes, dfixu.o(x$fpl$dfixu))

[Stack]

- Max Depth = 32
- Call Chain = __aeabi_d2uiz

[Called By]

- >> TP_Adjust

_dfixu (Thumb, 90 bytes, Stack size 32 bytes, dfixu.o(x$fpl$dfixu), UNUSED)

[Calls]

- >> __fpl_dnaninf

__aeabi_ui2d (Thumb, 0 bytes, Stack size 0 bytes, dflt_clz.o(x$fpl$dfltu))

[Called By]

- >> TP_Adjust

_dfltu (Thumb, 38 bytes, Stack size 0 bytes, dflt_clz.o(x$fpl$dfltu), UNUSED)

__aeabi_cdcmple (Thumb, 0 bytes, Stack size 32 bytes, dleqf.o(x$fpl$dleqf))

[Stack]

- Max Depth = 32
- Call Chain = __aeabi_cdcmple

[Called By]

- >> TP_Adjust

_dcmple (Thumb, 120 bytes, Stack size 32 bytes, dleqf.o(x$fpl$dleqf), UNUSED)

[Calls]

- >> __fpl_dnaninf
- >> __fpl_dcmp_Inf

__fpl_dcmple_InfNaN (Thumb, 0 bytes, Stack size unknown bytes, dleqf.o(x$fpl$dleqf), UNUSED)

[Called By]

- >> _drcmple

__fpl_dnaninf (Thumb, 156 bytes, Stack size 16 bytes, dnaninf.o(x$fpl$dnaninf))

[Stack]

- Max Depth = 16
- Call Chain = __fpl_dnaninf

[Called By]

- >> _dcmple
- >> _dfixu
- >> _dsqrt

__fpl_dretinf (Thumb, 12 bytes, Stack size 0 bytes, dretinf.o(x$fpl$dretinf), UNUSED)

[Called By]

- >> _f2d

__aeabi_cdrcmple (Thumb, 0 bytes, Stack size 16 bytes, drleqf.o(x$fpl$drleqf))

[Stack]

- Max Depth = 16
- Call Chain = __aeabi_cdrcmple

[Called By]

- >> TP_Adjust

_drcmple (Thumb, 108 bytes, Stack size 16 bytes, drleqf.o(x$fpl$drleqf), UNUSED)

[Calls]

- >> __fpl_dcmple_InfNaN

_dsqrt (Thumb, 456 bytes, Stack size 24 bytes, dsqrt_noumaal.o(x$fpl$dsqrt))

[Stack]

- Max Depth = 40
- Call Chain = _dsqrt ⇒ __fpl_dnaninf

[Calls]

- >> __fpl_dnaninf

[Called By]

- >> sqrt

__aeabi_f2d (Thumb, 0 bytes, Stack size 16 bytes, f2d.o(x$fpl$f2d))

[Stack]

- Max Depth = 16
- Call Chain = __aeabi_f2d

[Called By]

- >> TP_Adjust

_f2d (Thumb, 86 bytes, Stack size 16 bytes, f2d.o(x$fpl$f2d), UNUSED)

[Calls]

- >> __fpl_fnaninf
- >> __fpl_dretinf

__aeabi_fadd (Thumb, 0 bytes, Stack size 16 bytes, faddsub_clz.o(x$fpl$fadd))

[Stack]

- Max Depth = 16
- Call Chain = __aeabi_fadd

[Called By]

- >> TP_Scan

_fadd (Thumb, 196 bytes, Stack size 16 bytes, faddsub_clz.o(x$fpl$fadd), UNUSED)

[Calls]

- >> _fsub1
- >> __fpl_fretinf
- >> __fpl_fnaninf

__aeabi_fdiv (Thumb, 0 bytes, Stack size 16 bytes, fdiv.o(x$fpl$fdiv))

[Stack]

- Max Depth = 16
- Call Chain = __aeabi_fdiv

[Called By]

- >> TP_Get_Adjdata
- >> TP_Adjust

_fdiv (Thumb, 384 bytes, Stack size 16 bytes, fdiv.o(x$fpl$fdiv), UNUSED)

[Calls]

- >> __fpl_fretinf
- >> __fpl_fnaninf

__aeabi_f2iz (Thumb, 0 bytes, Stack size 16 bytes, ffix.o(x$fpl$ffix))

[Stack]

- Max Depth = 16
- Call Chain = __aeabi_f2iz

[Called By]

- >> TP_Save_Adjdata
- >> TP_Adjust

_ffix (Thumb, 54 bytes, Stack size 16 bytes, ffix.o(x$fpl$ffix), UNUSED)

[Calls]

- >> __fpl_fnaninf

__aeabi_f2uiz (Thumb, 0 bytes, Stack size 16 bytes, ffixu.o(x$fpl$ffixu))

[Stack]

- Max Depth = 16
- Call Chain = __aeabi_f2uiz

[Called By]

- >> TP_Scan
- >> TP_Adjust

_ffixu (Thumb, 62 bytes, Stack size 16 bytes, ffixu.o(x$fpl$ffixu), UNUSED)

[Calls]

- >> __fpl_fnaninf

__aeabi_i2f (Thumb, 0 bytes, Stack size 0 bytes, fflt_clz.o(x$fpl$fflt))

[Called By]

- >> TP_Get_Adjdata
- >> TP_Scan
- >> TP_Adjust

_fflt (Thumb, 48 bytes, Stack size 0 bytes, fflt_clz.o(x$fpl$fflt), UNUSED)

__aeabi_ui2f (Thumb, 0 bytes, Stack size 0 bytes, fflt_clz.o(x$fpl$ffltu))

[Called By]

- >> TP_Scan
- >> TP_Adjust

_ffltu (Thumb, 38 bytes, Stack size 0 bytes, fflt_clz.o(x$fpl$ffltu), UNUSED)

__aeabi_fmul (Thumb, 0 bytes, Stack size 16 bytes, fmul.o(x$fpl$fmul))

[Stack]

- Max Depth = 16
- Call Chain = __aeabi_fmul

[Called By]

- >> TP_Scan
- >> TP_Save_Adjdata
- >> TP_Adjust

_fmul (Thumb, 258 bytes, Stack size 16 bytes, fmul.o(x$fpl$fmul), UNUSED)

[Calls]

- >> __fpl_fretinf
- >> __fpl_fnaninf

__fpl_fnaninf (Thumb, 140 bytes, Stack size 8 bytes, fnaninf.o(x$fpl$fnaninf), UNUSED)

[Called By]

- >> _fsub
- >> _fadd
- >> _f2d
- >> _fmul
- >> _ffixu
- >> _ffix
- >> _fdiv

__fpl_fretinf (Thumb, 10 bytes, Stack size 0 bytes, fretinf.o(x$fpl$fretinf), UNUSED)

[Called By]

- >> _fadd
- >> _fmul
- >> _fdiv

__aeabi_fsub (Thumb, 0 bytes, Stack size 16 bytes, faddsub_clz.o(x$fpl$fsub))

[Stack]

- Max Depth = 16
- Call Chain = __aeabi_fsub

[Called By]

- >> TP_Adjust

_fsub (Thumb, 234 bytes, Stack size 16 bytes, faddsub_clz.o(x$fpl$fsub), UNUSED)

[Calls]

- >> _fadd1
- >> __fpl_fnaninf

### Local Symbols

SetSysClockTo72 (Thumb, 214 bytes, Stack size 12 bytes, system_stm32f10x.o(.text))

[Stack]

- Max Depth = 12
- Call Chain = SetSysClockTo72

[Called By]

- >> SetSysClock

SetSysClock (Thumb, 8 bytes, Stack size 8 bytes, system_stm32f10x.o(.text))

[Stack]

- Max Depth = 20
- Call Chain = SetSysClock ⇒ SetSysClockTo72

[Calls]

- >> SetSysClockTo72

[Called By]

- >> SystemInit

_fadd1 (Thumb, 0 bytes, Stack size unknown bytes, faddsub_clz.o(x$fpl$fadd), UNUSED)

[Called By]

- >> _fsub

_fsub1 (Thumb, 0 bytes, Stack size unknown bytes, faddsub_clz.o(x$fpl$fsub), UNUSED)

[Called By]

- >> _fadd

### Undefined Global Symbols
