MH-Bio/vaccine_dispenser/Testing Data/Temperature Data/temperature data.xlsx

Sheet: Sheet1
temp | voltage
23.5 | 136.7 | 5.817021277
19 | 116.7 | 6.142105263
18 | 113.1 | 6.283333333
17 | 109.2 | 6.423529412
17 | 107.7 | 6.335294118
17 | 106.9 | 6.288235294
16 | 104.8 | 6.55
 |  | 6.262788385

Sheet: Sheet2
i | measured voltage | difference from previous |  | With added 30K resistance |  | 1meg |  | 2meg |  | 3meg
0 | 24 | 0
1 | 62.5 | 38.5
2 | 100.5 | 38
3 | 138.9 | 38.4
4 | 179.7 | 40.8
5 | 217 | 37.3 |  |  |  |  |  | 20
6 | 255 | 38 |  |  |  |  |  | 33 | 13
7 | 293 | 38 |  | 234 |  |  |  | 59.5 | 26.5
8 | 331 | 38 |  | 270 | 36 |  |  | 76 | 16.5
9 | 369 | 38 |  | 307 | 37 | 227 |  | 90 | 14
10 | 407 | 38 |  | 344 | 37 | 250 | 23 | 114 | 24
 |  |  |  |  |  |  | i=70 | 1.88 |  | 1.75
 |  |  |  |  |  |  | i=71 | 1.9 | 0.02 | 1.76
 |  |  |  |  |  |  | 72 |  |  | 1.8
 |  |  |  |  |  |  | 73 |  |  | 1.82
 | 333333.3333 |  |  |  |  |  | 74 |  |  | 1.84
 |  | 0 | 5 |  |  |  | 75 |  |  | 1.87
 |  | 1 | 3.8
 |  | 2 | 3.4
 |  | 3 | 3.12
 |  | 18 | 2.1 | 0.04
 |  | 17 | 2.14 | 0.06
 |  | 16 | 2.2 | 0.06
 |  | 15 | 2.26 | 0.11
 |  | 14 | 2.37 | 0.04
 |  | 13 | 2.41 | 0.1
 |  | 12 | 2.51 | -2.51
 |  | solving for Y = 1.28, x=29.48918
