MH-Bio/vaccine_dispenser/joystick_test/joystick test.jpg

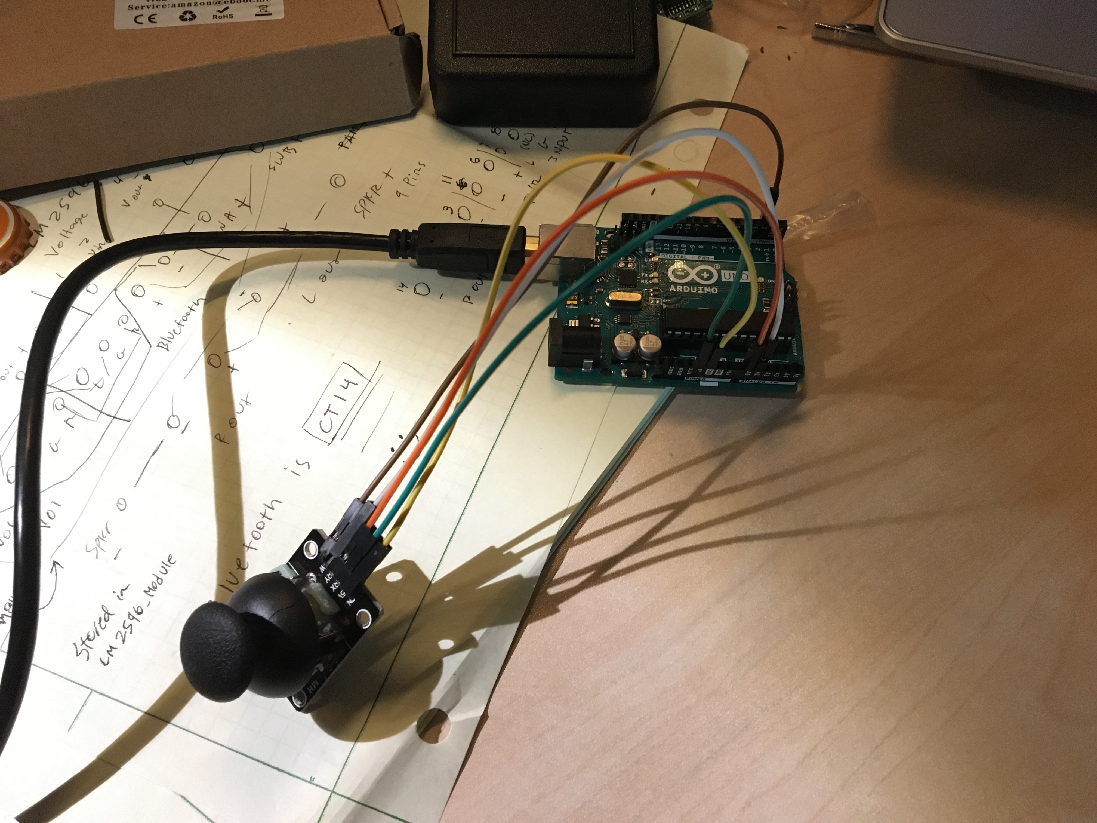
joystick_test/joystick test.jpg
