MH-Bio/vaccine_dispenser/Schematics/Temperature Control.pdf

G G

H H

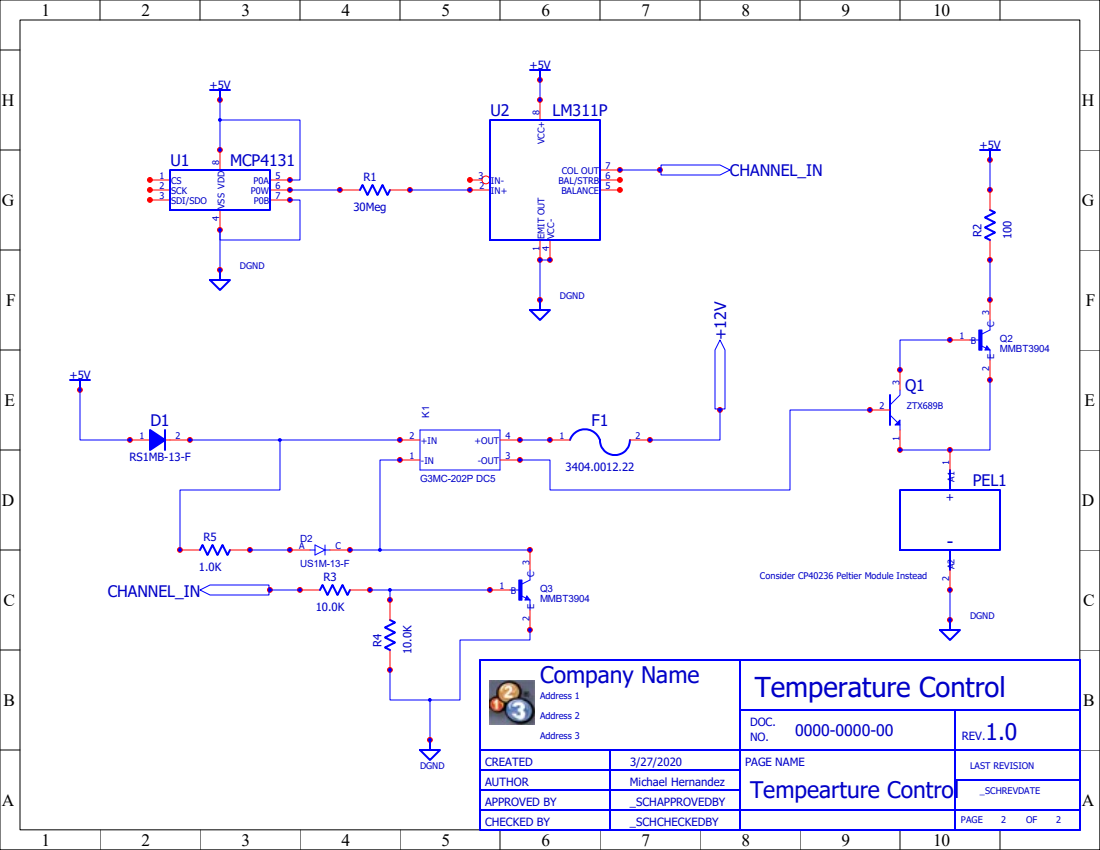
[picture p91: page 1]
