MH-Bio/vaccine_dispenser/Schematics/TMP36-Eagle.brd

## EAGLE design Schematics/TMP36-Eagle.brd (2023-05-29)

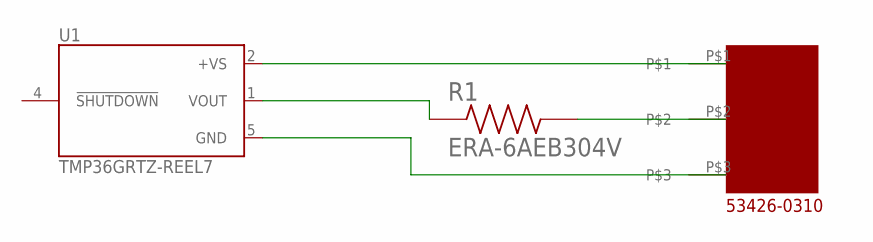
[picture p92: schematic TMP36-Eagle.sch]

Parts:
R1: ERA-6AEB304V; RESC2012X60N
U1: TMP36GRTZ-REEL7; SOT95P280X145-5N
U$6: 53426-0310

Connections:
unnamed: R1.1, U1.1 (VOUT)
unnamed: U1.2 (+VS), U$6.P$1
unnamed: U1.5 (GND), U$6.P$3
unnamed: R1.2, U$6.P$2

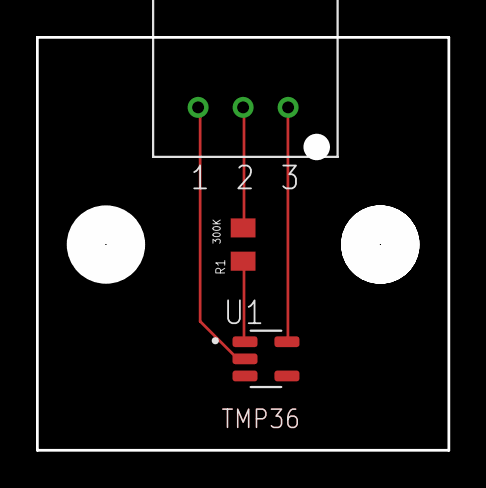
[picture p93: board TMP36-Eagle.brd from above]

Board: 2 copper layers, 22.9 x 22.9 mm, 3 parts (0 on the bottom side), 4 nets.
