MH-Bio/vaccine_dispenser/Arduino Sketches/CardInfo/CardInfo.ino

/*
  SD card test

  This example shows how use the utility libraries on which the'
  SD library is based in order to get info about your SD card.
  Very useful for testing a card when you're not sure whether its working or not.

  The circuit:
    SD card attached to SPI bus as follows:
 ** MOSI - pin 11 on Arduino Uno/Duemilanove/Diecimila
 ** MISO - pin 12 on Arduino Uno/Duemilanove/Diecimila
 ** CLK - pin 13 on Arduino Uno/Duemilanove/Diecimila
 ** CS - depends on your SD card shield or module.
 		Pin 4 used here for consistency with other Arduino examples


  created  28 Mar 2011
  by Limor Fried
  modified 9 Apr 2012
  by Tom Igoe
*/
// include the SD library:
#include <SPI.h>
#include <SD.h>

char a;
boolean newData = false;
File myFile;

const byte numChars = 32;
char receivedChars[numChars];
char tempChars[numChars];        // temporary array for use when parsing

// variables to hold the parsed data
char messageFromPC[numChars] = {0};
int integerFromPC = 0;
float floatFromPC = 0.0;


// set up variables using the SD utility library functions:
Sd2Card card;
SdVolume volume;
SdFile root;

// change this to match your SD shield or module;
// Arduino Ethernet shield: pin 4
// Adafruit SD shields and modules: pin 10
// Sparkfun SD shield: pin 8
// MKRZero SD: SDCARD_SS_PIN
const int chipSelect = 7;

void setup() {
  pinMode(chipSelect,OUTPUT);
  // Open serial communications and wait for port to open:
  Serial.begin(9600);
  while (!Serial) {
    ; // wait for serial port to connect. Needed for native USB port only
  }


  Serial.print("\nInitializing SD card...");

  // we'll use the initialization code from the utility libraries
  // since we're just testing if the card is working!
  if (!card.init(SPI_HALF_SPEED, chipSelect)) {
    Serial.println("initialization failed. Things to check:");
    Serial.println("* is a card inserted?");
    Serial.println("* is your wiring correct?");
    Serial.println("* did you change the chipSelect pin to match your shield or module?");
    while (1);
  } else {
    Serial.println("Wiring is correct and a card is present.");
  }

  // print the type of card
  Serial.println();
  Serial.print("Card type:         ");
  switch (card.type()) {
    case SD_CARD_TYPE_SD1:
      Serial.println("SD1");
      break;
    case SD_CARD_TYPE_SD2:
      Serial.println("SD2");
      break;
    case SD_CARD_TYPE_SDHC:
      Serial.println("SDHC");
      break;
    default:
      Serial.println("Unknown");
  }

  // Now we will try to open the 'volume'/'partition' - it should be FAT16 or FAT32
  if (!volume.init(card)) {
    Serial.println("Could not find FAT16/FAT32 partition.\nMake sure you've formatted the card");
    while (1);
  }

  Serial.print("Clusters:          ");
  Serial.println(volume.clusterCount());
  Serial.print("Blocks x Cluster:  ");
  Serial.println(volume.blocksPerCluster());

  Serial.print("Total Blocks:      ");
  Serial.println(volume.blocksPerCluster() * volume.clusterCount());
  Serial.println();

  // print the type and size of the first FAT-type volume
  uint32_t volumesize;
  Serial.print("Volume type is:    FAT");
  Serial.println(volume.fatType(), DEC);

  volumesize = volume.blocksPerCluster();    // clusters are collections of blocks
  volumesize *= volume.clusterCount();       // we'll have a lot of clusters
  volumesize /= 2;                           // SD card blocks are always 512 bytes (2 blocks are 1KB)
  Serial.print("Volume size (Kb):  ");
  Serial.println(volumesize);
  Serial.print("Volume size (Mb):  ");
  volumesize /= 1024;
  Serial.println(volumesize);
  Serial.print("Volume size (Gb):  ");
  Serial.println((float)volumesize / 1024.0);

  Serial.println("\nFiles found on the card (name, date and size in bytes): ");
  root.openRoot(volume);

  // list all files in the card with date and size
  root.ls(LS_R | LS_DATE | LS_SIZE);


  // WRITING TO THE FILE
  myFile = SD.open("WRITE.TXT", FILE_WRITE); //E:\\USERINFO.TXT
  Serial.println(myFile);

  if (myFile) {
    Serial.println("Writing to file...");
    myFile.println("Testing 1, 2, 3, ...");
    myFile.close(); // close the file
    Serial.println("Done!");
  }
  else {
    Serial.print("error opening ");
    Serial.println("WRITE.TXT");
  }

  // READING FROM THE FILE
  myFile = SD.open("WRITE.TXT");
  if(myFile) {
    Serial.println("Read:");
    // Reading the whole file
    while (myFile.available()) {
      Serial.write(myFile.read());
    }
    myFile.close();
  }
  else {
    Serial.println("error opening WRITE.TXT");
  }

}

void loop(void) {
  //  if (myFile) {
  //    Serial.println("Read: ");
  //    while (myFile.available()) {
  //      Serial.write(myFile.read());
  //    }
  //    myFile.close();
  //  }
  //  else {
  //    Serial.println("error opening test.txt");
  //  }


  //  recvWithStartEndMarkers();
  //  if (newData == true) {
  //    strcpy(tempChars, receivedChars);
  //    // this temporary copy is necessary to protect the original data
  //    //   because strtok() used in parseData() replaces the commas with \0
  //    parseData();
  //    showParsedData();
  //    newData = false;
  //  }
  //
  //  Serial.println(" ");
  //  delay(2000);
}

void recvWithStartEndMarkers() {
  static boolean recvInProgress = false;
  static byte ndx = 0;
  char startMarker = '<';
  char endMarker = '>';
  char rc;

  while (Serial.available() > 0 && newData == false) {
    rc = Serial.read();

    if (recvInProgress == true) {
      if (rc != endMarker) {
        receivedChars[ndx] = rc;
        ndx++;
        if (ndx >= numChars) {
          ndx = numChars - 1;
        }
      }
      else {
        receivedChars[ndx] = '\0'; // terminate the string
        recvInProgress = false;
        ndx = 0;
        newData = true;
      }
    }

    else if (rc == startMarker) {
      recvInProgress = true;
    }
  }
}

void parseData() {      // split the data into its parts

  char * strtokIndx; // this is used by strtok() as an index

  strtokIndx = strtok(tempChars, ",");     // get the first part - the string
  strcpy(messageFromPC, strtokIndx); // copy it to messageFromPC

  strtokIndx = strtok(NULL, ","); // this continues where the previous call left off
  integerFromPC = atoi(strtokIndx);     // convert this part to an integer

  strtokIndx = strtok(NULL, ",");
  floatFromPC = atof(strtokIndx);     // convert this part to a float

}

//============

void showParsedData() {
  Serial.print("Message ");
  Serial.println(messageFromPC);
  Serial.print("Integer ");
  Serial.println(integerFromPC);
  Serial.print("Float ");
  Serial.println(floatFromPC);
}
