MH-Bio/vaccine_dispenser/Arduino Sketches/bmp_test/bmp_test.ino

#include <Adafruit_GFX.h>    // Core graphics library
#include <Adafruit_TFTLCD.h> // Hardware-specific library
#include <SD.h>
#include <SPI.h>
#include <MCUFRIEND_kbv.h>

// Define some pins
#define LCD_CS     A3 // Chip Select goes to Analog 3
#define LCD_CD     A2 // Command/Data goes to Analog 2
#define LCD_WR     A1 // LCD Write goes to Analog 1
#define LCD_RD     A0 // LCD Read goes to Analog 0
#define PIN_SD_CS  10 // Adafruit SD shields and modules: pin 10
#define LCD_RESET  A4 // Can alternately just connect to Arduino's reset pin

// Define some file limits
#define MAX_BMP         10  // bmp file num
#define FILENAME_LEN    20  // max file name length

// Pixel Definations
#define BUFFPIXEL       80                      // must be a divisor of 320 
#define BUFFPIXEL_X3    240                     // BUFFPIXELx3

// Define some colors
#define BLACK   0x0000
#define BLUE    0x001F
#define RED     0xF800
#define GREEN   0x07E0
#define CYAN    0x07FF
#define MAGENTA 0xF81F
#define YELLOW  0xFFE0
#define WHITE   0xFFFF

MCUFRIEND_kbv tft;

// Picture dimention definations
const int __Gnbmp_height = 153;                 // 320 bmp hight
const int __Gnbmp_width  = 107;                 // 240 bmp width
unsigned char __Gnbmp_image_offset  = 0;        // offset

// File related info
int __Gnfile_num = 1;                           // num of file
char __Gsbmp_files[1][FILENAME_LEN] = {"01.bmp",};
File bmpFile;

void bmpdraw(File f, int x, int y) {
  bmpFile.seek(__Gnbmp_image_offset);

  uint32_t time = millis();

  uint8_t sdbuffer[BUFFPIXEL_X3];                 // 3 * pixels to buffer

  for (int i = 0; i < __Gnbmp_height; i++) {
    for (int j = 0; j < (__Gnbmp_height / BUFFPIXEL); j++) {
      bmpFile.read(sdbuffer, BUFFPIXEL_X3);

      uint8_t buffidx = 0;
      int offset_x = j * BUFFPIXEL;
      unsigned int __color[BUFFPIXEL];

      for (int k = 0; k < BUFFPIXEL; k++) {
        __color[k] = sdbuffer[buffidx + 2] >> 3;                    // read
        __color[k] = __color[k] << 6 | (sdbuffer[buffidx + 1] >> 2); // green
        __color[k] = __color[k] << 5 | (sdbuffer[buffidx + 0] >> 3); // blue

        buffidx += 3;
      }

      for (int m = 0; m < BUFFPIXEL; m ++) {
        tft.drawPixel(m + offset_x, i, __color[m]);
      }
    }
  }
  Serial.print(millis() - time, DEC);
  Serial.println(" ms");
}


boolean bmpReadHeader(File f) {
  // read header
  uint32_t tmp;
  uint8_t bmpDepth;

  if (read16(f) != 0x4D42) {
    // magic bytes missing
    return false;
  }

  // read file size
  tmp = read32(f);
  Serial.print("size 0x");
  Serial.println(tmp, HEX);

  // read and ignore creator bytes
  read32(f);

  __Gnbmp_image_offset = read32(f);
  Serial.print("offset ");
  Serial.println(__Gnbmp_image_offset, DEC);

  // read DIB header
  tmp = read32(f);
  Serial.print("header size ");
  Serial.println(tmp, DEC);

  int bmp_width = read32(f);
  int bmp_height = read32(f);

  if (bmp_width != __Gnbmp_width || bmp_height != __Gnbmp_height)  {   // if image is not 320x240, return false
    return false;
  }

  if (read16(f) != 1)
    return false;

  bmpDepth = read16(f);
  Serial.print("bitdepth ");
  Serial.println(bmpDepth, DEC);

  if (read32(f) != 0) {
    // compression not supported!
    return false;
  }

  Serial.print("compression ");
  Serial.println(tmp, DEC);

  return true;
}
/*********************************************/
// These read data from the SD card file and convert them to big endian
// (the data is stored in little endian format!)

// LITTLE ENDIAN!
uint16_t read16(File f) {
  uint16_t d;
  uint8_t b;
  b = f.read();
  d = f.read();
  d <<= 8;
  d |= b;
  return d;
}


// LITTLE ENDIAN!
uint32_t read32(File f) {
  uint32_t d;
  uint16_t b;

  b = read16(f);
  d = read16(f);
  d <<= 16;
  d |= b;
  return d;
}


void setup() {
  Serial.begin(9600);
  Serial.println(F("TFT LCD test"));

  tft.reset();

  uint16_t identifier = tft.readID();
  tft.begin(identifier);

  //Init SD_Card
  pinMode(10, OUTPUT);

  if (!SD.begin(10)) {
    Serial.println("initialization failed!");
    tft.setCursor(0, 0);
    tft.setTextColor(WHITE);
    tft.setTextSize(1);
    tft.println("SD Card Init fail.");
  }
  else {
    Serial.println("initialization done.");
  }

}

void loop() {
  for (unsigned char i = 0; i < __Gnfile_num; i++) {
    bmpFile = SD.open(__Gsbmp_files[i]);
    if (! bmpFile) {
      Serial.println("didnt find image");
      tft.setTextColor(WHITE);    tft.setTextSize(2);
      tft.println("didnt find BMPimage");
      while (1);
    }

    if (! bmpReadHeader(bmpFile)) {
      Serial.println("bad bmp");
      tft.setTextColor(WHITE);    tft.setTextSize(1);
      tft.println("bad bmp");
      return;
    }

    bmpdraw(bmpFile, 0, 0);
    bmpFile.close();
    delay(1000);
    delay(1000);
  }
}
