MH-Bio/vaccine_dispenser/TFT Stuff/Libraries-Examples_RTP_ER-TFTM050-2/Examples/easyPaint/easyPaint.ino

/***************************************************
//Web: http://www.buydisplay.com
EastRising Technology Co.,LTD
Examples for ER-TFTM050-2 
Hardware SPI,4-Wire SPI Interface,5V Power Supply

This version use the new resistive touch screen functions, much easier!
Did you have already calibrated your screen? Better do as soon you can
Open TouchScreenCalibration example and follow instructions.
Tested and worked with:
Teensy3,Teensy3.1,Arduino UNO,Arduino YUN,Arduino Leonardo,Stellaris
Works with Arduino 1.6.0 IDE
****************************************************/


#include <SPI.h>
#include <RA8875.h>

//Arduino DUE,Arduino mega2560,Arduino UNO
#define RA8875_INT 4 
#define RA8875_CS 10 

#define RA8875_RESET 9

//#if defined(NEEDS_SET_MODULE)//Energia, this case is for stellaris/tiva

//RA8875 tft = RA8875(3);//select SPI module 3
/*
for module 3 (stellaris)
SCLK:  PD_0
MOSI:  PD_3
MISO:  PD_2
SS:    PD_1
*/
//#else

RA8875 tft = RA8875(RA8875_CS,RA8875_RESET);//Teensy3/arduino's

//#endif

uint16_t tx, ty;


void interface(){
  tft.fillRect(10,10,40,40,RA8875_WHITE);
  tft.fillRect(10+(40*1)+(10*1),10,40,40,RA8875_BLUE);
  tft.fillRect(10+(40*2)+(10*2),10,40,40,RA8875_RED);
  tft.fillRect(10+(40*3)+(10*3),10,40,40,RA8875_GREEN);
  tft.fillRect(10+(40*4)+(10*4),10,40,40,RA8875_CYAN);
  tft.fillRect(10+(40*5)+(10*5),10,40,40,RA8875_MAGENTA);
  tft.fillRect(10+(40*6)+(10*6),10,40,40,RA8875_YELLOW);
  tft.drawRect(10+(40*7)+(10*7),10,40,40,RA8875_WHITE);
}

void setup() 
{
  Serial.begin(9600);
  //while (!Serial) {;}
  Serial.println("RA8875 start");

   tft.begin(RA8875_480x272);

  tft.touchBegin(RA8875_INT);//enable Touch support!
  interface();
}

uint16_t choosenColor = 0;

void loop() 
{    tft.changeMode(TEXT);
   tft.setTextColor(RA8875_WHITE);
  tft.setCursor (0, 50); 
  tft.print ("www.buydisplay.com");
    tft.setCursor (600, 0); 
    tft.changeMode(GRAPHIC);
    
  if (tft.touchDetect()){//easy!
      tft.touchReadPixel(&tx, &ty);//read directly in pixel!
        tx=tx;ty=ty;
      if (ty >= 0 && ty <= 55){ //interface area
        if ((tx > 10 && tx < (10+40))){
          choosenColor = RA8875_WHITE;
          interface();
          tft.fillRect(10,10,40,40,RA8875_BLACK);
          tft.fillCircle(tft.width()-10,10,5,choosenColor);
        } 
        else if ((tx > 10+(40*1)+(10*1) && tx < 10+(40*2)+(10*1))){
          choosenColor = RA8875_BLUE;
          interface();
          tft.fillRect(10+(40*1)+(10*1),10,40,40,RA8875_BLACK);
          tft.fillCircle(tft.width()-10,10,5,choosenColor);
        } 
        else if ((tx > 10+(40*2)+(10*2) && tx < 10+(40*3)+(10*2))){
          choosenColor = RA8875_RED;  
          interface();
          tft.fillRect(10+(40*2)+(10*2),10,40,40,RA8875_BLACK);
          tft.fillCircle(tft.width()-10,10,5,choosenColor);
        } 
        else if ((tx > 10+(40*3)+(10*3) && tx < 10+(40*4)+(10*3))){
          choosenColor = RA8875_GREEN;  
          interface();
          tft.fillRect(10+(40*3)+(10*3),10,40,40,RA8875_BLACK);
          tft.fillCircle(tft.width()-10,10,5,choosenColor);
        } 
        else if ((tx > 10+(40*4)+(10*4) && tx < 10+(40*5)+(10*4))){
          choosenColor = RA8875_CYAN;  
          interface();
          tft.fillRect(10+(40*4)+(10*4),10,40,40,RA8875_BLACK);
          tft.fillCircle(tft.width()-10,10,5,choosenColor);
        } 
        else if ((tx > 10+(40*5)+(10*5) && tx < 10+(40*6)+(10*5))){
          choosenColor = RA8875_MAGENTA;  
          interface();
          tft.fillRect(10+(40*5)+(10*5),10,40,40,RA8875_BLACK);
          tft.fillCircle(tft.width()-10,10,5,choosenColor);
        } 
        else if ((tx > 10+(40*6)+(10*6) && tx < 10+(40*7)+(10*6))){
          choosenColor = RA8875_YELLOW;  
          interface();
          tft.fillRect(10+(40*6)+(10*6),10,40,40,RA8875_BLACK);
          tft.fillCircle(tft.width()-10,10,5,choosenColor);
        } 
        else if ((tx > 10+(40*7)+(10*7) && tx < 10+(40*8)+(10*7))){
          choosenColor = 0;  
          interface();
          tft.fillRect(0,52,tft.width()-1,tft.height()-53,RA8875_BLACK);
          tft.fillCircle(tft.width()-10,10,5,RA8875_BLACK);
        }
      } else { //paint
        //if (choosenColor != 0) tft.fillCircle(tx,ty,1,choosenColor);
        if (choosenColor != 0) tft.drawPixel(tx,ty,choosenColor);
      }
  }
}
